tanaes/whopping_Voron_mods/Z_belt_cable_cover/README.md

# Z belt cover with cable routing

Made these to enable safe routing of cables up into the corner extrusions. 

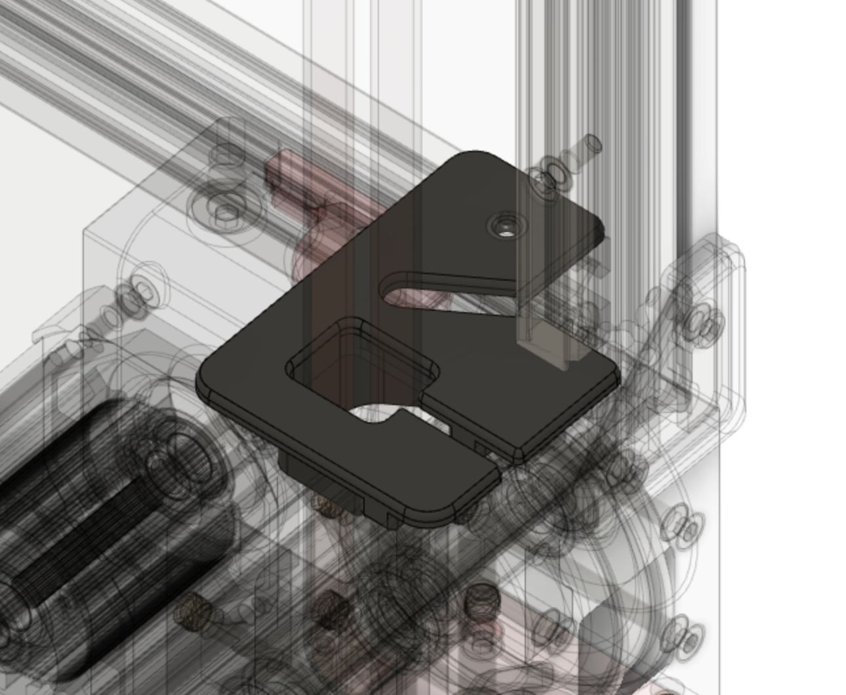
[picture p57: Z_belt_cable_cover/images/above.png]

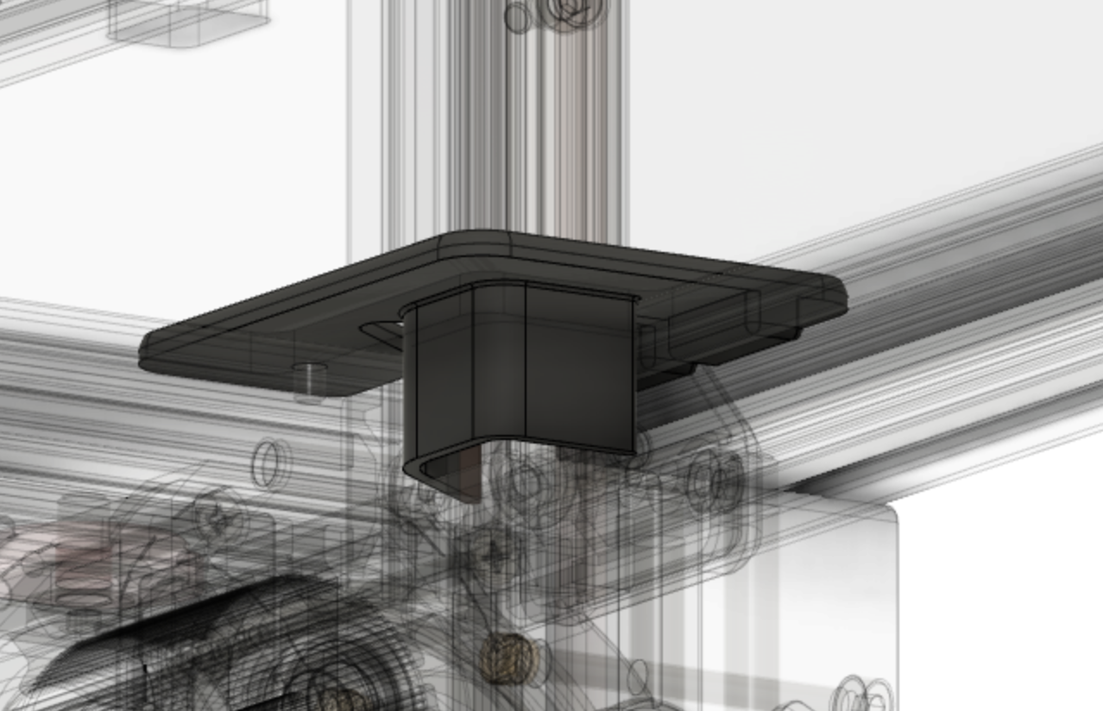
[picture p58: Z_belt_cable_cover/images/below.png]
