tanaes/whopping_Voron_mods/docs/frame_expansion/README.md

# Frame Thermal Compensation Documentation

This here's a compendium of my testing of alchemyEngine's awesome [frame expansion compensation](https://github.com/alchemyEngine/klipper/tree/work-frame-expansion-20210410) code for Klipper. 

## Installation overview and results

[How I got things up and running](./frame_thermal_compensation_howto.md) on my V2.4x350, plus test results.

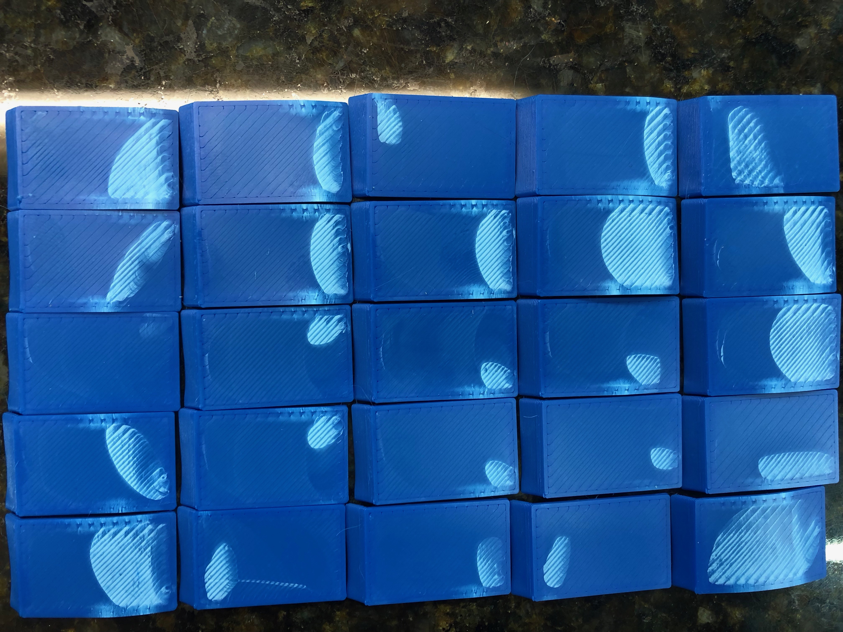
[picture p65: docs/frame_expansion/figures/test_print-si_comp-hot-bottom.jpeg]


## Data analysis

[Some R code I wrote](./gantry_factor_calc.html) to explore the results of my data

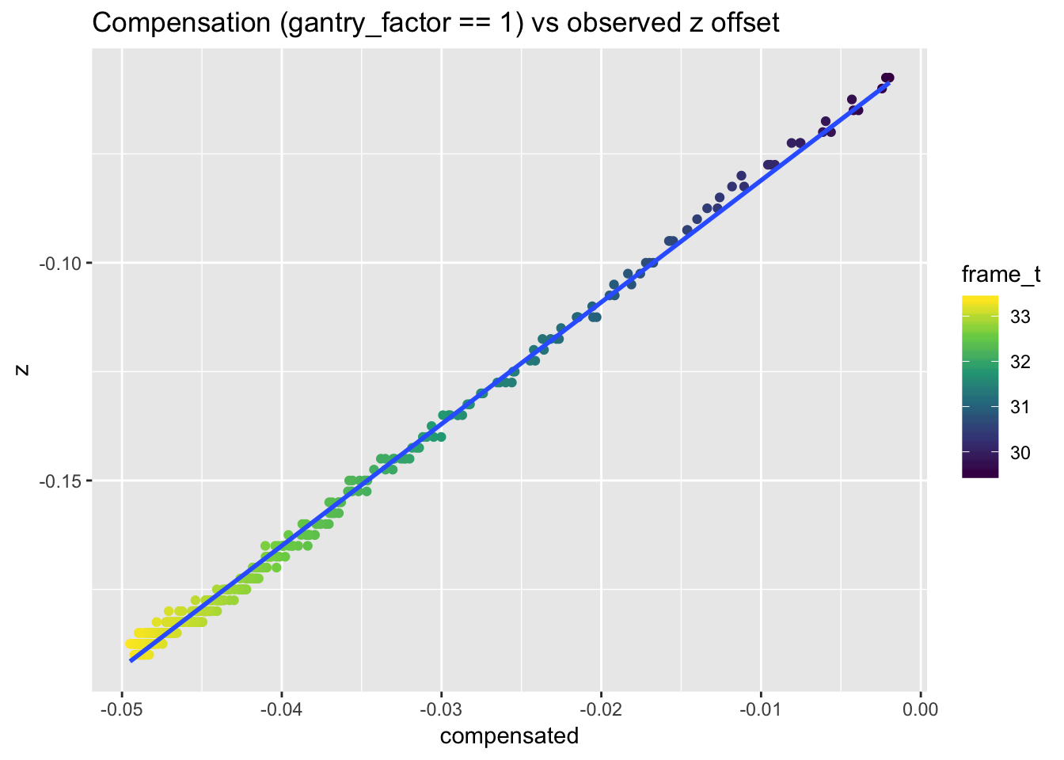
[picture p66: docs/frame_expansion/figures/gantry_factor.png]
