tanaes/whopping_Voron_mods/GE5C/mods/garyd9/README.md

Alternate version of WP's GE5C mod...

THIS MODIFICATION DOES NOT WORK WITH THE HALL EFFECT SENSOR.  

The objectives of this modification were to:

1. Allow the use of a M5x20 button head screw instead of the M5x25 socket head

2. To remove the need for more than 1 M5 shim per joint

3. Provide room for loosening and tightening the M3 screw in the "z belt clip lower" while everything is assembled. (This allows re-squaring the gantry while everything is assembled.)

Installation instructions are similar to WP's modification with the following changes:  The included "z belt clip lower" part should be used instead of the normal one.  Use a M5x20 button head (a socket head would also work) screw instead of the M5x25 SHCS, use a M3x12 socket or button head as the second screw for the "z belt clip lower", and only use a single 1mm M5 shim per corner.
