tanaes/whopping_Voron_mods/extrusion_backers/images/sim_450_3mm.png

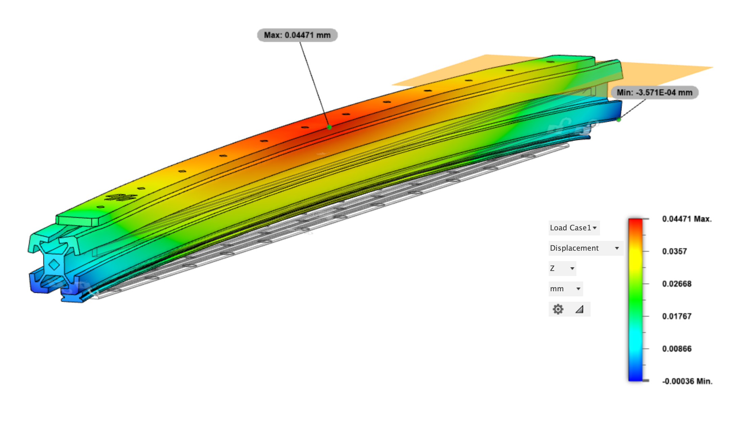
extrusion_backers/images/sim_450_3mm.png
