tanaes/whopping_Voron_mods/extrusion_backers/images/sim_450_mgn9.png

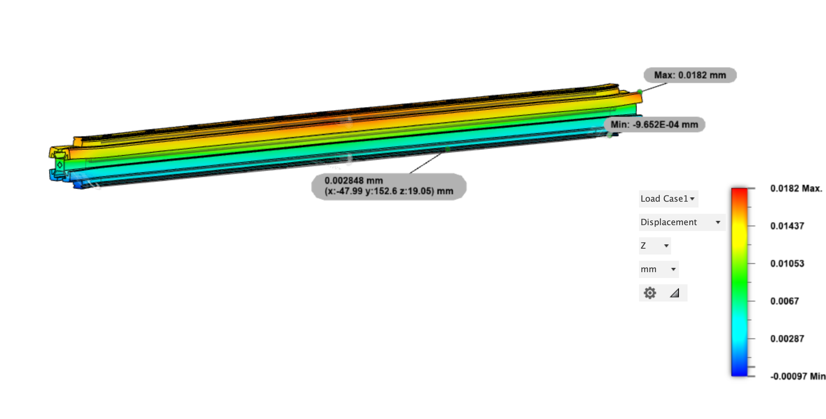
extrusion_backers/images/sim_450_mgn9.png
