tanaes/whopping_Voron_mods/extrusion_backers/images/sim_450_nobacker.png

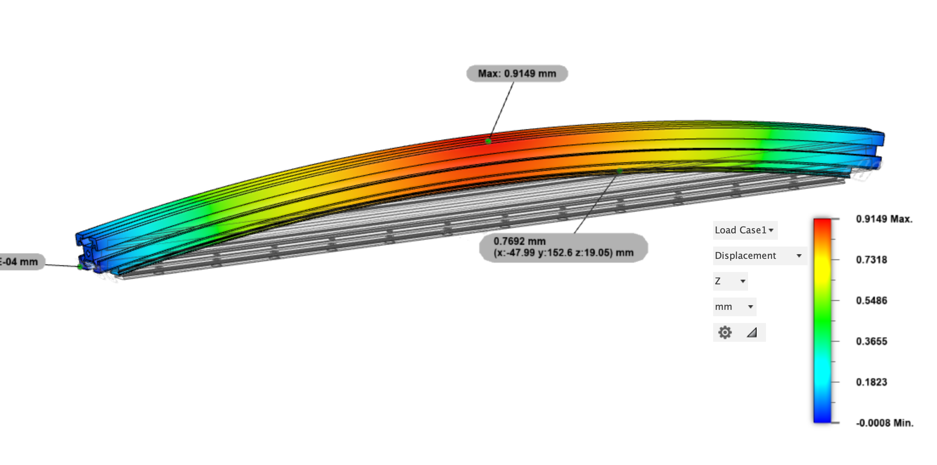
extrusion_backers/images/sim_450_nobacker.png
