tanaes/whopping_Voron_mods/GE5C/Images/hall_effect.png

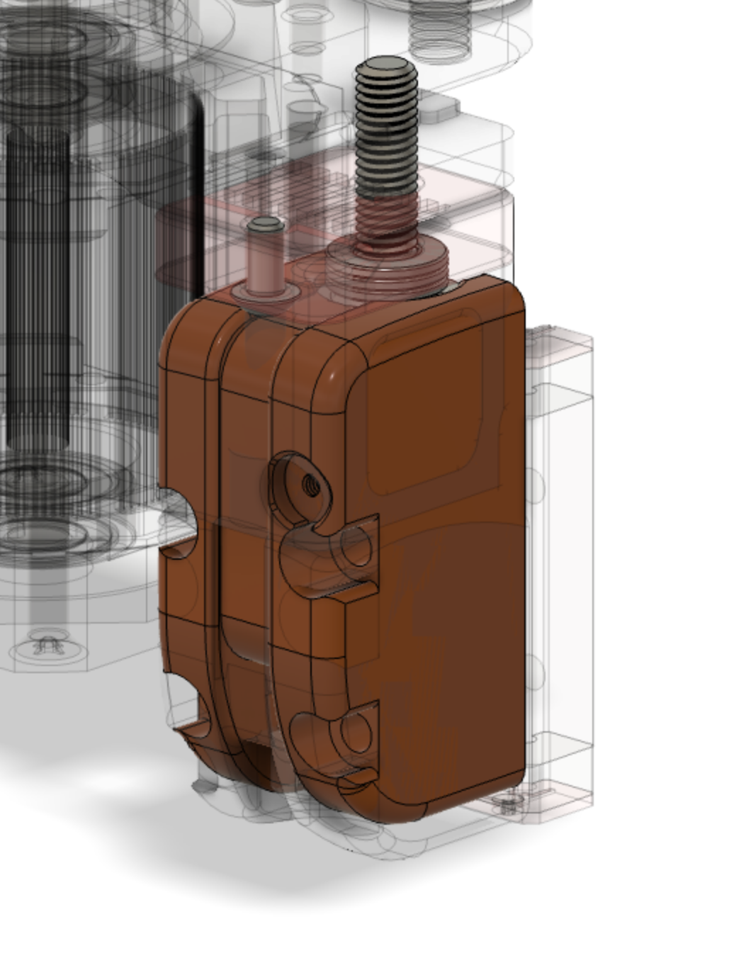
GE5C/Images/hall_effect.png
