tanaes/whopping_Voron_mods/GE5C/Images/screw_clearance.png

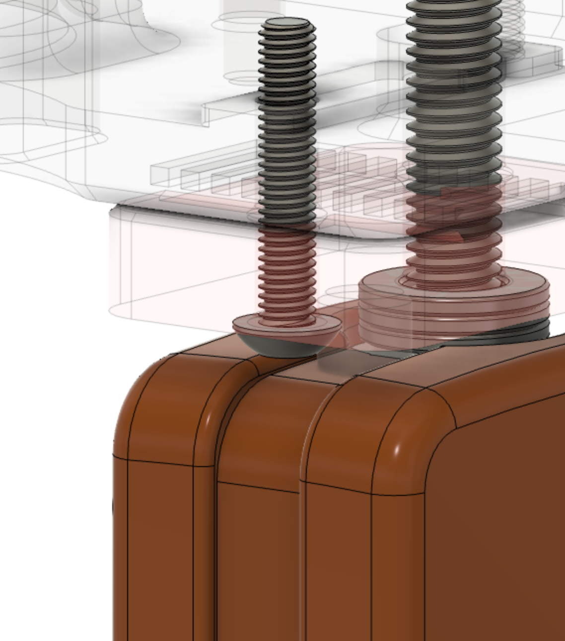
GE5C/Images/screw_clearance.png
