tanaes/whopping_Voron_mods/kinematesque_bed/images/detail.png

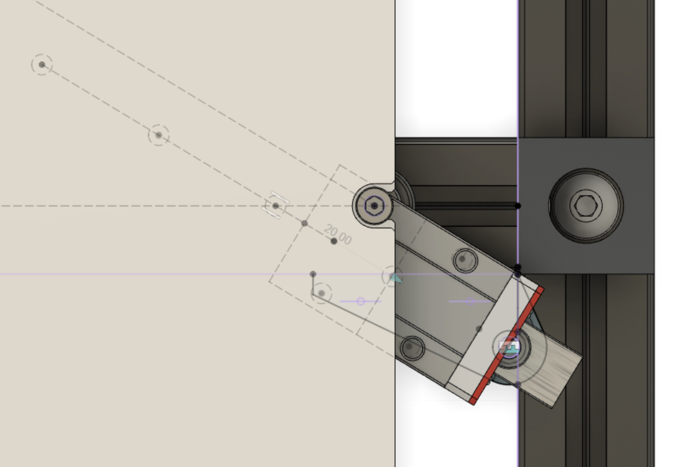
kinematesque_bed/images/detail.png
