tanaes/whopping_Voron_mods/kinematesque_bed/images/front.png

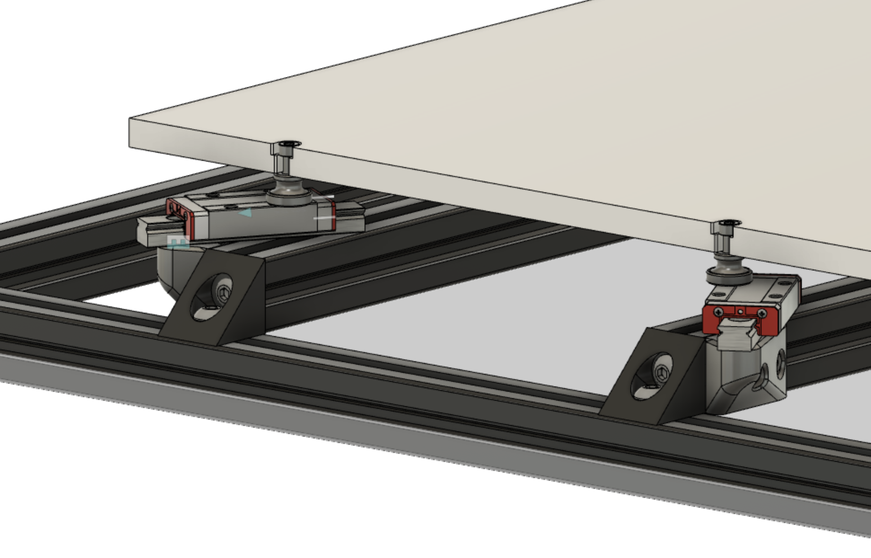
kinematesque_bed/images/front.png
