tanaes/whopping_Voron_mods/kinematesque_bed/images/overview.png

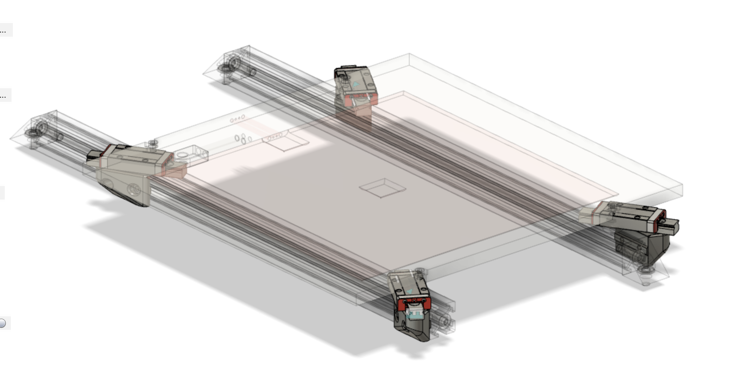
kinematesque_bed/images/overview.png
