tanaes/whopping_Voron_mods/kinematesque_bed/images/plan.png

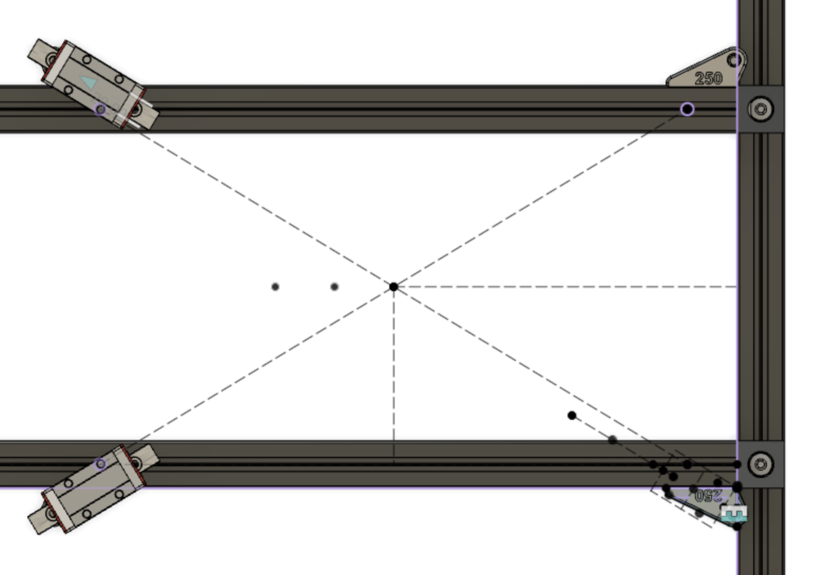
kinematesque_bed/images/plan.png
