tanaes/whopping_Voron_mods/kinematic_bed/Images/Screen Shot 2021-11-20 at 7.35.48 PM.png

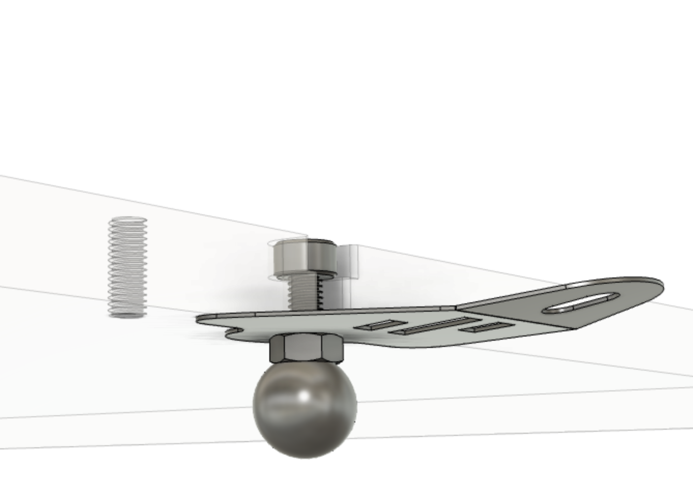
kinematic_bed/Images/Screen Shot 2021-11-20 at 7.35.48 PM.png
