tanaes/whopping_Voron_mods/kinematic_bed/Images/spring_bend.png

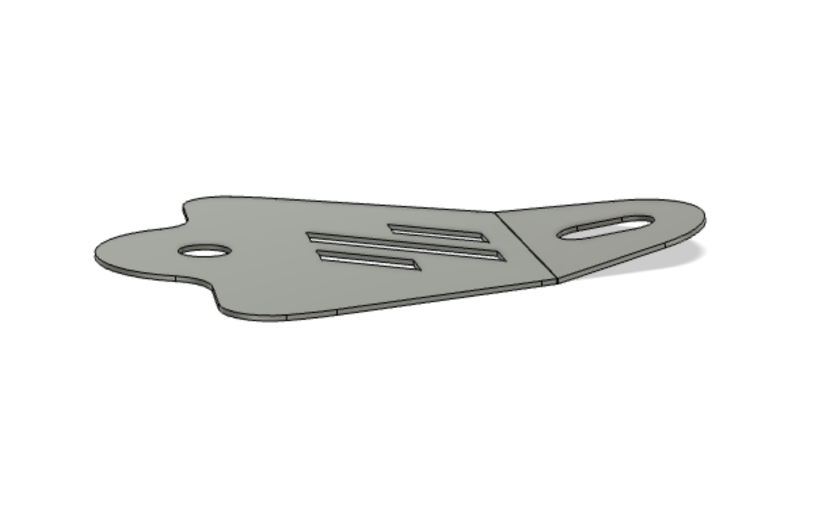
kinematic_bed/Images/spring_bend.png
