tanaes/whopping_Voron_mods/pcb_klicky/Images/bottom_comparison.png

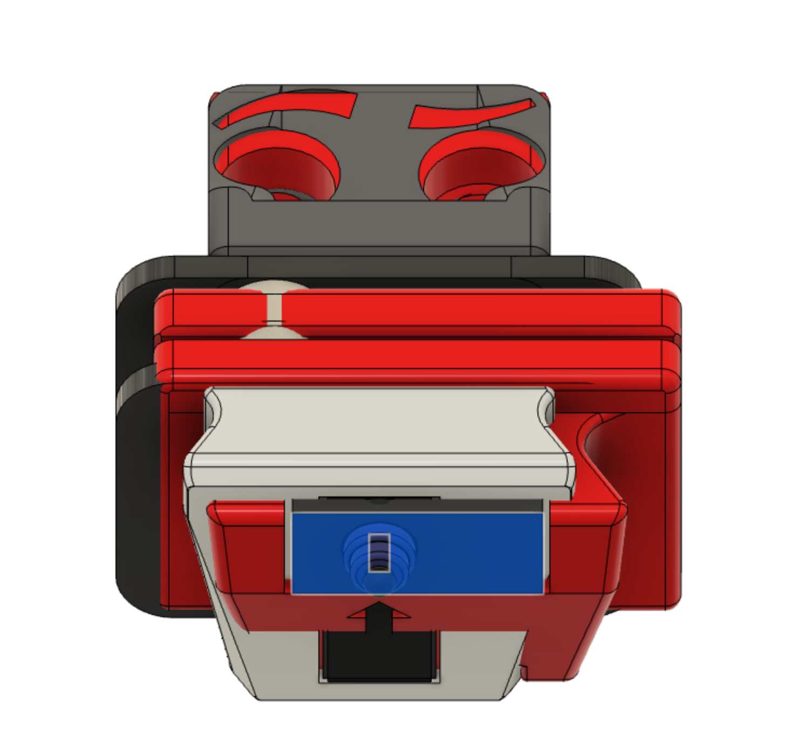
pcb_klicky/Images/bottom_comparison.png
