tanaes/whopping_Voron_mods/pcb_klicky/Images/bottom_elevation.png

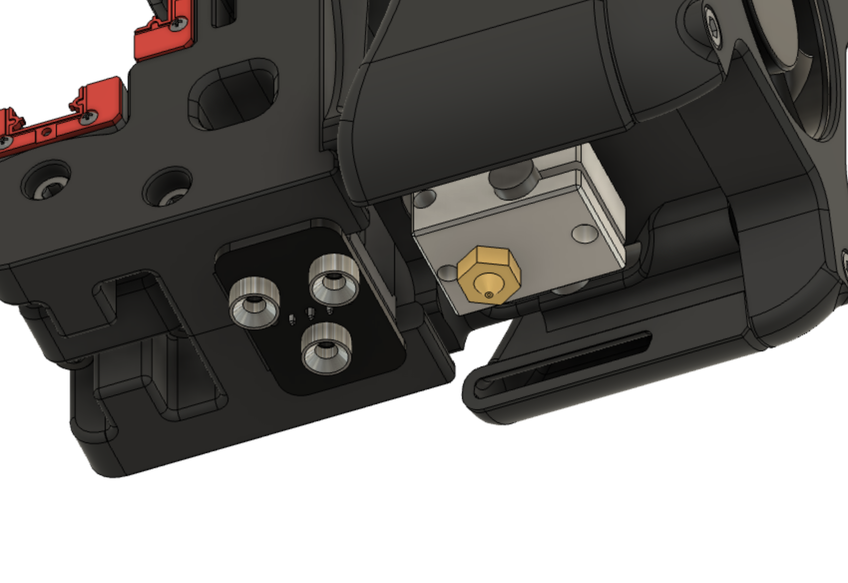
pcb_klicky/Images/bottom_elevation.png
