tanaes/whopping_Voron_mods/pcb_klicky/Images/bottom_view.png

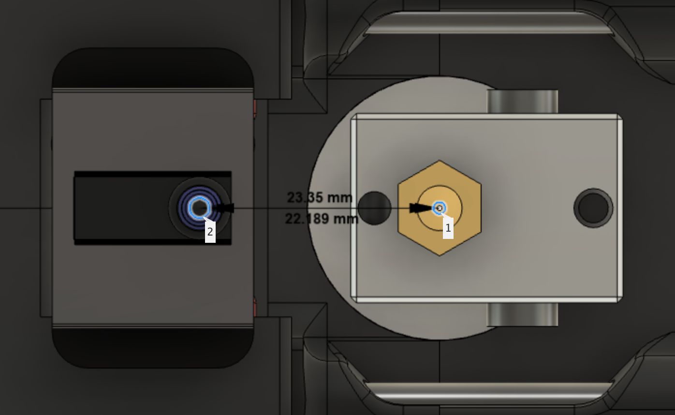
pcb_klicky/Images/bottom_view.png
