tanaes/whopping_Voron_mods/pcb_klicky/Images/front_view.png

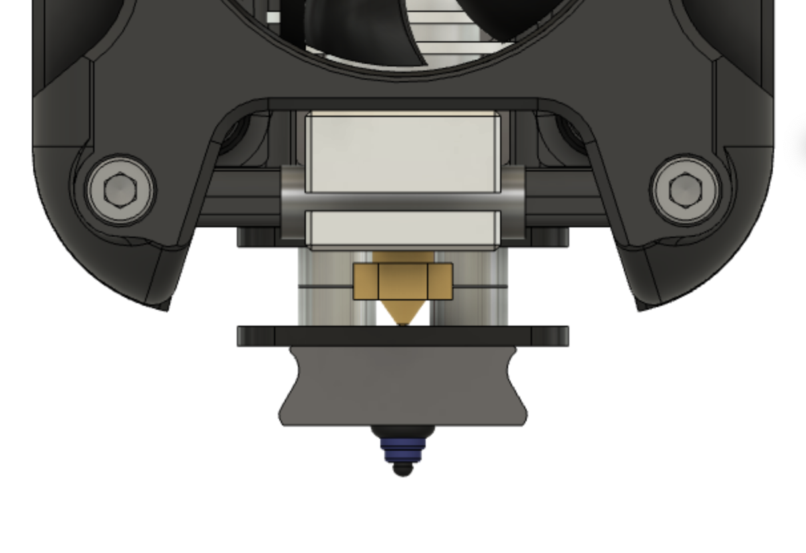
pcb_klicky/Images/front_view.png
