tanaes/whopping_Voron_mods/pcb_klicky/Images/perspective_snowy.png

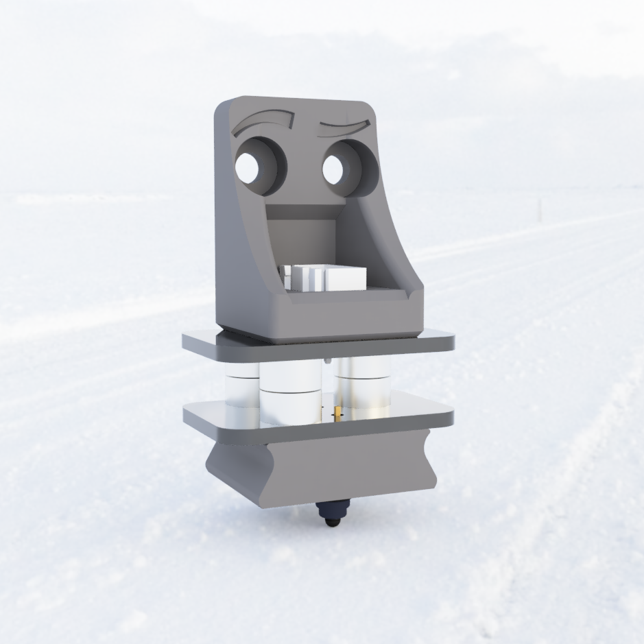
pcb_klicky/Images/perspective_snowy.png
