tanaes/whopping_Voron_mods/pcb_klicky/Images/side_view.png

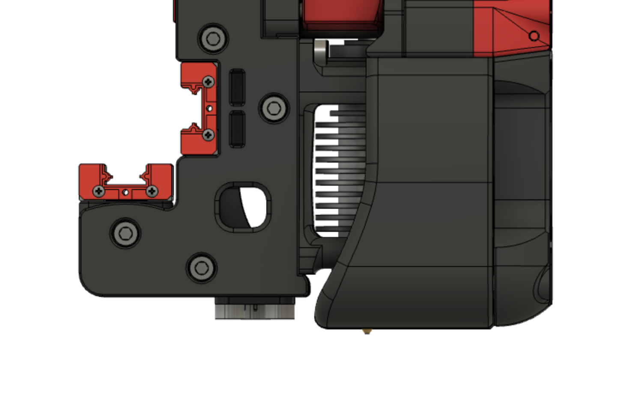
pcb_klicky/Images/side_view.png
