tanaes/whopping_Voron_mods/LEDs/Rainbow_Barf_Logo_LED/Production_Files/bom.csv

Comment | Designator | Footprint | LCSC Part Number
100nF | C1 | 0402 | C307331
470R | R1 | 0402 | C25117
WS2812B-2020 | D1 | 2.0x2.0mm | C965555
WS2812B-2020 | D2 | 2.0x2.0mm | C965555
WS2812B-2020 | D3 | 2.0x2.0mm | C965555
WS2812B-2020 | D4 | 2.0x2.0mm | C965555
WS2812B-2020 | D5 | 2.0x2.0mm | C965555
WS2812B-2020 | D6 | 2.0x2.0mm | C965555
WS2812B-2020 | D7 | 2.0x2.0mm | C965555
WS2812B-2020 | D8 | 2.0x2.0mm | C965555
