tanaes/whopping_Voron_mods/pcb_klicky/PCB_Klicky_rev3/PCB_Klicky_rev3/gerber/Klicky_PCB_-_SMD_BOM.csv

Comment | Designator | Footprint | LCSC Part Number
2.2K | R1 | 0603 | C4190
470R | R2 | 0603 | C23179
470R | R3 | 0603 | C23179
Red LED | D1 | LED_0603 | C2286
