tanaes/whopping_Voron_mods/pcb_klicky/PCB_Klicky_rev3/PCB_Klicky_rev3/jlcpcb/assembly/BOM-Untitled.csv

Comment | Designator | Footprint | LCSC
LTST-C191TBKT | D1 | D_0603_1608Metric | C2286
200 | R2 | R_0603_1608Metric | C22962
2K1 | R1 | R_0603_1608Metric | C4190
