tanaes/whopping_Voron_mods/badge/graphcis/badge_outline.dxf

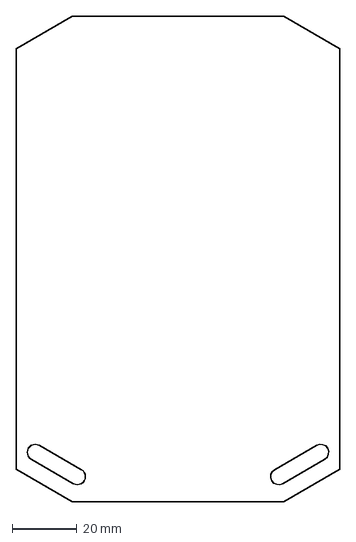
[picture p85: CAD file, 2023-05-02]
badge/graphcis/badge_outline.dxf
100.0 x 150.0 mm
