tanaes/whopping_Voron_mods/badge/voron_badge/voron_badge-back.3mf

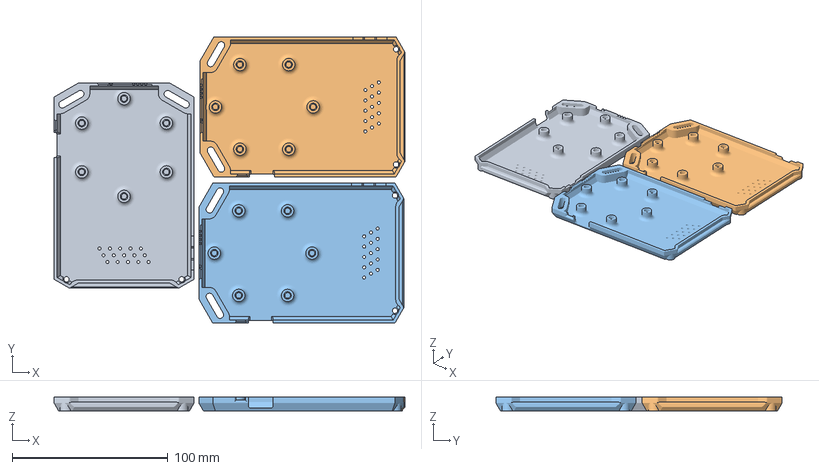
[picture p86: CAD file, 2023-05-02]
badge/voron_badge/voron_badge-back.3mf
225.5 x 183.9 x 9.00 mm
voron_badge-back.stl x 3
