tanaes/whopping_Voron_mods/clickyclacky_door/STLs/Latch.stl

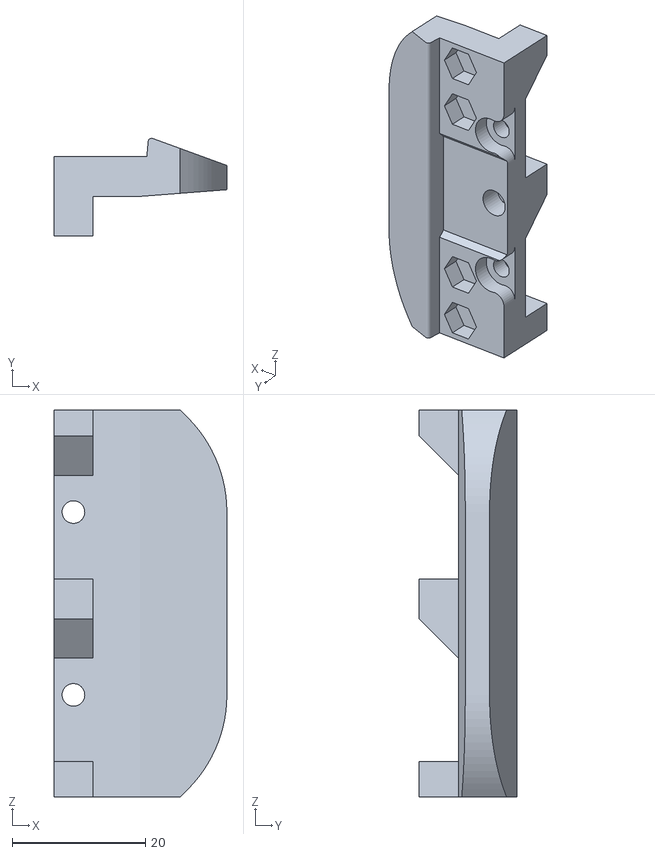
[picture p87: CAD file, 2023-10-13]
clickyclacky_door/STLs/Latch.stl
25.9 x 14.6 x 58.0
