tanaes/whopping_Voron_mods/docs/frame_expansion/gcode/expansion_test_print-Voron_ABS.3mf

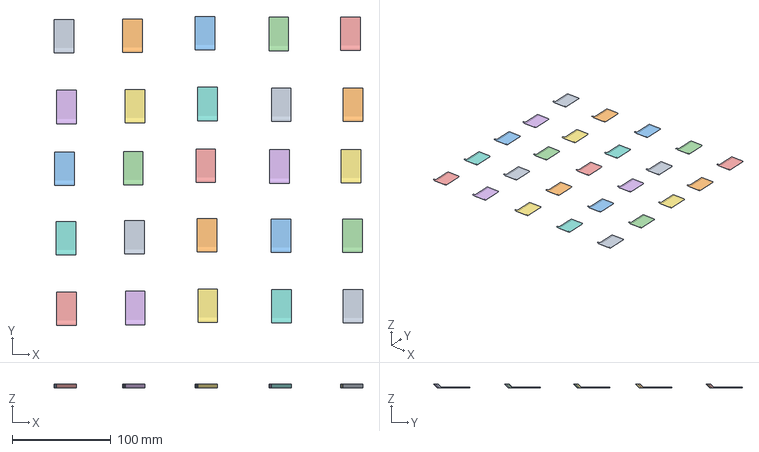
[picture p88: CAD file, 2021-06-14]
docs/frame_expansion/gcode/expansion_test_print-Voron_ABS.3mf
312.5 x 312.5 x 4.00 mm
test_sample v1.stl x 25
