tanaes/whopping_Voron_mods/docs/frame_expansion/stls/test_sample v1.stl

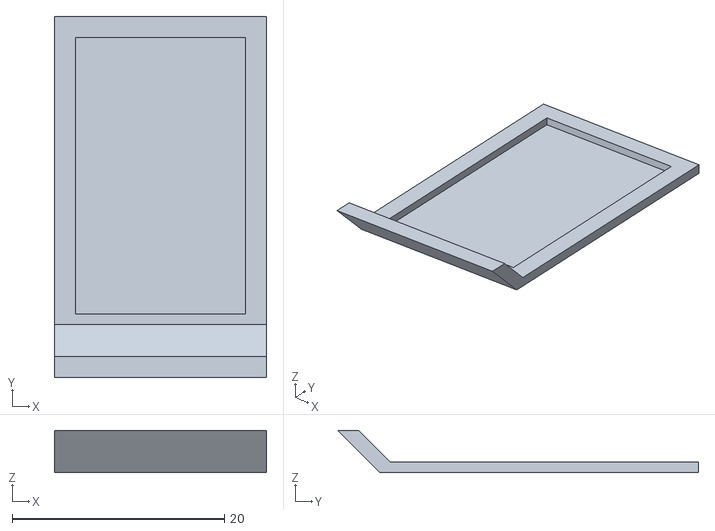
[picture p89: CAD file, 2021-06-14]
docs/frame_expansion/stls/test_sample v1.stl
20.0 x 34.0 x 4.00
