tanaes/whopping_Voron_mods/extrusion_backers/DXFs/Y_backer_chain-350.dxf

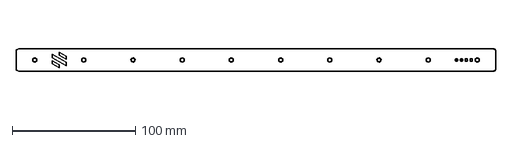
[picture p90: CAD file, 2023-05-09]
extrusion_backers/DXFs/Y_backer_chain-350.dxf
390.0 x 18.0 mm
