tanaes/whopping_Voron_mods/GE5C/mods/garyd9/GE5C_Z_carrier_x4.stl

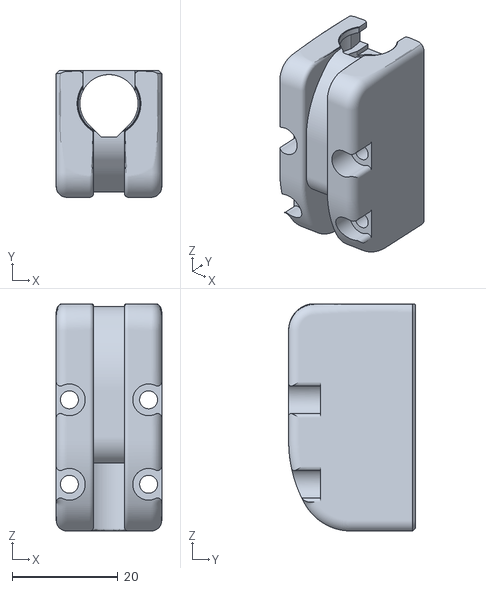
[picture p92: CAD file, 2022-04-04]
GE5C/mods/garyd9/GE5C_Z_carrier_x4.stl
20.0 x 24.0 x 43.0
