tanaes/whopping_Voron_mods/GE5C/STLs/GE5C_Z_carrier.stl

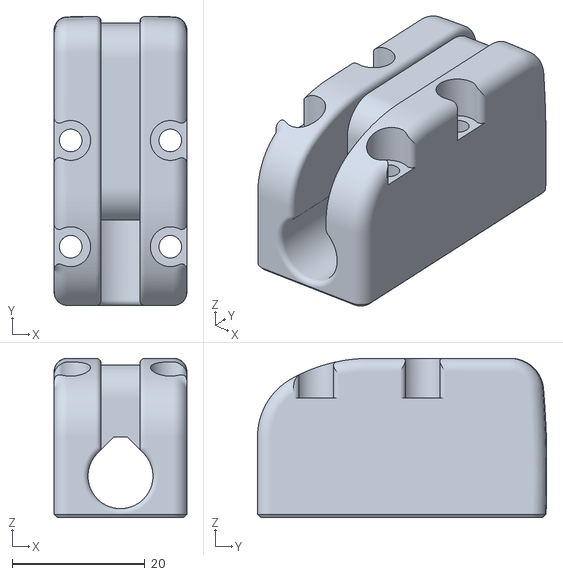
[picture p93: CAD file, 2022-03-22]
GE5C/STLs/GE5C_Z_carrier.stl
20.0 x 43.5 x 24.0
