tanaes/whopping_Voron_mods/kinematesque_bed/STLs/LFRB_mount-250.stl

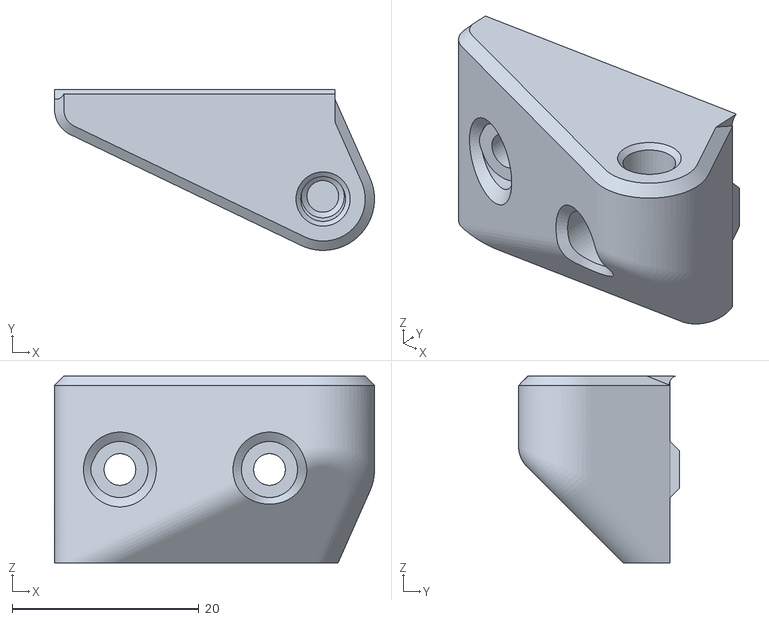
[picture p94: CAD file, 2022-01-17]
kinematesque_bed/STLs/LFRB_mount-250.stl
34.2 x 17.2 x 20.0
