tanaes/whopping_Voron_mods/kinematic_bed/DXFs/Trident/Trident_kinematic-left.step

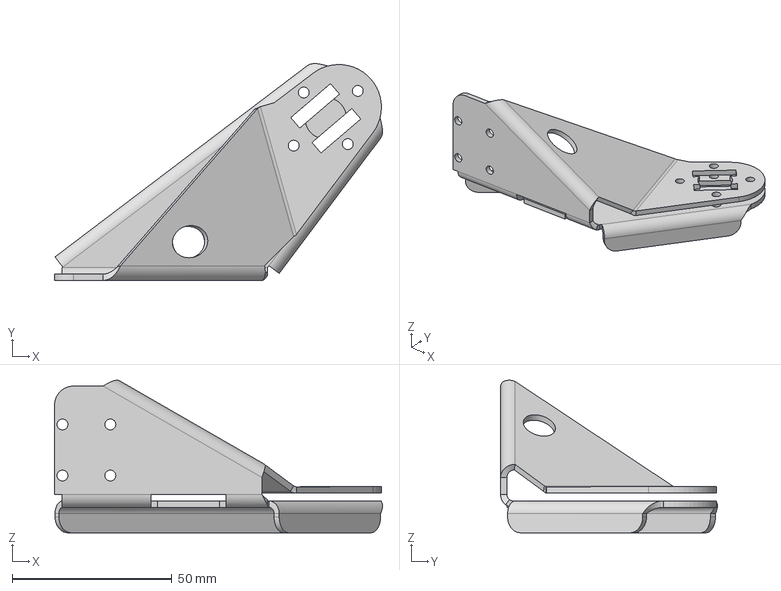
[picture p95: CAD file, 2022-04-28]
kinematic_bed/DXFs/Trident/Trident_kinematic-left.step
102.8 x 67.9 x 47.8 mm
