tanaes/whopping_Voron_mods/kinematic_bed/DXFs/v24/F-back_bottom.dxf

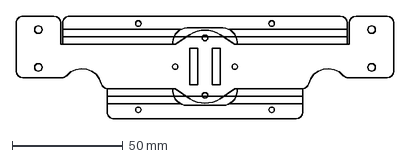
[picture p96: CAD file, 2022-04-04]
kinematic_bed/DXFs/v24/F-back_bottom.dxf
170.1 x 46.1 mm
