tanaes/whopping_Voron_mods/LEDs/Rainbow_Barf_Logo_LED/STLs/led_carrier_rev2.stl

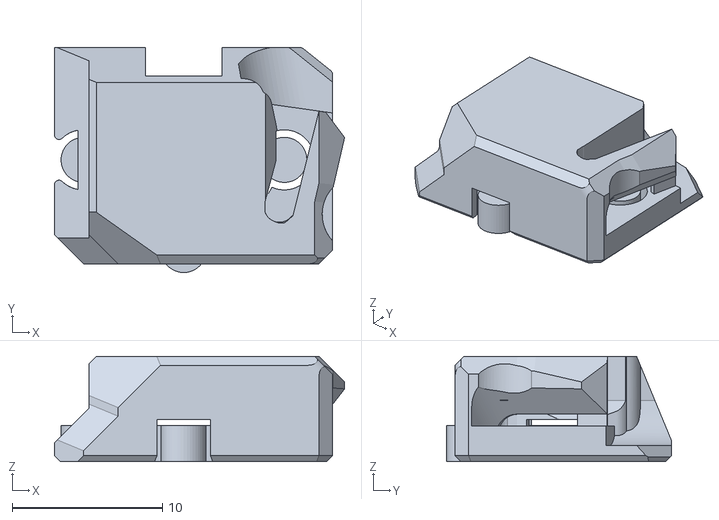
[picture p97: CAD file, 2022-10-07]
LEDs/Rainbow_Barf_Logo_LED/STLs/led_carrier_rev2.stl
19.3 x 15.0 x 7.01
