tanaes/whopping_Voron_mods/panel_clip_shims/STLs/corner_clip-5.5mm.stl

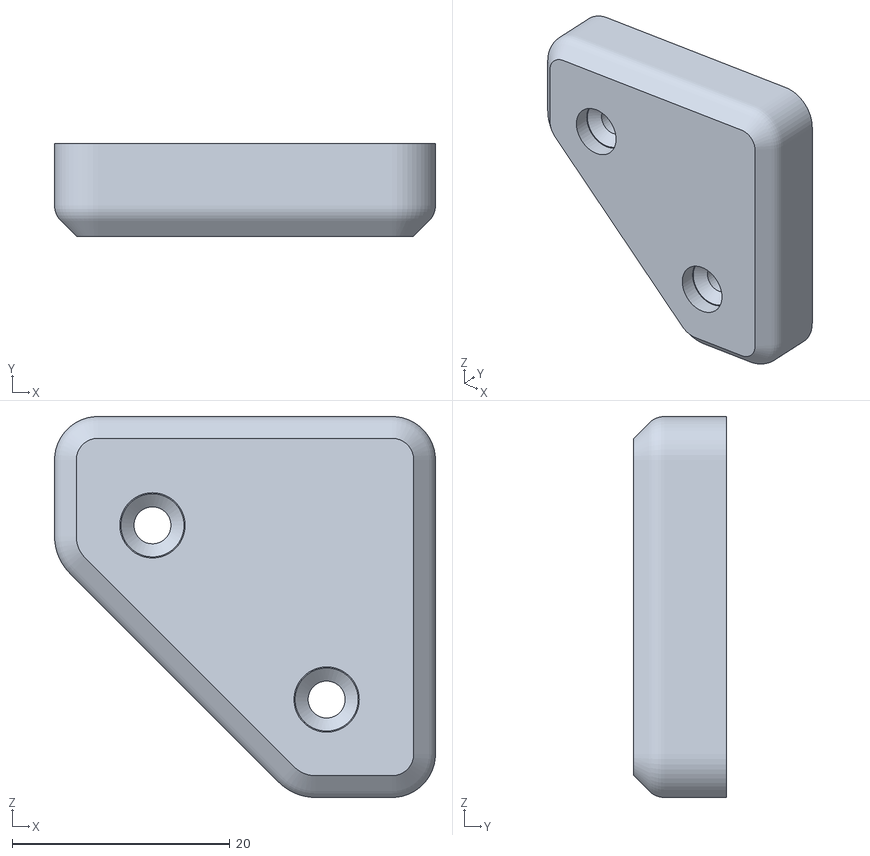
[picture p98: CAD file, 2021-09-21]
panel_clip_shims/STLs/corner_clip-5.5mm.stl
35.0 x 8.50 x 35.0
