tanaes/whopping_Voron_mods/pcb_klicky/STLs/probe-heatset-XL.stl

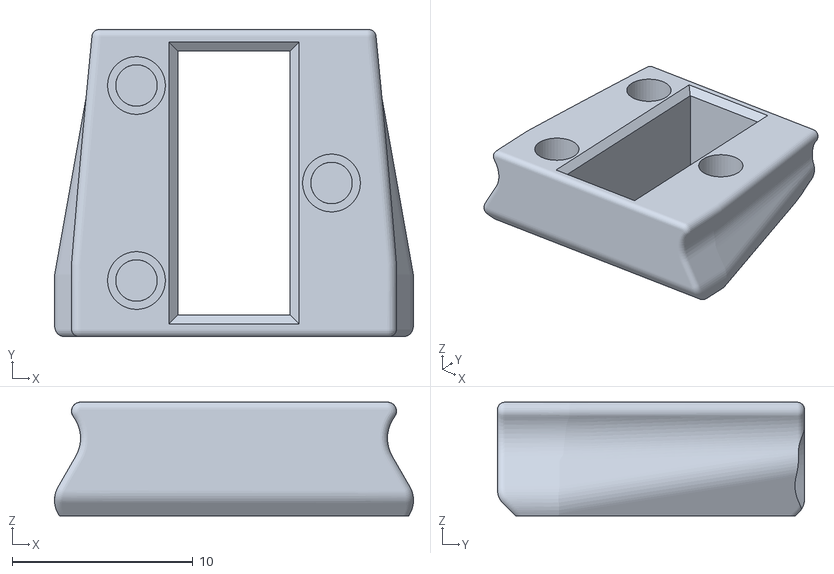
[picture p99: CAD file, 2022-11-02]
pcb_klicky/STLs/probe-heatset-XL.stl
19.9 x 17.0 x 6.30
