tanaes/whopping_Voron_mods/side_skirts/STLs/side_skirt-plug_panel-350.stl

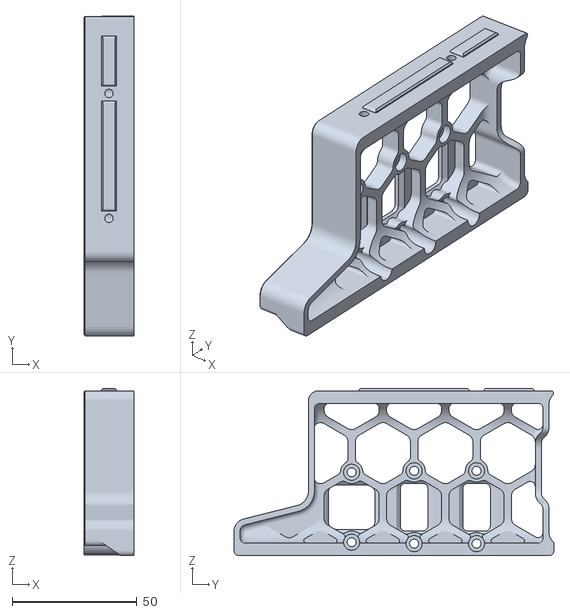
[picture p100: CAD file, 2021-06-11]
side_skirts/STLs/side_skirt-plug_panel-350.stl
20.0 x 128.1 x 67.0
