tanaes/whopping_Voron_mods/umbilical_passthrough/STLs/PG7_cable_gland_housing.stl

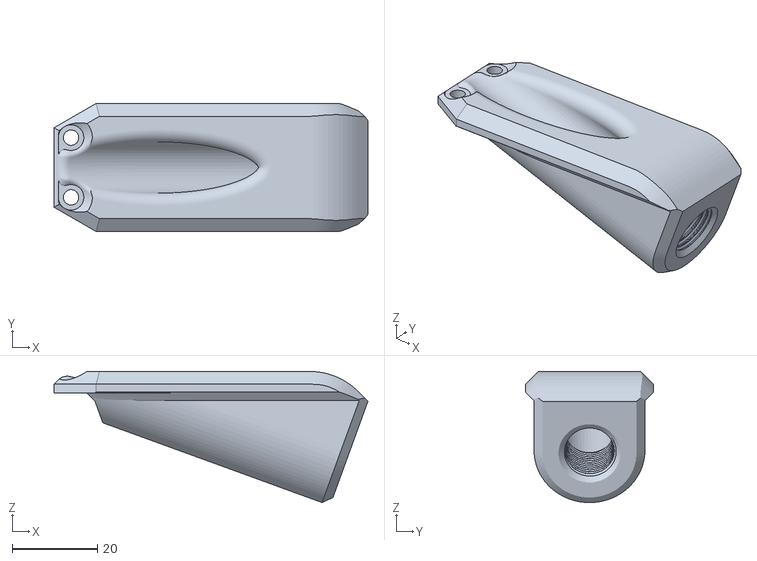
[picture p101: CAD file, 2023-10-20]
umbilical_passthrough/STLs/PG7_cable_gland_housing.stl
73.6 x 30.0 x 30.7
