tanaes/whopping_Voron_mods/universal_bed/Universal Build Plate 300.step

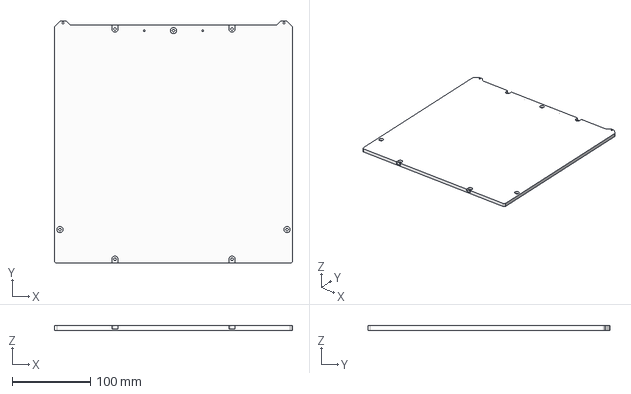
[picture p102: CAD file, 2022-05-19]
universal_bed/Universal Build Plate 300.step
305.0 x 310.5 x 6.00 mm
