tanaes/whopping_Voron_mods/z_ball_joints/STLs/lever.stl

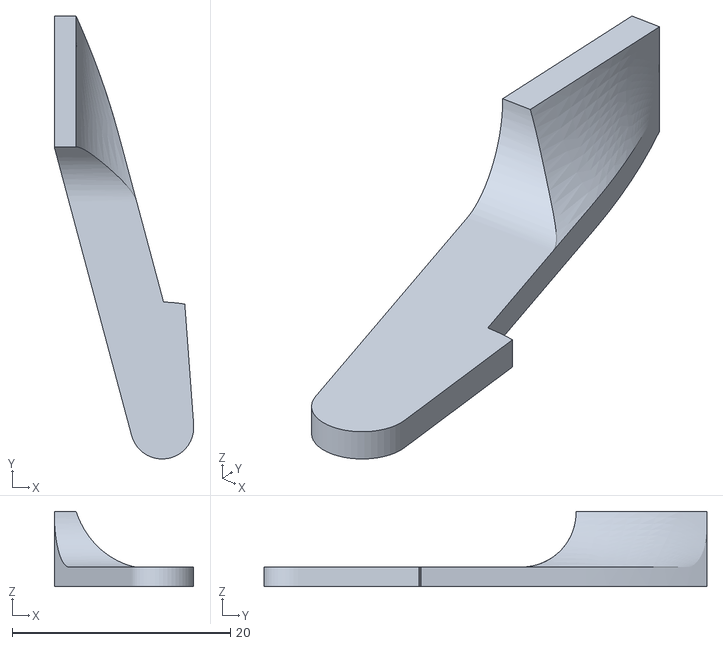
[picture p103: CAD file, 2023-08-17]
z_ball_joints/STLs/lever.stl
12.8 x 40.6 x 6.90
