tanaes/whopping_Voron_mods/Z_belt_cable_cover/STL/Z_belt_cover_cable-route_R.stl

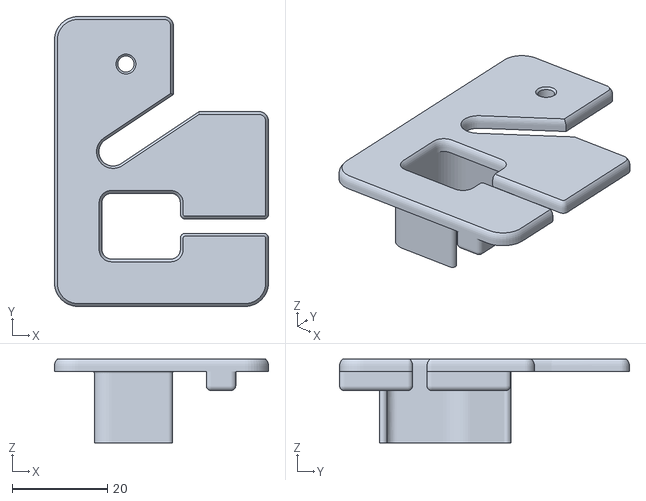
[picture p104: CAD file, 2021-06-06]
Z_belt_cable_cover/STL/Z_belt_cover_cable-route_R.stl
45.0 x 61.0 x 17.6
