tanaes/whopping_Voron_mods/badge/graphcis/smaller_badge_outline_gfx.dxf

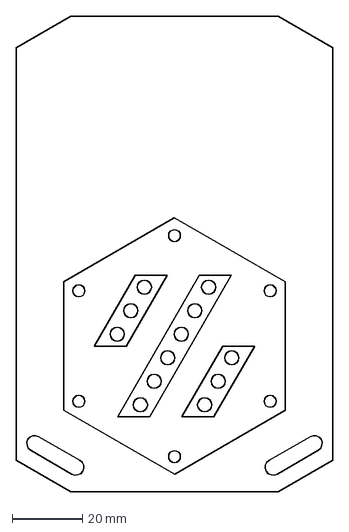
[picture p105: CAD file, 2023-05-02]
badge/graphcis/smaller_badge_outline_gfx.dxf
90.0 x 135.0 mm
