tanaes/whopping_Voron_mods/badge/voron_badge/pcb_stencil_holder.stl

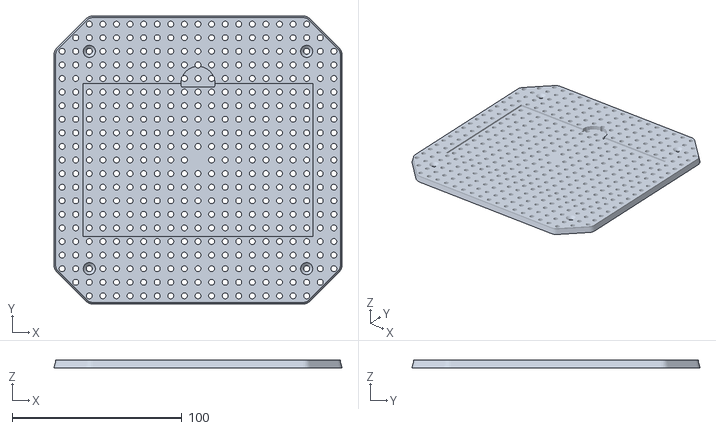
[picture p106: CAD file, 2023-05-02]
badge/voron_badge/pcb_stencil_holder.stl
169.6 x 169.6 x 5.00
