tanaes/whopping_Voron_mods/clickyclacky_door/STLs/Handle-Hinge_Top.stl

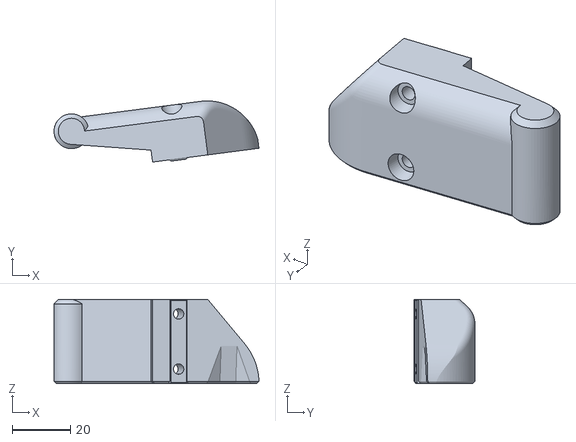
[picture p107: CAD file, 2023-08-04]
clickyclacky_door/STLs/Handle-Hinge_Top.stl
70.6 x 21.1 x 29.0
