tanaes/whopping_Voron_mods/extrusion_backers/DXFs/Y_backer-250.dxf

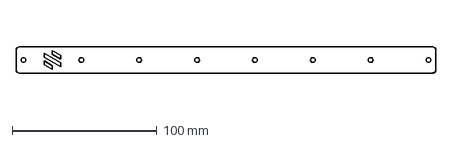
[picture p108: CAD file, 2023-05-09]
extrusion_backers/DXFs/Y_backer-250.dxf
290.0 x 18.0 mm
