tanaes/whopping_Voron_mods/extrusion_backers/STLs/XY_cable_chain_bridge-3hole-6.5mm_backer.stl

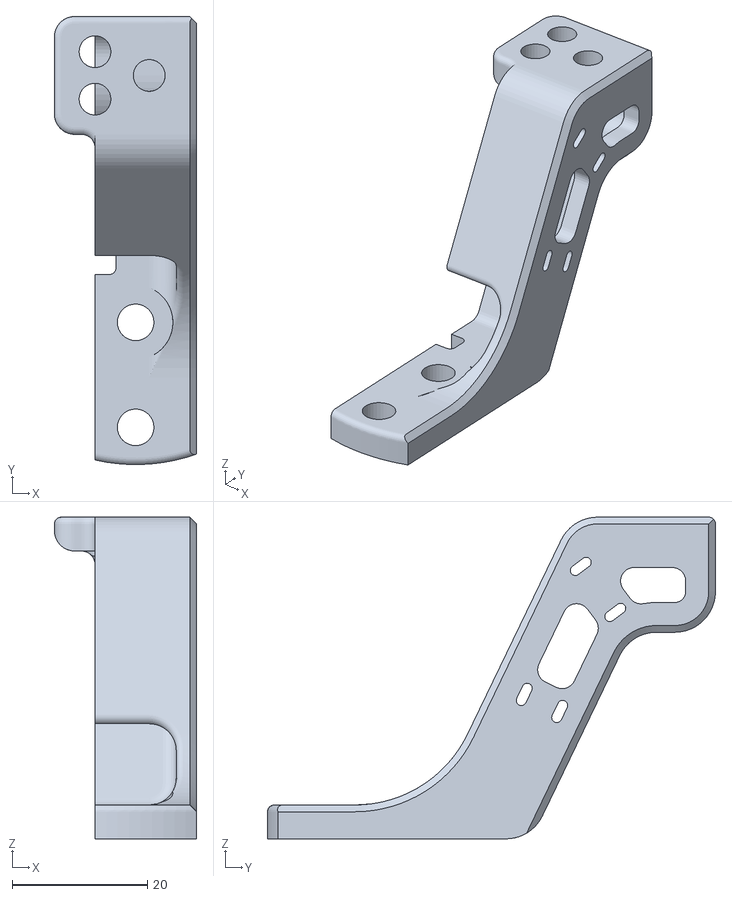
[picture p109: CAD file, 2021-08-05]
extrusion_backers/STLs/XY_cable_chain_bridge-3hole-6.5mm_backer.stl
21.0 x 66.1 x 47.5
