tanaes/whopping_Voron_mods/GE5C/mods/garyd9/[a]z_belt_clip_lower_x4.stl

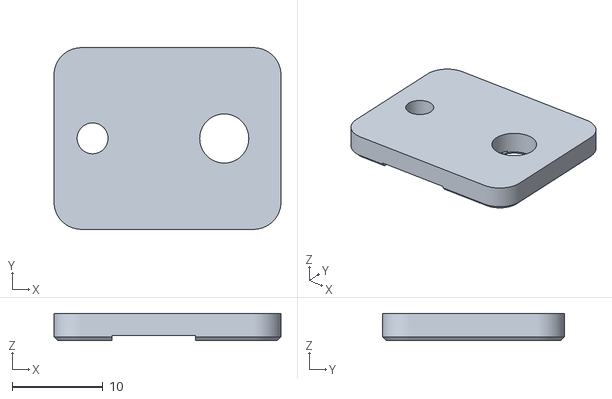
[picture p110: CAD file, 2022-04-04]
GE5C/mods/garyd9/[a]z_belt_clip_lower_x4.stl
25.0 x 20.0 x 3.00
