tanaes/whopping_Voron_mods/kinematic_bed/DXFs/Trident/trident_H-back_top.dxf

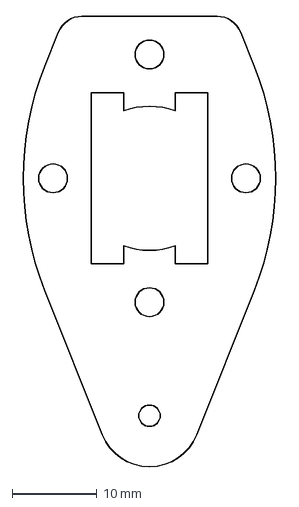
[picture p112: CAD file, 2022-04-28]
kinematic_bed/DXFs/Trident/trident_H-back_top.dxf
31.4 x 53.1 mm
