tanaes/whopping_Voron_mods/kinematic_bed/DXFs/v24/B-front_right_bottom.dxf

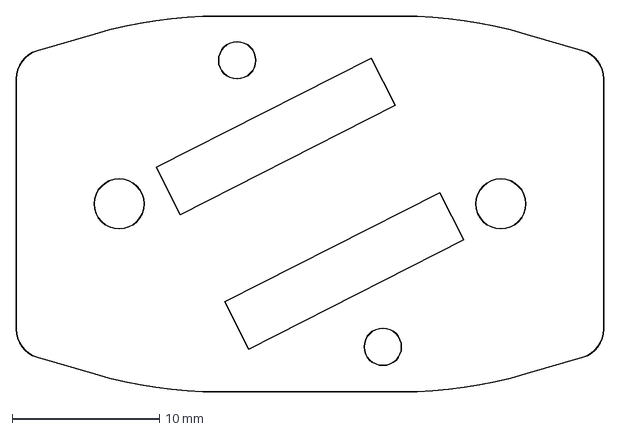
[picture p113: CAD file, 2022-02-04]
kinematic_bed/DXFs/v24/B-front_right_bottom.dxf
40.0 x 25.5 mm
