tanaes/whopping_Voron_mods/kinematic_bed/STLs/sandwich_spacers-back_center.stl

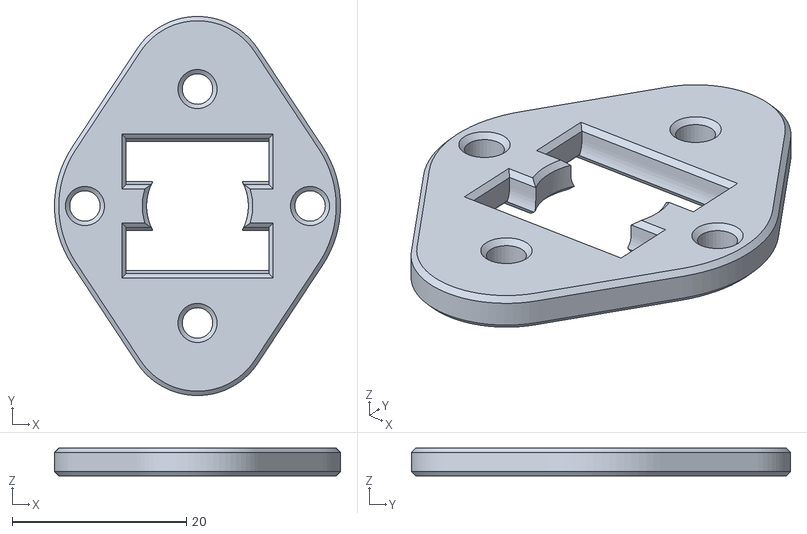
[picture p114: CAD file, 2022-02-28]
kinematic_bed/STLs/sandwich_spacers-back_center.stl
32.9 x 43.6 x 3.20
