tanaes/whopping_Voron_mods/LEDs/Rainbow_Barf_Logo_LED/STLs/[c]_stealthburner_LED_diffuser-beta3.stl

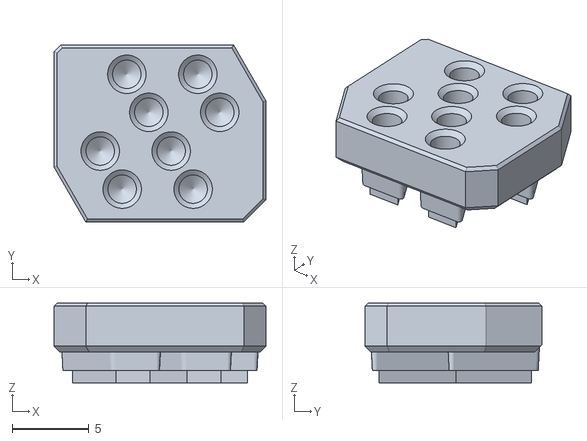
[picture p115: CAD file, 2022-08-04]
LEDs/Rainbow_Barf_Logo_LED/STLs/[c]_stealthburner_LED_diffuser-beta3.stl
13.8 x 11.5 x 5.20
