tanaes/whopping_Voron_mods/panel_clip_shims/STLs/corner_clip_shim-2mm.stl

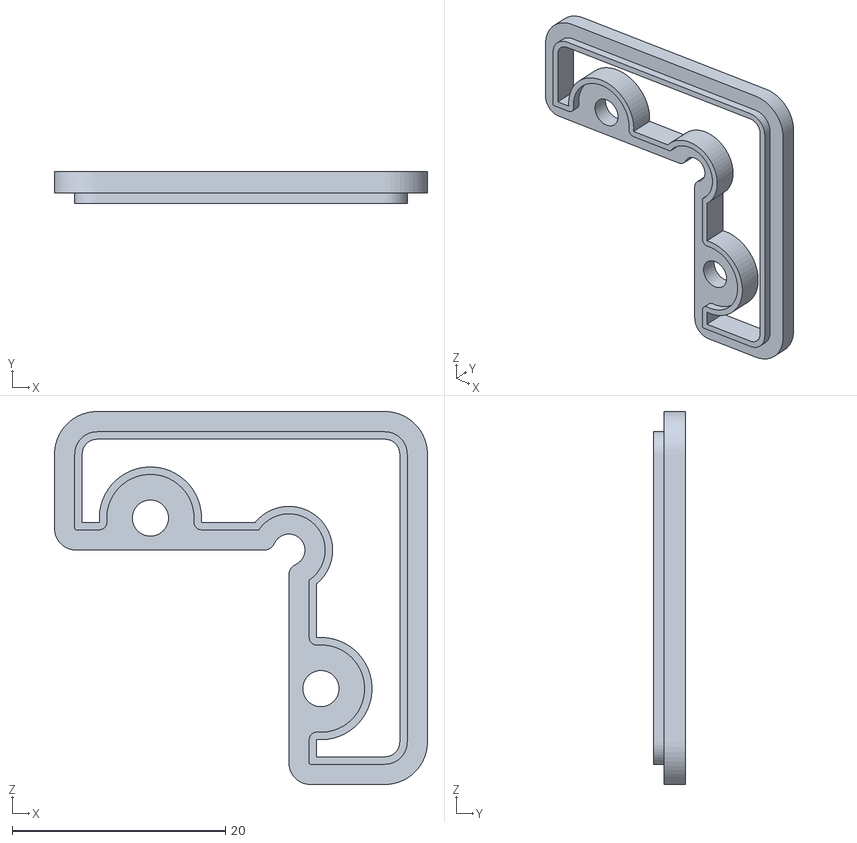
[picture p116: CAD file, 2021-09-21]
panel_clip_shims/STLs/corner_clip_shim-2mm.stl
35.0 x 3.00 x 35.0
