tanaes/whopping_Voron_mods/umbilical_passthrough/STLs/M12.5_cable_gland_housing.stl

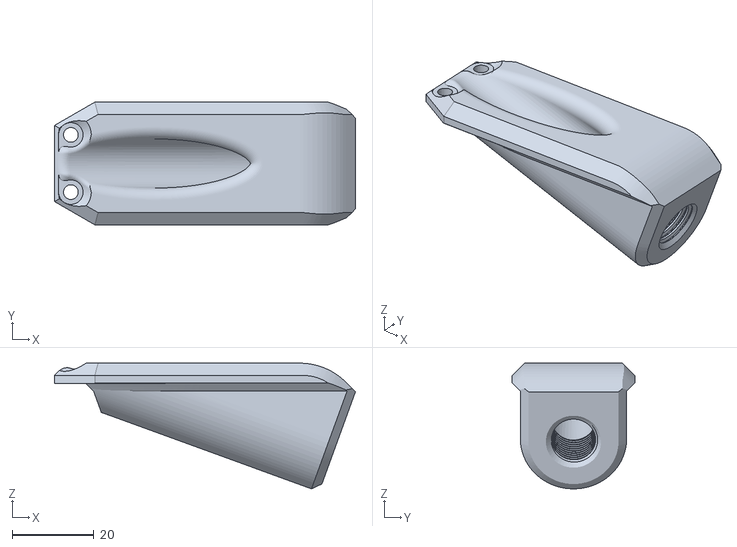
[picture p117: CAD file, 2023-10-16]
umbilical_passthrough/STLs/M12.5_cable_gland_housing.stl
73.6 x 30.0 x 30.7
