tanaes/whopping_Voron_mods/universal_bed/Universal Build Plate 250.step

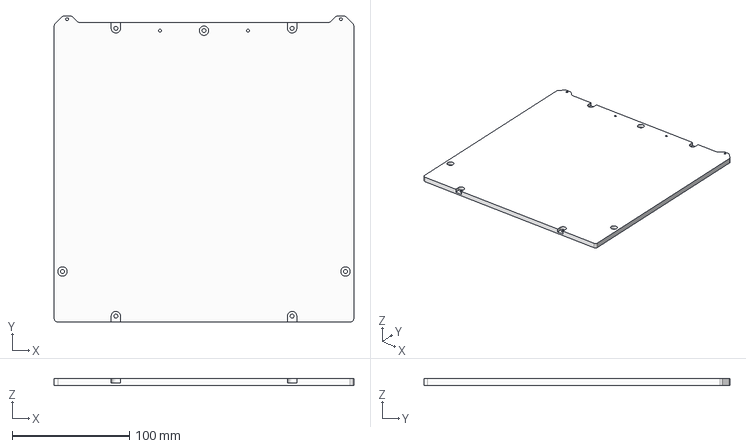
[picture p118: CAD file, 2022-05-19]
universal_bed/Universal Build Plate 250.step
255.0 x 260.5 x 6.00 mm
