tanaes/whopping_Voron_mods/z_ball_joints/STLs/compact_lower_mirrored.stl

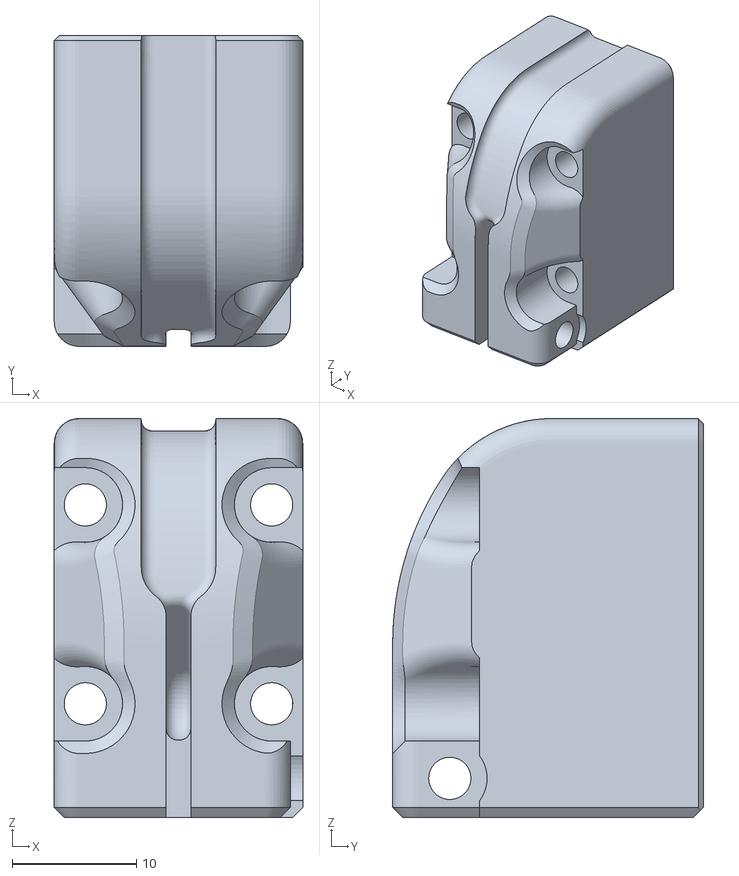
[picture p119: CAD file, 2023-08-17]
z_ball_joints/STLs/compact_lower_mirrored.stl
20.0 x 25.0 x 32.1
