tanaes/whopping_Voron_mods/badge/dfh_badge/diffuser.stl

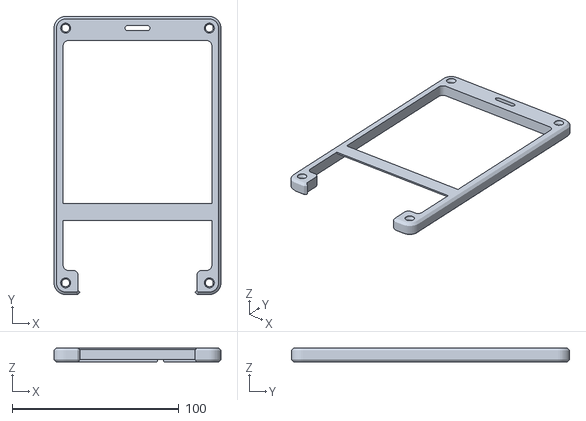
[picture p120: CAD file, 2023-05-02]
badge/dfh_badge/diffuser.stl
100.2 x 166.9 x 8.60
