tanaes/whopping_Voron_mods/badge/graphcis/smaller_badge_outline.dxf

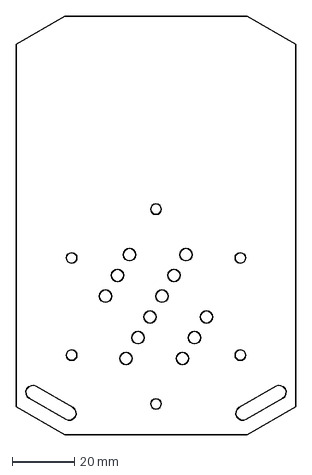
[picture p121: CAD file, 2023-05-02]
badge/graphcis/smaller_badge_outline.dxf
90.0 x 135.0 mm
