tanaes/whopping_Voron_mods/badge/voron_badge/badge_lasercut.dxf

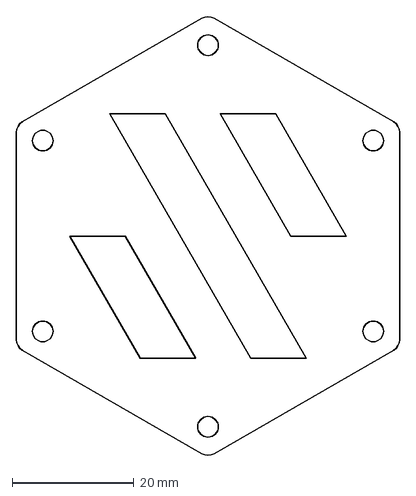
[picture p122: CAD file, 2023-05-02]
badge/voron_badge/badge_lasercut.dxf
63.0 x 72.3 mm
