tanaes/whopping_Voron_mods/extrusion_backers/DXFs/X_backer_chain-350.dxf

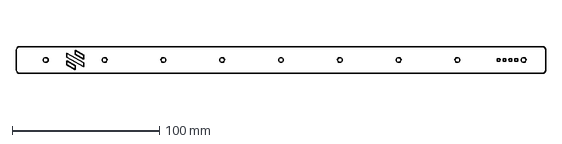
[picture p124: CAD file, 2023-05-09]
extrusion_backers/DXFs/X_backer_chain-350.dxf
360.0 x 18.0 mm
