tanaes/whopping_Voron_mods/GE5C/mods/garyd9/wp_GE5C - M5x20 mod v10.step

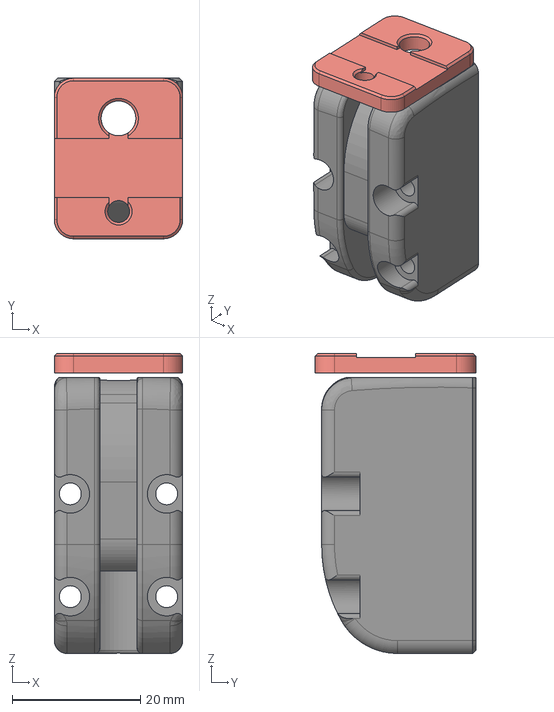
[picture p125: CAD file, 2022-04-04]
GE5C/mods/garyd9/wp_GE5C - M5x20 mod v10.step
20.0 x 25.0 x 46.7 mm
GE5C Z carrier
Z Belt Clamp Lower (2)
