tanaes/whopping_Voron_mods/kinematesque_bed/STLs/LFRB_mount-300.stl

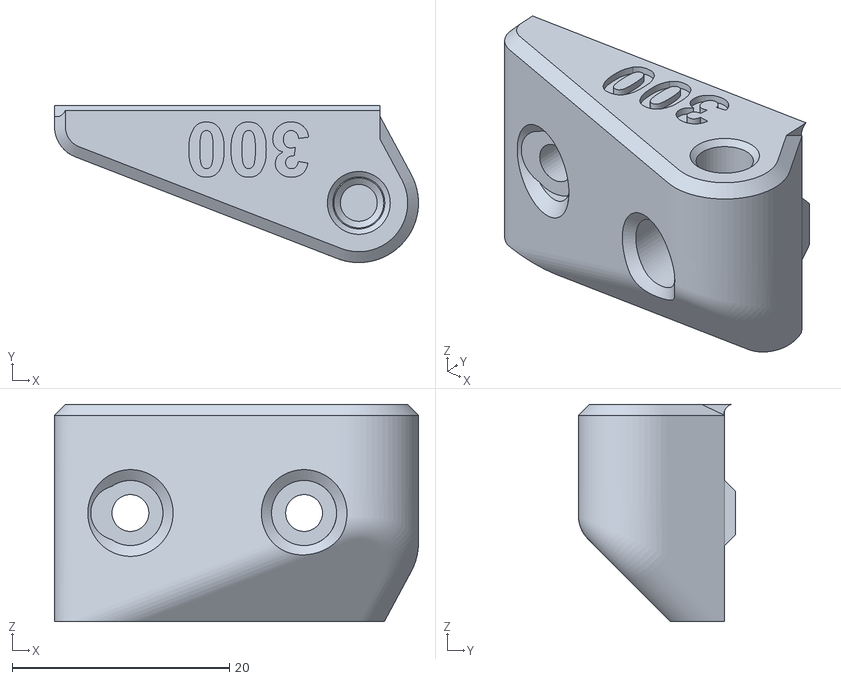
[picture p126: CAD file, 2022-01-17]
kinematesque_bed/STLs/LFRB_mount-300.stl
33.5 x 14.5 x 20.0
