tanaes/whopping_Voron_mods/kinematic_bed/DXFs/Trident/trident_F-right_bottom.dxf

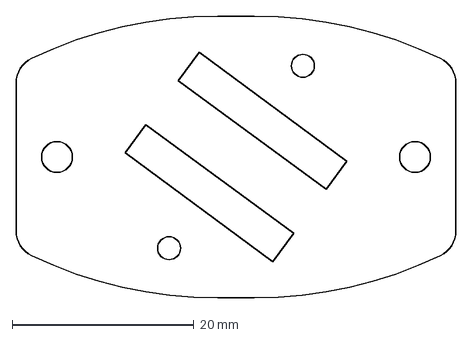
[picture p127: CAD file, 2022-04-28]
kinematic_bed/DXFs/Trident/trident_F-right_bottom.dxf
48.4 x 31.0 mm
