tanaes/whopping_Voron_mods/panel_clip_shims/STLs/midspan_clip-5.5mm.stl

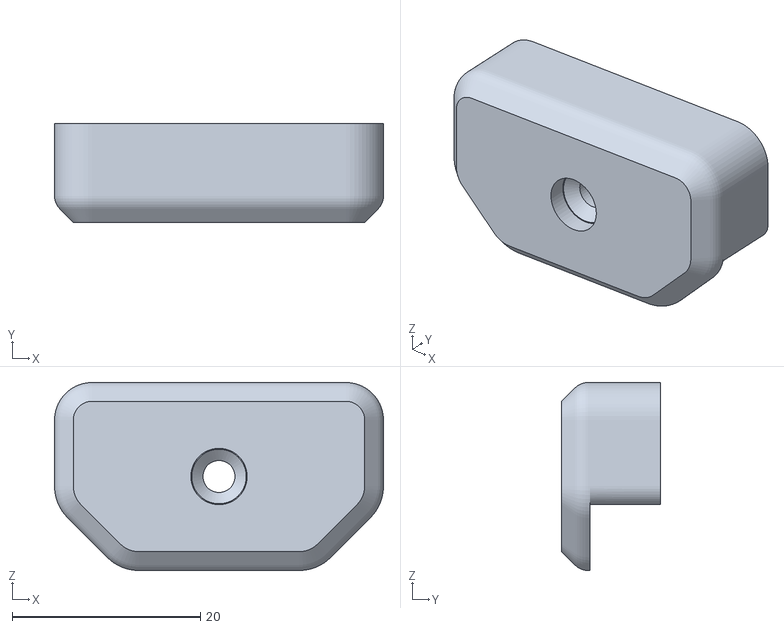
[picture p129: CAD file, 2021-09-21]
panel_clip_shims/STLs/midspan_clip-5.5mm.stl
35.0 x 10.5 x 20.0
