tanaes/whopping_Voron_mods/pcb_klicky/STLs/AB_mount-heatset.stl

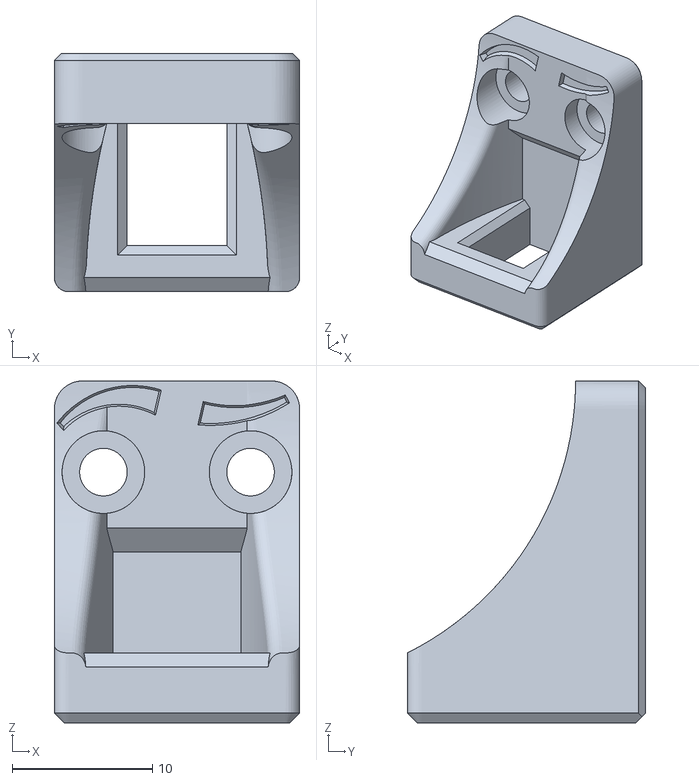
[picture p130: CAD file, 2022-11-02]
pcb_klicky/STLs/AB_mount-heatset.stl
17.5 x 17.0 x 24.4
