tanaes/whopping_Voron_mods/umbilical_passthrough/STLs/UmbilicalBlankingBackPlate-L-3mm.stl

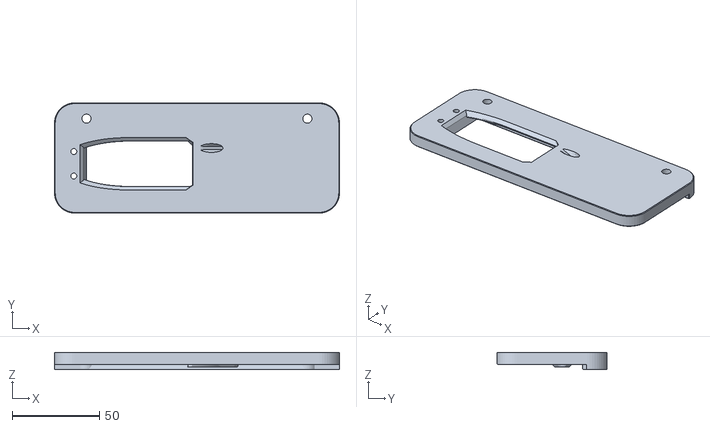
[picture p131: CAD file, 2023-10-16]
umbilical_passthrough/STLs/UmbilicalBlankingBackPlate-L-3mm.stl
163.0 x 63.0 x 10.0
