tanaes/whopping_Voron_mods/universal_bed/Universal Build Plate 350.step

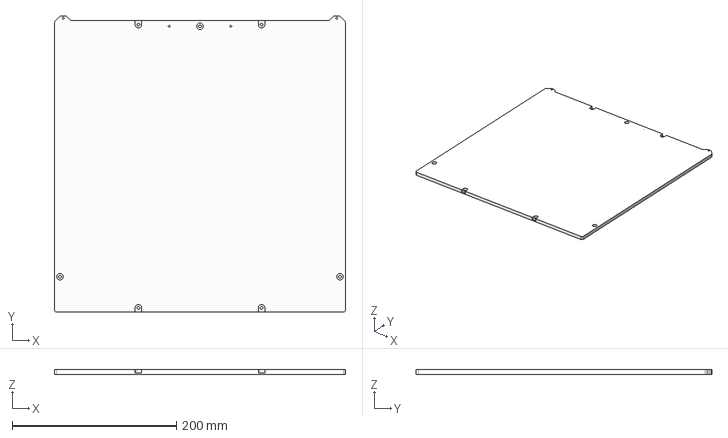
[picture p132: CAD file, 2022-05-19]
universal_bed/Universal Build Plate 350.step
355.0 x 360.5 x 6.00 mm
