tanaes/whopping_Voron_mods/z_ball_joints/STLs/compact_upper.stl

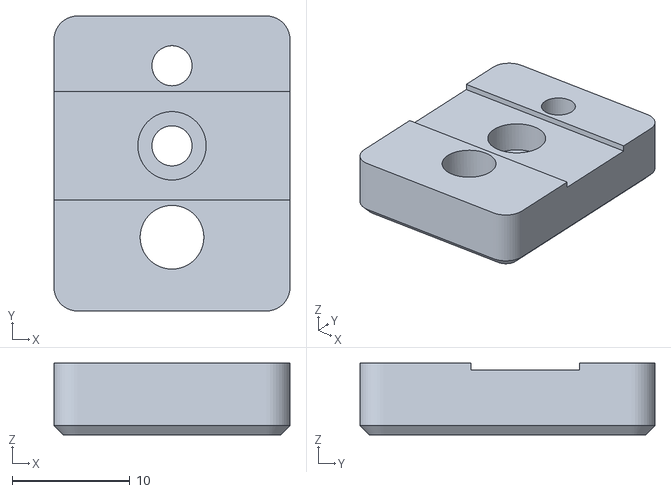
[picture p133: CAD file, 2023-08-17]
z_ball_joints/STLs/compact_upper.stl
20.0 x 25.0 x 6.10
