tanaes/whopping_Voron_mods/badge/dfh_badge/soldermask-fixed.dxf

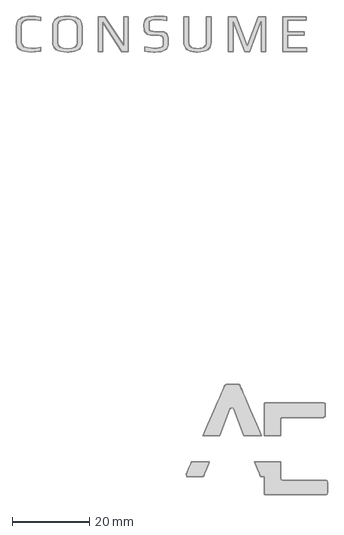
[picture p134: CAD file, 2023-05-02]
badge/dfh_badge/soldermask-fixed.dxf
80.7 x 124.2 mm
