tanaes/whopping_Voron_mods/clickyclacky_door/STLs/Panel_Clip.stl

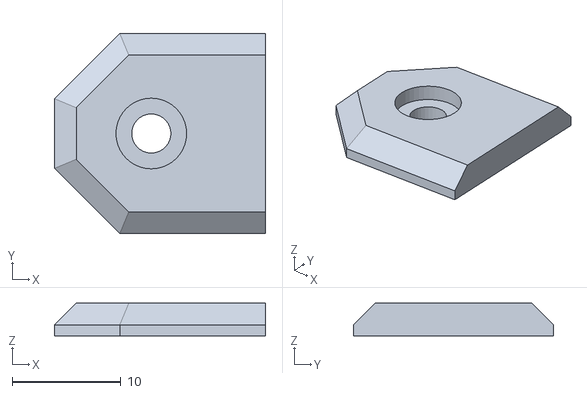
[picture p135: CAD file, 2023-08-04]
clickyclacky_door/STLs/Panel_Clip.stl
19.4 x 18.4 x 3.00
