tanaes/whopping_Voron_mods/kinematesque_bed/STLs/LFRB_mount-350.stl

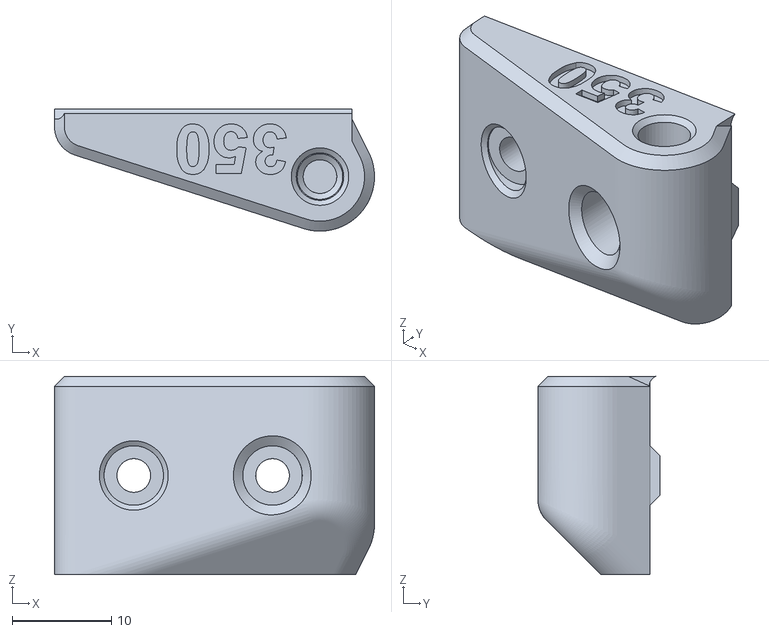
[picture p138: CAD file, 2022-01-17]
kinematesque_bed/STLs/LFRB_mount-350.stl
32.3 x 12.3 x 20.0
