tanaes/whopping_Voron_mods/kinematic_bed/DXFs/v24/A-front_right_top.dxf

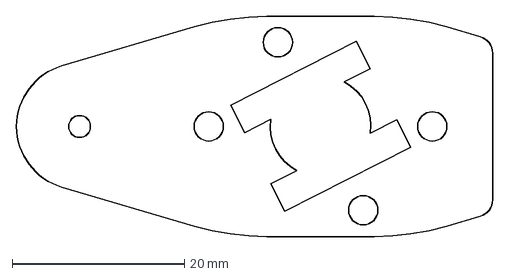
[picture p140: CAD file, 2022-02-04]
kinematic_bed/DXFs/v24/A-front_right_top.dxf
55.3 x 25.5 mm
