tanaes/whopping_Voron_mods/kinematic_bed/STLs/sandwich_spacers-front_right.stl

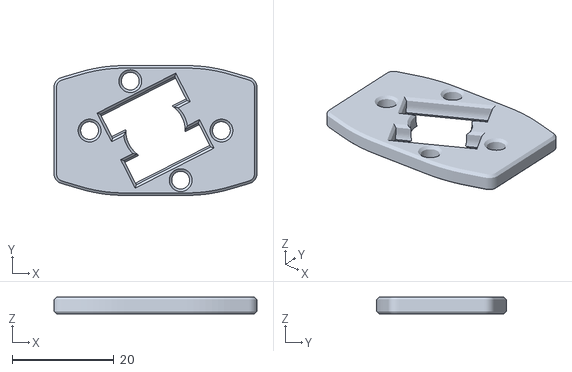
[picture p141: CAD file, 2022-02-28]
kinematic_bed/STLs/sandwich_spacers-front_right.stl
40.0 x 25.5 x 3.30
