tanaes/whopping_Voron_mods/panel_clip_shims/STLs/midspan_clip_shim-2mm.stl

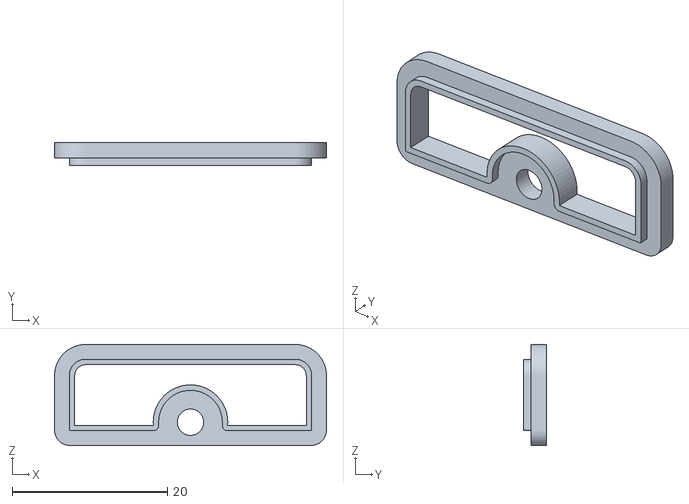
[picture p142: CAD file, 2021-09-21]
panel_clip_shims/STLs/midspan_clip_shim-2mm.stl
35.0 x 3.00 x 13.0
