tanaes/whopping_Voron_mods/pcb_klicky/STLs/dock-front_insert.stl

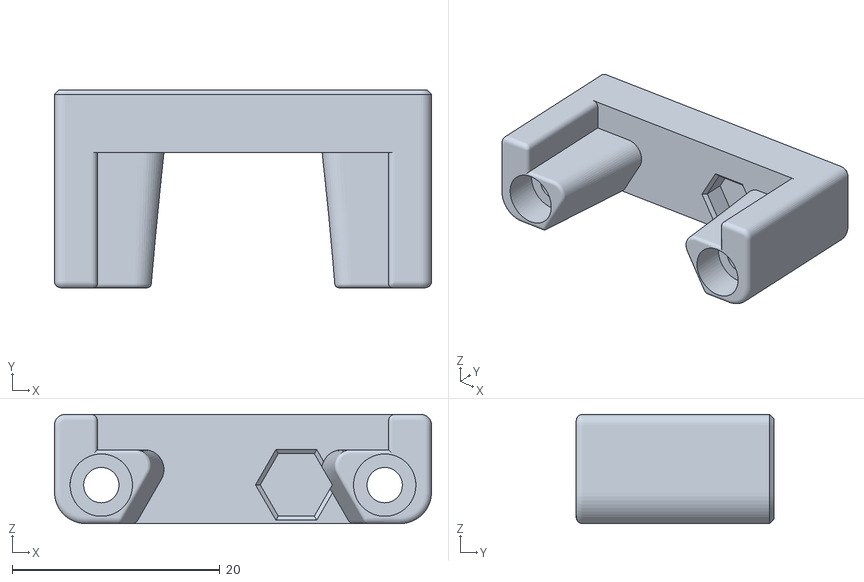
[picture p143: CAD file, 2022-07-12]
pcb_klicky/STLs/dock-front_insert.stl
36.3 x 19.0 x 10.5
