tanaes/whopping_Voron_mods/umbilical_passthrough/STLs/Hex Accent.stl

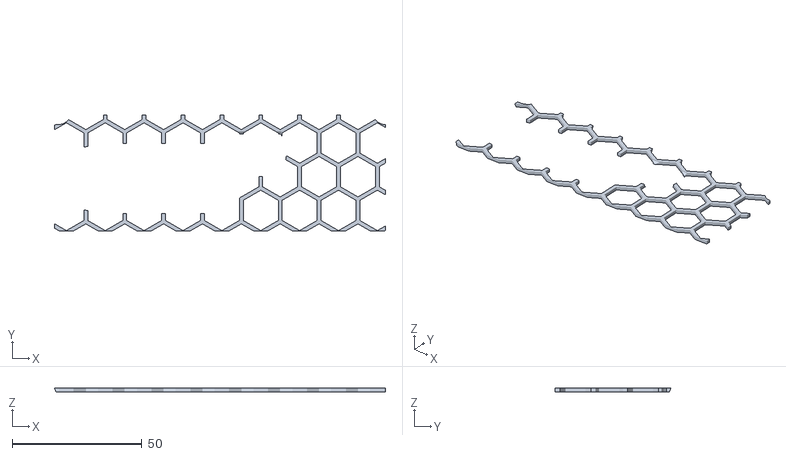
[picture p144: CAD file, 2023-10-16]
umbilical_passthrough/STLs/Hex Accent.stl
127.7 x 44.6 x 1.40
