tanaes/whopping_Voron_mods/badge/dfh_badge/halftone.dxf

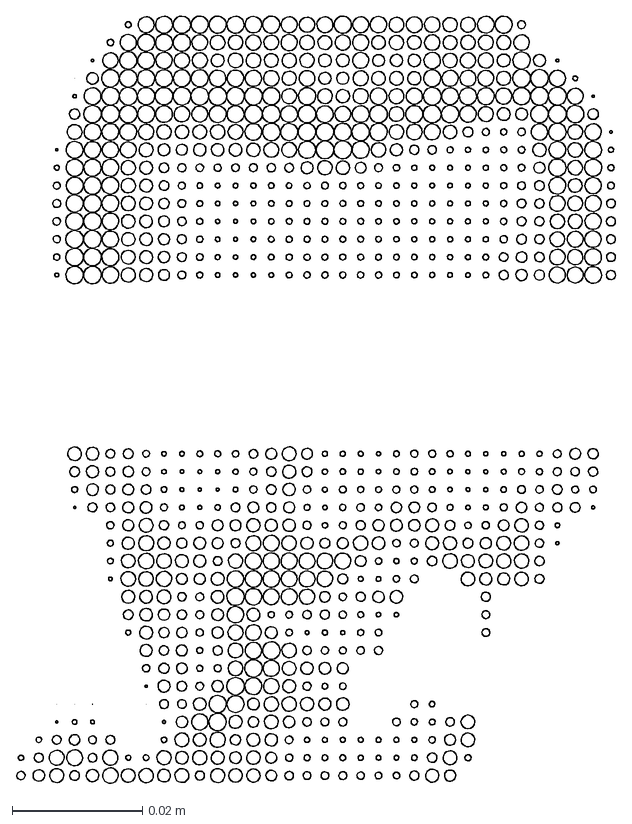
[picture p145: CAD file, 2023-05-02]
badge/dfh_badge/halftone.dxf
0.092 x 0.118 m
