tanaes/whopping_Voron_mods/clickyclacky_door/STLs/Handle.stl

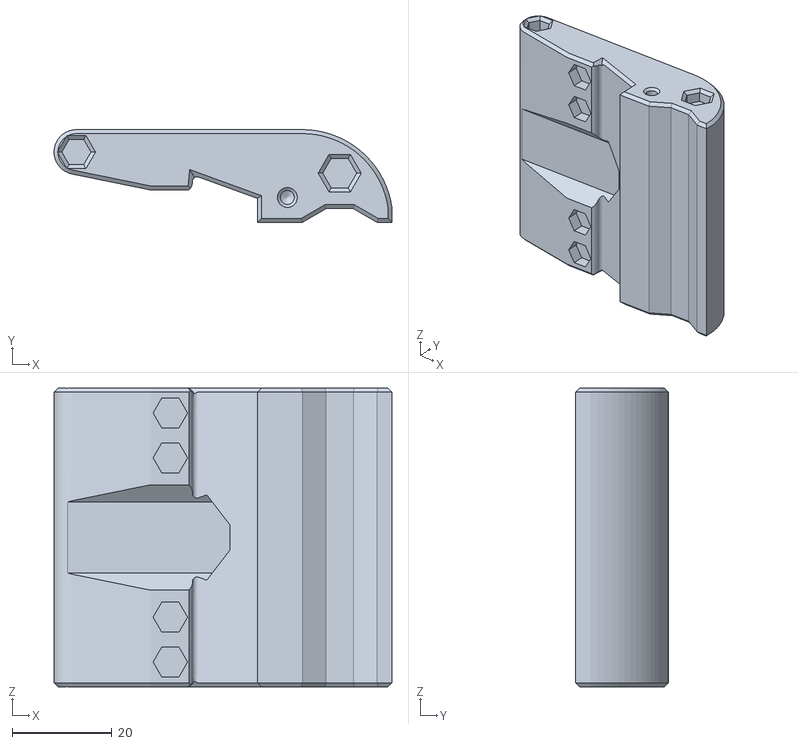
[picture p146: CAD file, 2023-08-04]
clickyclacky_door/STLs/Handle.stl
67.9 x 18.6 x 60.0
