tanaes/whopping_Voron_mods/extrusion_backers/DXFs/Y_backer_chain-300.dxf

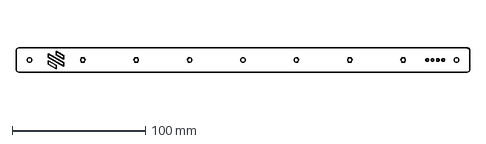
[picture p147: CAD file, 2023-05-09]
extrusion_backers/DXFs/Y_backer_chain-300.dxf
340.0 x 18.0 mm
