tanaes/whopping_Voron_mods/kinematic_bed/DXFs/Trident/trident_B-right_bearing_plate.dxf

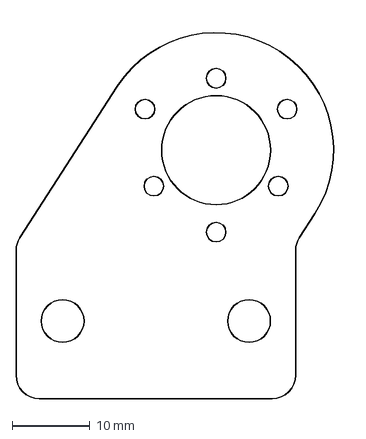
[picture p148: CAD file, 2022-04-28]
kinematic_bed/DXFs/Trident/trident_B-right_bearing_plate.dxf
43.0 x 49.2 mm
