tanaes/whopping_Voron_mods/kinematic_bed/DXFs/v24/E-back_top.dxf

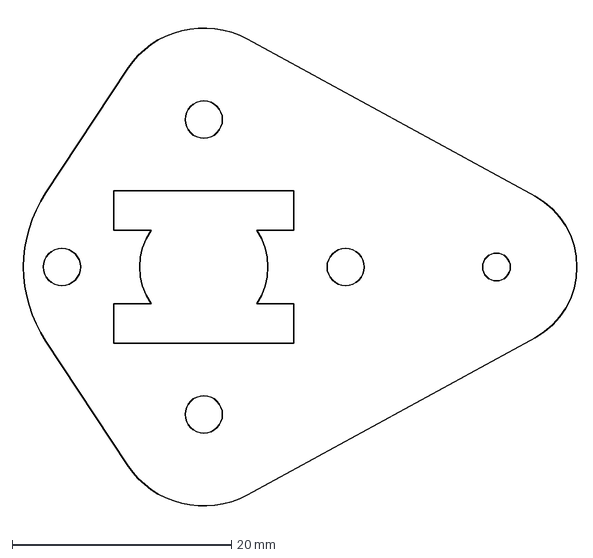
[picture p149: CAD file, 2022-02-04]
kinematic_bed/DXFs/v24/E-back_top.dxf
51.1 x 45.7 mm
