tanaes/whopping_Voron_mods/umbilical_passthrough/STLs/UmbilicalBlankingBackPlate-L-4mm.stl

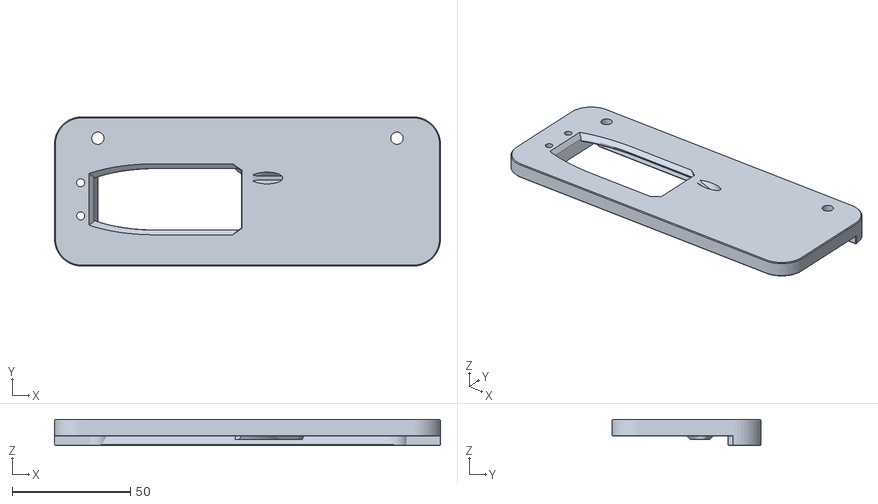
[picture p150: CAD file, 2023-10-16]
umbilical_passthrough/STLs/UmbilicalBlankingBackPlate-L-4mm.stl
163.0 x 63.0 x 11.0
