tanaes/whopping_Voron_mods/badge/dfh_badge/soldermask.dxf

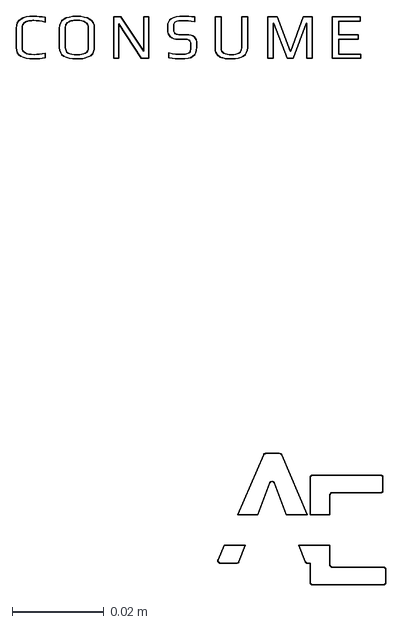
[picture p151: CAD file, 2023-05-02]
badge/dfh_badge/soldermask.dxf
0.0807 x 0.124 m
