tanaes/whopping_Voron_mods/clickyclacky_door/STLs/Hinge-L-solid-2X.stl

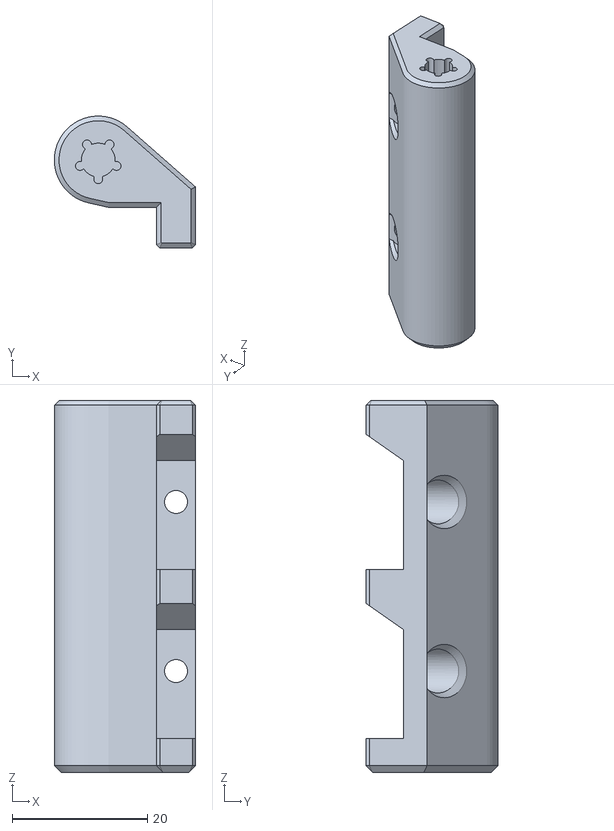
[picture p152: CAD file, 2023-08-04]
clickyclacky_door/STLs/Hinge-L-solid-2X.stl
20.9 x 19.5 x 55.0
