tanaes/whopping_Voron_mods/kinematic_bed/DXFs/Trident/Trident_kinematic_left-top.dxf

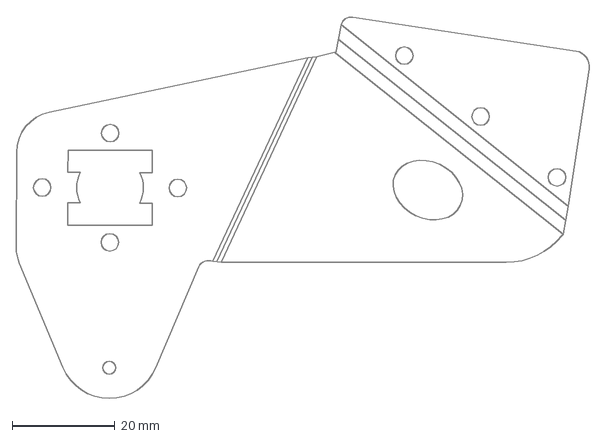
[picture p154: CAD file, 2022-04-28]
kinematic_bed/DXFs/Trident/Trident_kinematic_left-top.dxf
111.6 x 74.3 mm
