tanaes/whopping_Voron_mods/kinematic_bed/STLs/drill_guide_standard.stl

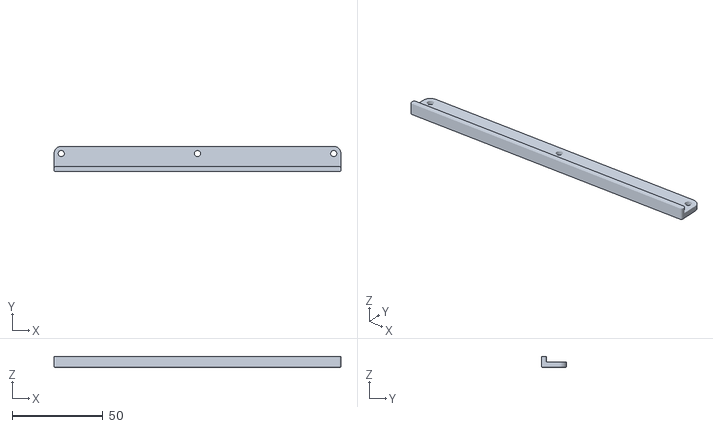
[picture p156: CAD file, 2022-02-15]
kinematic_bed/STLs/drill_guide_standard.stl
158.0 x 14.0 x 6.00
