tanaes/whopping_Voron_mods/umbilical_passthrough/STLs/M16_cable_gland_housing.stl

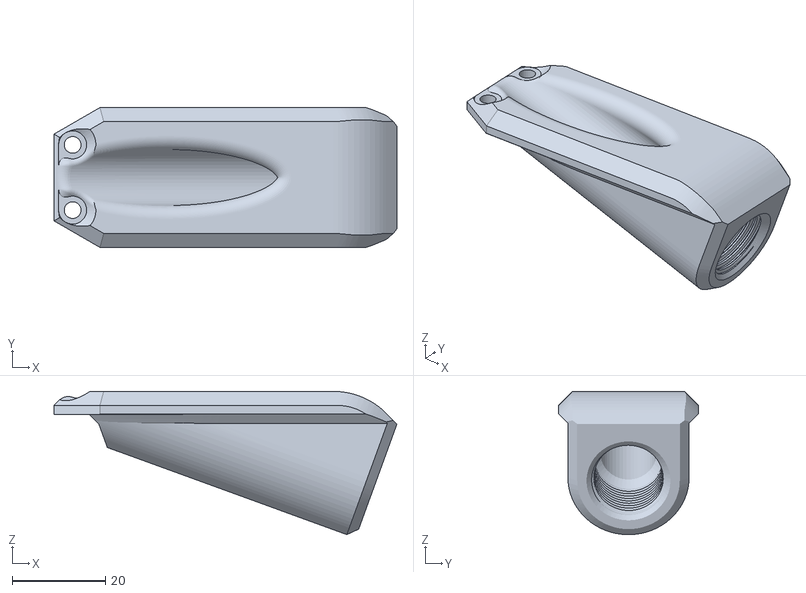
[picture p157: CAD file, 2023-10-16]
umbilical_passthrough/STLs/M16_cable_gland_housing.stl
73.6 x 30.0 x 30.7
