tanaes/whopping_Voron_mods/badge/dfh_badge/outline.dxf

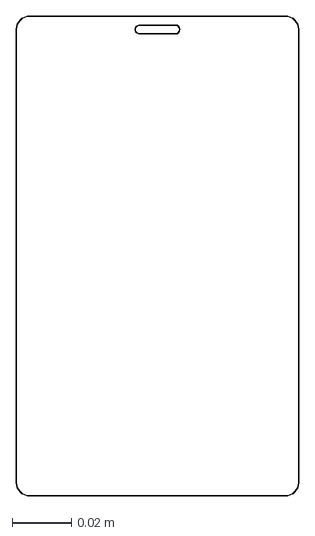
[picture p158: CAD file, 2023-05-02]
badge/dfh_badge/outline.dxf
0.0953 x 0.162 m
