tanaes/whopping_Voron_mods/clickyclacky_door/STLs/Handle-Hinge_Bottom.stl

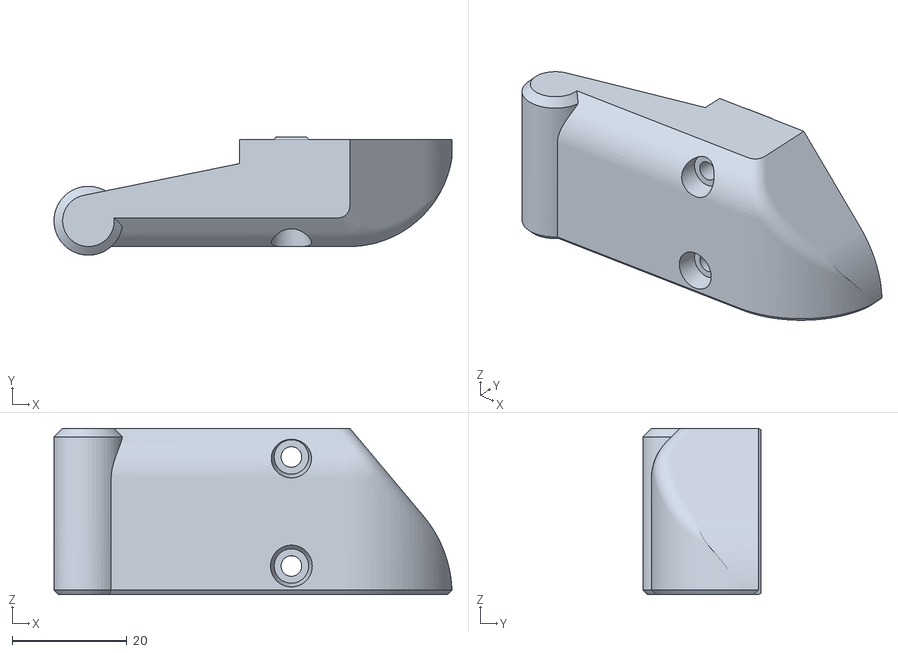
[picture p159: CAD file, 2023-08-04]
clickyclacky_door/STLs/Handle-Hinge_Bottom.stl
69.3 x 20.6 x 29.0
