tanaes/whopping_Voron_mods/extrusion_backers/DXFs/X_backer_chain-300.dxf

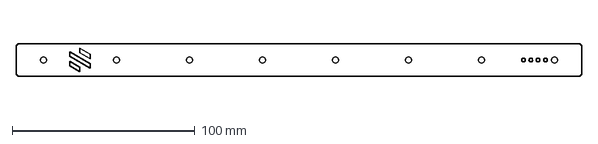
[picture p160: CAD file, 2023-05-09]
extrusion_backers/DXFs/X_backer_chain-300.dxf
310.0 x 18.0 mm
