tanaes/whopping_Voron_mods/kinematic_bed/DXFs/Trident/Trident_kinematic_left-base.dxf

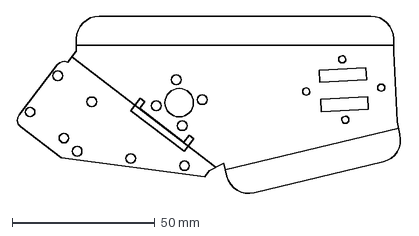
[picture p161: CAD file, 2022-04-28]
kinematic_bed/DXFs/Trident/Trident_kinematic_left-base.dxf
135.6 x 63.0 mm
