tanaes/whopping_Voron_mods/kinematic_bed/STLs/drill_guide_slots.stl

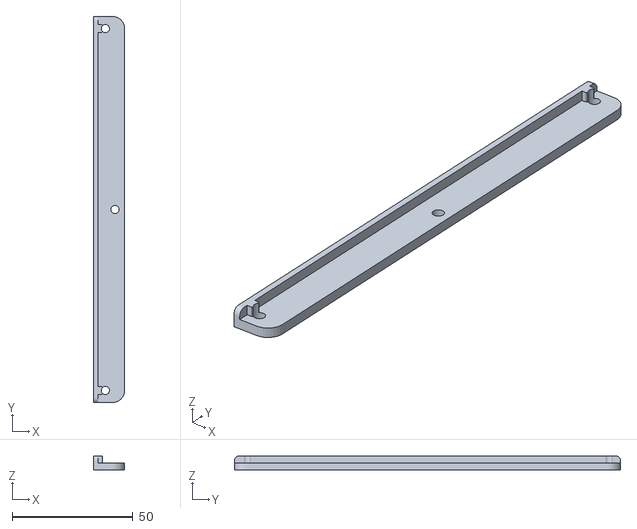
[picture p162: CAD file, 2022-01-22]
kinematic_bed/STLs/drill_guide_slots.stl
13.0 x 160.0 x 6.00
