tanaes/whopping_Voron_mods/umbilical_passthrough/STLs/Front_Plate.stl

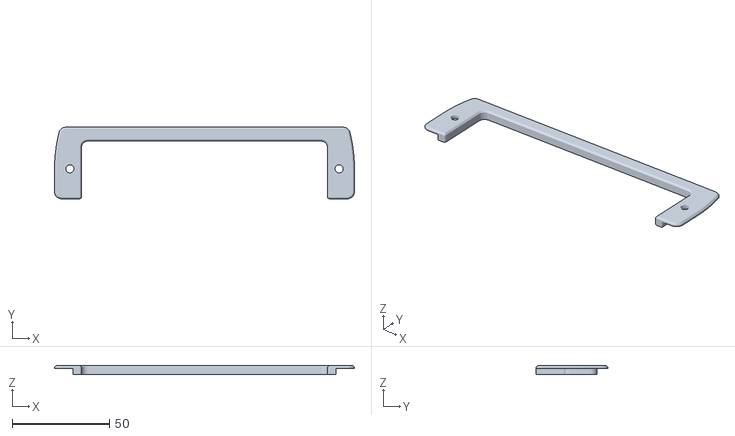
[picture p163: CAD file, 2023-10-16]
umbilical_passthrough/STLs/Front_Plate.stl
154.0 x 36.8 x 4.60
