tanaes/whopping_Voron_mods/kinematic_bed/STLs/install_helper.stl

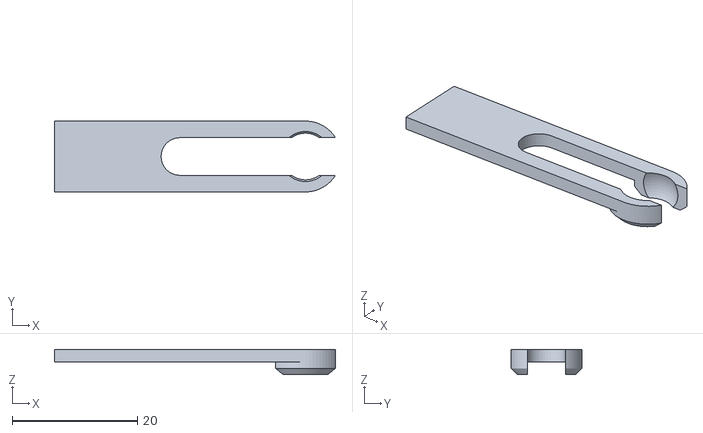
[picture p166: CAD file, 2022-01-21]
kinematic_bed/STLs/install_helper.stl
44.8 x 11.3 x 4.00
