tanaes/whopping_Voron_mods/umbilical_passthrough/STLs/UmbilicalBlankingBackPlate-L-6mm.stl

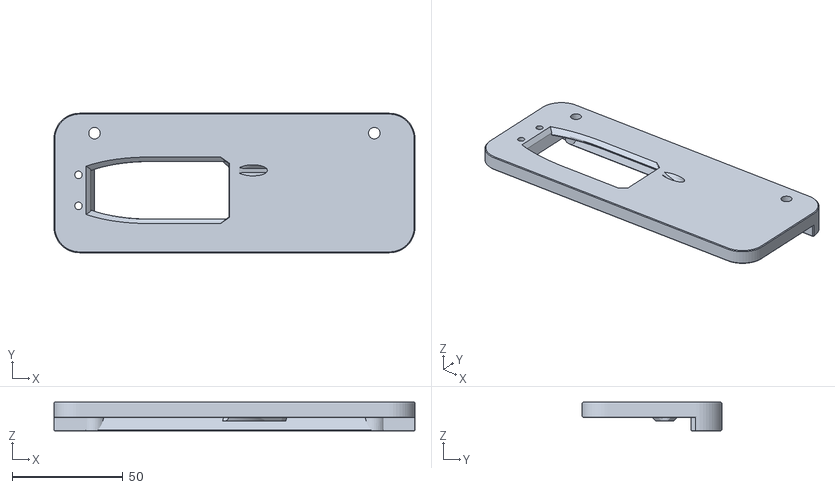
[picture p167: CAD file, 2023-10-16]
umbilical_passthrough/STLs/UmbilicalBlankingBackPlate-L-6mm.stl
163.0 x 63.0 x 13.0
