tanaes/whopping_Voron_mods/extrusion_backers/DXFs/X_backer_chain-250.dxf

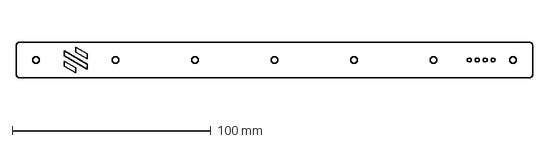
[picture p168: CAD file, 2023-05-09]
extrusion_backers/DXFs/X_backer_chain-250.dxf
260.0 x 18.0 mm
