tanaes/whopping_Voron_mods/kinematic_bed/STLs/6xWAGO.stl

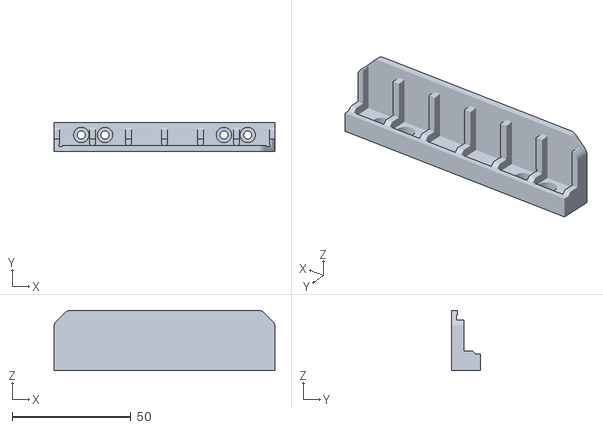
[picture p170: CAD file, 2022-01-21]
kinematic_bed/STLs/6xWAGO.stl
92.9 x 12.2 x 25.3
