tanaes/whopping_Voron_mods/umbilical_passthrough/STLs/PTFE_fit_test.stl

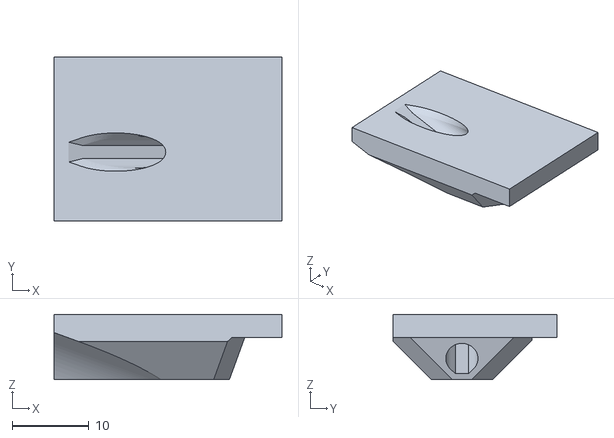
[picture p171: CAD file, 2023-10-16]
umbilical_passthrough/STLs/PTFE_fit_test.stl
29.8 x 21.4 x 8.55
