tanaes/whopping_Voron_mods/kinematic_bed/DXFs/Trident/trident_I-bearing_retain.dxf

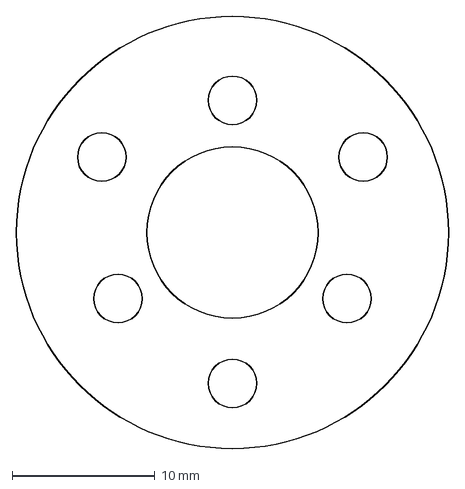
[picture p172: CAD file, 2022-04-28]
kinematic_bed/DXFs/Trident/trident_I-bearing_retain.dxf
30.2 x 30.2 mm
