tanaes/whopping_Voron_mods/kinematic_bed/DXFs/Trident/trident_G-back_bottom.dxf

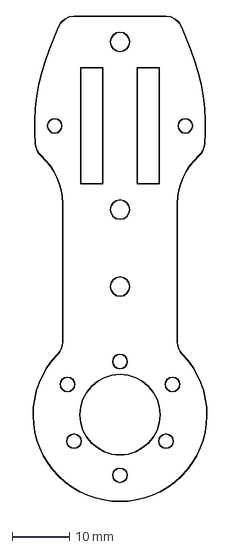
[picture p173: CAD file, 2022-04-28]
kinematic_bed/DXFs/Trident/trident_G-back_bottom.dxf
33.3 x 86.0 mm
