tanaes/whopping_Voron_mods/kinematic_bed/DXFs/Trident/trident_D-right_top.dxf

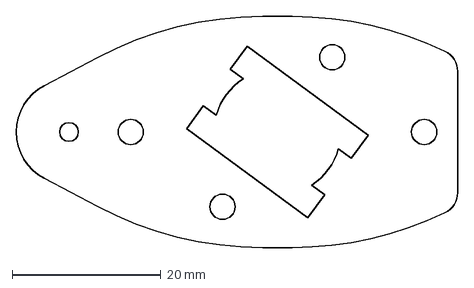
[picture p174: CAD file, 2022-04-28]
kinematic_bed/DXFs/Trident/trident_D-right_top.dxf
59.3 x 31.0 mm
