tanaes/whopping_Voron_mods/kinematic_bed/DXFs/Trident/J-spring.dxf

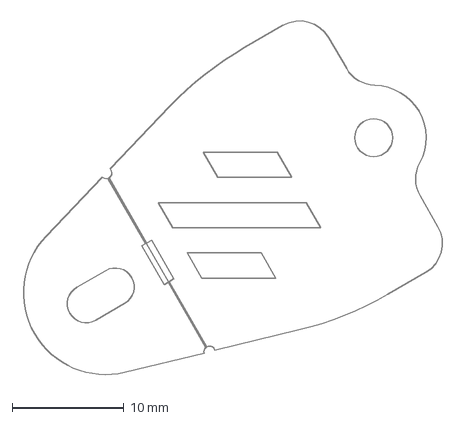
[picture p175: CAD file, 2022-02-04]
kinematic_bed/DXFs/Trident/J-spring.dxf
38.2 x 32.6 mm
