tanaes/whopping_Voron_mods/(list of files, cad)

Other CAD files:
kinematesque_bed/STLs/RFLB_mount-250.stl
pcb_klicky/STLs/probe-heatset.stl
Z_belt_cable_cover/STL/Z_belt_cover_cable-route_L.stl
extrusion_backers/STLs/XY_cable_chain_bridge-Igus-6.5mm_backer.stl
z_ball_joints/STLs/compact_lower.stl
kinematesque_bed/STLs/RFLB_mount-300.stl
kinematic_bed/STLs/sandwich_spacers-front_left.stl
kinematesque_bed/STLs/RFLB_mount-350.stl
Z_belt_cable_cover/CAD/Z_belt_cable_route.f3d
badge/dfh_badge/screwholes.dxf
badge/voron_badge/voron_badge-back.stl
extrusion_backers/CAD/backer_sim.f3z
kinematic_bed/STLs/Micron/shortie_sexbolt_body.stl
kinematic_bed/STLs/centering_washer.stl
kinematic_bed/STLs/sexybolt_owo.stl
pcb_klicky/STLs/AB_mount-screw.stl
pcb_klicky/STLs/probe-screw.stl
side_skirts/CAD/Side Skirt A - plug panel 350.f3z
umbilical_passthrough/CAD/umbilical_passthrough_backing_plate.f3d
