tanaes/whopping_Voron_mods/extrusion_backers/images/results/v2.4_tilt.png

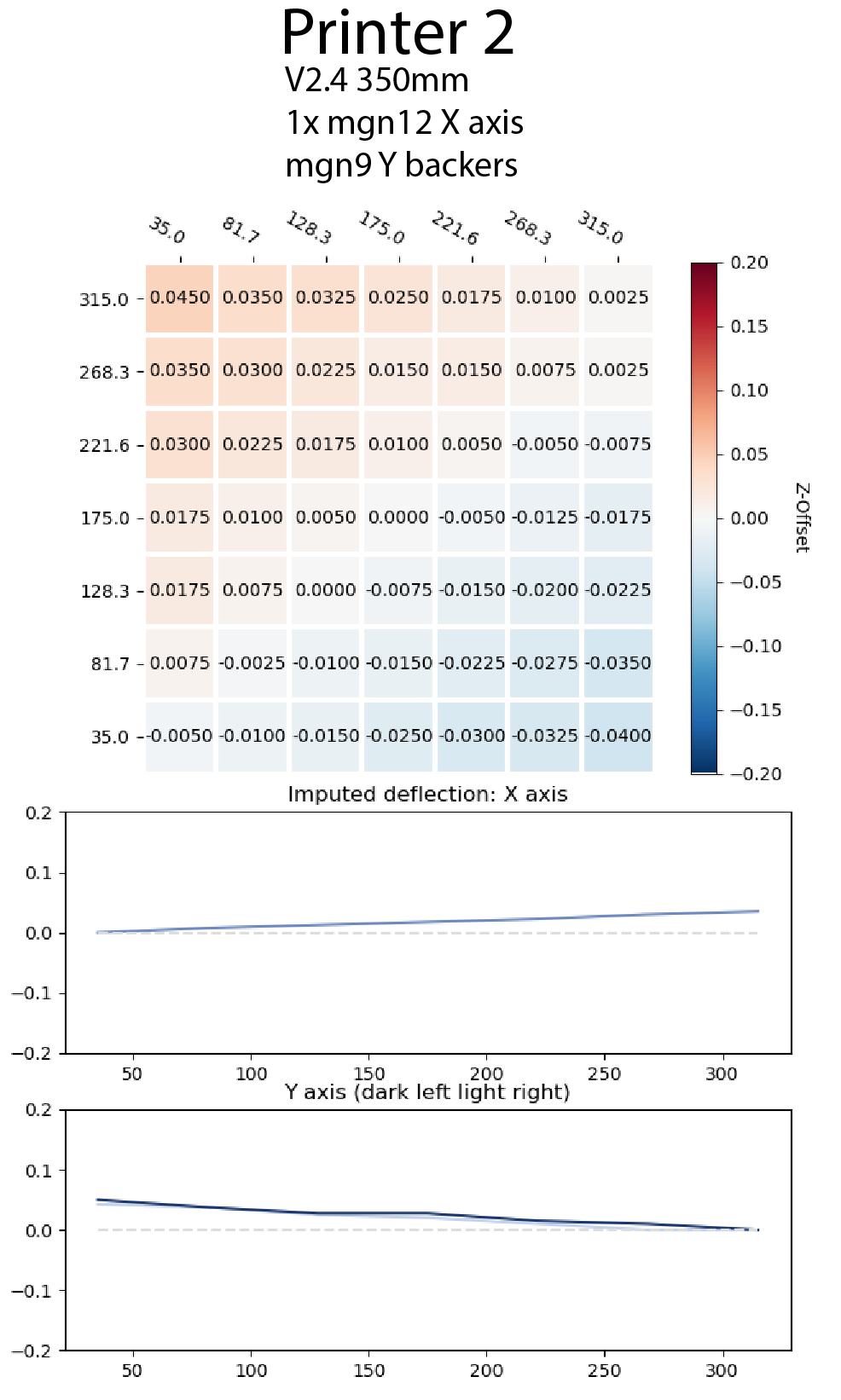
extrusion_backers/images/results/v2.4_tilt.png
