tanaes/whopping_Voron_mods/(threads)

Thread 2 (2022-02-05):

Material specifications needed

madhunm, 2022-02-05:
Hello,

I would like to make a set of these kinematic bed mounts by myself.

Can you please list the material specifications and the thickness of all the parts?

Thanks!

barecool, 2022-04-05:
[See v24_kinematic_BOM.md](https://github.com/tanaes/whopping_Voron_mods/blob/main/kinematic_bed/v24_kinematic_BOM.md)

MoellerLab, 2022-04-06:
thanks @barecool !

tanaes, 2022-04-06:
thanks @barecool !

Closed 2022-04-06.

Thread 7 (2022-03-15):

Wago Mounts

Bwachtel, 2022-03-15:
There is an included 6 Wago mount, is it possible to get a 7 or 8 mount? I have 2 power leads, 4 temp probe leads, and 1 ground lead. but im sure others (who dont have 2 bed probes) would get benefit out of it by having a quick disconnect for their nevermores?

I was also confused why the recommendation was to have the wagos mounted on the interior side? It made sense to me to have it on the exterior side for easy access to connect and disconnect the bed for removal.

tanaes, 2022-04-06:
I won't have time to do this for a bit (and sorry for noticing this so late), but if you ended up doing it feel free to submit a pull request and i"ll include it!

Thread 12 (2022-04-21):

Top or side mount?

rlaferla, 2022-04-21:
I am wondering if it is better to mount the backers on the side of the extrusions rather than the top?  Any empirical evidence as to why one way would be better than the other?  Is the expansion happening in one direction?  From the thermal images, it looked like it was bending vertically so wouldn't side mounting resist this more??

Thread 14 (2022-05-21):

Link to drill guide in Voron 2 manual is broken

Flapstaart, 2022-05-21:
The link in the Voron 2 guide to the drill guide STL is broken: https://github.com/tanaes/whopping_Voron_mods/blob/main/kinematic_bed/README_v2_assembly.md linking to https://github.com/tanaes/whopping_Voron_mods/blob/main/kinematic_bed/STLs/drill_guide.stl

What would be the correct guide?

Thread 22 (2023-02-15):

tightening the linear rails at working temperature

dderg, 2023-02-15:
what if you assemble the printer at 40 degrees? then it will flex when cooling down, but when heat soaked it should stay straight, can you please make a simulation on that? :)

Thread 24 (2023-03-20):

PCP Klicky

av8er, 2023-03-20:
With switch button closest to the nozzle you are unable to probe the body with Auto-Z as the button will hit the heatbed.
I think that dissimilar polarities on the side with two magnets will work better in docking

sf-pfm265, 2023-04-10:
I've encountered the same issue on my Trident. My first thought was that I could push my z endstop father way from the print bed to make some free space for the switch plunger -- but there's just not enough room.  I'm now thinking of engaging the z-endstop with the plastic part that surrounds the switch rather than the switch body itself. There's enough plastic surface to the side of the switch to engage. But it would mean that the probe point would not be inline with the plunger nor the nozzle.  I would also need to adjust the switch offset in autoz through trial and error until its correct, because the surface 0f the plastic is not perfectly co-planer with the switch body (in my case ~0.2mm different).  I'm not sure if this approach would create any downstream issues,  I'd be interesting in thoughts on this.

Thread 25 (2023-03-22):

Reverse switch position on PCB Klicky for auto z calibration

sim4dim, 2023-03-22:
It would make more sense to reverse position on PCB Klicky switch in order to be able to hit Z end-stop with the body of the switch.
The way it is   configured now, klicky hits the bed before it engages the end-stop switch.

sim4dim, 2023-03-24:
Tested with reverse mounted switch -
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
Works as intended for auto Z calibration

Closed 2023-03-24.

Thread 30 (2023-08-15):

Lightweight Labware V2  kinematic mounts interfere with Nevermore V6

JAMMnGA, 2023-08-15:
I have recently built a V2.4 R2 using these kinematic bed mounts and have since attempted to install a Nevermore V6 filtration unit. However, the front mounts hang over the extrusions enough to prevent the Nevermore unit from sliding in between the parallel extrusions.  Has anyone else had this issue? A simple fix appears to use small (2mm or so) shims between the extrusions and the kinematic mounts.

Thread 31 (2023-08-27):

Please add step file for pcb klicky

chgi, 2023-08-27:
Hello, can you please add a step file for the klicky pcb and the mounting parts?
I (and probably many others) can not use Fusion 360, because I don't have Windows.

arielja87, 2023-10-20:
+1 on this here issue

drumstick77, 2024-02-07:
hiya, if you can please share the step files for 360 that'd be much appreciated, ta

rnbarrett, 2024-03-02:
If it helps, Fusion 360 also runs on Macs, and there is a free license.  You can load up Fusion 360 with the free license, open the F3D file, then export as STEP and use the tool of your choice.

Thread 33 (2023-10-20):

LED Always ON

hreality, 2023-10-20:
Verified my logic and the probe is functioning... Voron 2.4 r1 Octopus 1.1 never needed a diode and ran klicky standard without issue.  Thing is, the LED is always on dims briefly while probing..

[probe]
##  Inductive Probe - DIAG7 Replaced with Klicky PCB
##  This probe is not used for Z height, only Quad Gantry Leveling
pin: ~PB7
x_offset: 0
y_offset: 19.75
z_offset: 6.42
speed: 4
samples: 3
samples_result: median
sample_retract_dist: 3.0
samples_tolerance: 0.3
samples_tolerance_retries: 4

karlfife, 2023-12-23:
Same issue.  LED is on even when probe is NOT attached.
Not sure how the circuit is built, but tried configuring signal to pull up, and pull down.  Same result

tanaes, 2023-12-23:
I recently got a batch of PCBs from JLCPCB in which half the boards were assembled with the wrong LED part number, causing the same behavior. I wouldn't be surprised if other vendors received boards with the same problem.

karlfife, 2023-12-23:
I must misunderstand something about the theory of operation of the PCB Klicky.  Since the magnetic probe itself has both NO and NC contacts, I assumed the only electrical path to illuminate the status LED was via Normally Closed contact on the probe.   i.e. No probe, no path to ground for the LED. When the probe is attached, current flows via the NC terminal through the diagnostic LED to ground, causing the LED to illuminate.
When the attached probe is triggered, the NC circuit opens, interrupting connection to the LED, instead pulling down 'signal' to ground.
I must have this wrong, otherwise, even the wrong type of LED could not stay lit.  What is the design if not as above?   Maybe the circuit is totally different, with an LED zener diode with the wrong breakdown voltage, and that's what causing it to remain lit?  Care to shed light?

tanaes, 2023-12-23:
Ahh sorry i thought you were talking about OptoTap! Please ignore my
comment then. 😅

On December 23, 2023, Github Notifications ***@***.***>
wrote:
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

—
Reply to this email directly, view it on GitHub
<https://github.com/tanaes/whopping_Voron_mods/issues/33#issuecomment-
1868362939>, or unsubscribe
<https://github.com/notifications/unsubscribe-
auth/AB7ISAGC4XDGY6TMUP3FU4TYK43KBAVCNFSM6AAAAAA6IARXWWVHI2DSMVQWIX3LMV43OSLTON2WKQ3PNVWWK3TUHMYTQNRYGM3DEOJTHE>.
You are receiving this because you commented.Message ID:
***@***.***>

Rudis1261, 2025-04-07:
I also had this issue, I double checked my board (Octopus) pinout and I had the Signal and GND pins flipped. After flipping them works beautiful 👌

Thread 35 (2023-12-04):

add step files of the Gantry Backing Plates (extrusion_backers)

toscdesign, 2023-12-04:
Can you please add the step files corresponding to the dxf files?
There are people (including me) who use other CAD programs than Fusion360.

With these step files it would also be possible to produce the parts on a friend's CNC milling machine.

Thread 37 (2023-12-13):

Issues attaching and docking PCB klicky

dragoonmc, 2023-12-13:
on my SW with the servo to locate the probe I was having issues getting it aligned just perfectly so that the magnets would slide.
Wondering if you had considered making a filler piece to go between the magnets on the probe to help with this?

Thread 38 (2024-01-02):

Clickyclaacky Door links outdated

cin3m, 2024-01-02:
Hello @tanaes,

I'm currently planning to build the alternative door of yours. Sadly the affiliate link from AliExpress of the split bushings isn't available anymore. Can you provide another one?

Kind Regards.

Fragmon, 2024-02-09:
up

TheFuzzyGiggler, 2024-02-23:
They're 5mmx7mmx8mm split bushings.

Here's an Amazon link for 10 of them.
[](
https://www.amazon.com/Bettomshin-Oilless-Bearing-Bushings-Printing/dp/B08YNPYZCT)

Thread 39 (2024-01-14):

Voron V0.1/2

hEVIq, 2024-01-14:
Hey!
Is there any option  (design/STL) here to mount Klicky PCB on Voron V0.1?

mayder, 2024-06-20:
I need it too

Closed 2024-01-20.

Thread 40 (2024-03-01):

Clicky Clacky Latch pivots within the extrusion as your tighten it down

rnbarrett, 2024-03-01:
This pivoting pulls the leading edge of the latch away from the frame, causing it to interfere with proper handle movement.

Could you consider adding a "spacer" to fill the gap between the roll-in nut and the bottom of the latch?  I think it will stop the pivoting without having to do something like make the latch project deeper (or wider) into the extrusion, which would likely mean you'd need different latches for dealing with the known variances between manufacturers.

Something like this (from the A/B drive mounts on a Voron 2.4R2) is what I'm talking about.
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

Or are we really supposed to be using hammerheads?  :)

rnbarrett, 2024-03-01:
Perhaps something like this (the red areas) - leaving the M3 holes of course.
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

rnbarrett, 2024-03-01:
Video that I think shows what I'm talking about with the pivot
https://github.com/tanaes/whopping_Voron_mods/assets/31315019/c1fa6dd1-d0e1-4a6b-93b4-990f4beb145e

tanaes, 2024-03-04:
This is a real challenge for me. I actually had a projection very much like that in initial testing. The problem I encountered was that it limited the force with which the hinges could clamp onto the extrusion -- with hammerhead nuts that had a larger projection there, you could tighten it right down and the hinges would slowly slide under the door weight over time.

All of this boils down to needing to accommodate panels that extend to the very edge of the extrusion slot, so there's no room for balanced engagement across both sides of the extrusion.

I'm open to ideas!

Thread 42 (2024-04-22):

Hinges

Macmagoo, 2024-04-22:
I have a LDO Trident 300 cubed. I bought the extrusions for the Clicky Clack door mod but when I attach the door to the hinges it is half an inch or so away from the frame at the latch side. Any advice appreciated. Thank you.

miklas206, 2024-07-25:
I have the same i dont know if its just how it is or if its a problem plzz let us know :)

southproduct, 2025-06-14:
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

Hi, I'm not the developer, but I will try to help.

Make sure the hinge system is as depicted. If so, the gap should be minimal (1-4 mm or 0.0393701" - 0.15748") Jesus Christ! I can't stand imperial measurements.

1/2 an inch anywhere sounds unrealistic. Try to attack pictures of the issue (with the door attached / un-attached) make sure to take pictures of all the parts as well. It's also helpful to have a ruler or a cutting mat with a printed ruler on the background for reference. That way anyone can see if the printed parts are way off measurement.

Hope this helps.

DocFoFo, 2025-06-15:
I'm with SouthProduct on this one. Sounds like you have the hinges mixed up. Everything worked out well for me. There is supposed to be a gap, but it's for the seal. The frame should not be up against the printer. There is foam that goes between the door printer.

Thread 43 (2024-05-10):

[clicky clack door] add slop to where the pins go

Nathan22211, 2024-05-10:
I've been printing my parts in PETG rather than ABS like I've done most of my external parts but I've noticed that the holes for the pins on the handle are rather tight, I have to hammer them in. They also like to go in at an angle which often results in me splitting the part. adding a slop cutout to the parts would help alleviate this

Thread 44 (2024-06-04):

ClickyClacky doesn't fit when I put on my side panel

laserbeak, 2024-06-04:
I installed the ClickyClacky door mod today and it works, until I put on the side panel, then the acrylic keeps the latch from engaging, as it's flush with it. Has anyone ever had this problem? Piece popped out trying to put it in also...
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

laserbeak, 2024-06-04:
Dremeled the middle tooth off and replaced it with a T-Nut + M3x12 and I'm back in business.

Closed 2024-06-04.

Thread 45 (2024-06-28):

CAD doesnt work if foam_gap changes

melsawy93, 2024-06-28:
Hi, wondering if this is a quick fix. I noticed the cad is parameterized but when I try to accomodate a bigger gam between the door and extrusiosn (foam_gap), 2 operations fail. Anyone able to fix this?

Thread 46 (2024-08-01):

Clicky Clacky There is a narrow gap when the door is closed.

skyaee, 2024-08-01:
Hello. No matter how I install and adjust it, the door cannot be completely sealed when closed. There is still a narrow gap. This troubles me. Is there any solution?

martinewald, 2024-12-30:
Stupid question, did you add the foam tape on the inside of the door?

southproduct, 2025-06-14:
I'm not the designer. I couldn't import the .f3d source files, but I managed to import the provided .STL files and added it to my custom Voron.

In the real world, after applying the foam tape inside, I can see there's a ~1mm gap near the corner and a ~4mm gap near the latching system.

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

In my CAD app, I can see that if I place the door frame parallel to the frame of the printer there would be a 3mm gap.

---

I've requested the developer to include .STEP files, hopefully it includes the entire frame (+foam tape) that way we can see how the design is intended to work.

Regardless, if they don't... you can always add thicker and thicker tape until it works.

For example, in my case I had the wrong printer settings and the holes for the hinge system were wrong... I didn't reprint. I Macgyver'ed a solution with playdough and the latch works perfectly fine.

Hope this helps.

Cheers!

Thread 47 (2024-08-27):

Don't use a hammer on the sleeves

BlackNet, 2024-08-27:
Instead of a hammer, use a soldering iron and the M5 heat set tip!!! It works great and won't crack the housing!

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
tanaes, 2024-08-27:
Great idea!

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
morlan, 2025-01-23:
Perfect! Thank you!

Closed 2024-08-27.

Thread 48 (2024-10-22):

pcb_klicky/README.md links out of order

KittenRaee, 2024-10-22:
https://github.com/tanaes/whopping_Voron_mods/blob/62268ed817878e54d6a1186882060aa8368d4f0f/pcb_klicky/README.md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

Link for magnet app for android is, unfortunately, throwing out 404 error.

Thread 49 (2025-01-07):

clicky clack rubber affiliate aliexpress link doesn't work

Oasis1981, 2025-01-07:
HI

seems impossible to open that link.
it's always unavailable.
could you insert the name here?

thanks
regards

Paintrain-Ger, 2025-04-04:
Hi,

same issue here. Struggling to find a suitable sealing, since i'm only in need of this sealing.

Any Chance someone could help by some data sheet or link?

Thanks!

Thread 51 (2025-06-07):

Kinematic Mounts: bed movement during Tap probing

brownem, 2025-06-07:
I have a LDO rev D Voron 2.4 350 that has had your kinematic mod installed, with Tap probing, since day 1. Until now, I have had great first layer performance in the center of the bed, less-so at the edges. I finally realized that this was because I never adjusted my QGL and bed mesh bounding points to take up the full area of the bed (just the standard LDO configuration). But when I expand out my QGL and bed mesh to a square with corners at 10,10 and 340,340, I run into issues with being able to get QGL to run at all while hot (strangely, both QGL and bed mesh are fine while cold). I eventually noticed that the back corners of the bed are shifting ever so slightly during QGL, which explains all the strange and inconsistent failures I was getting: sometimes `!! Probe samples exceed samples_tolerance`, and sometimes I run out of re-tries for QGL.

I have a few hypothesis as to what is going on:

1. This kinematic mount simply cannot support Tap points so close to the edge of the bed, and I need to live with them pulled in closer to the center (35,35; 315,315 seems to work, but isn't much of an improvement over where the points originally were)
2. Something is wrong with my leaf springs. I bought the titanium version from KB-3D, as I didn't want to deal with the oxidation/oiling of spring steel. That said, it seems like it is easier to get these titanium springs to enter their plastic deformation zones than it would be with an equivalent version of spring steel.
3. The mounts still aren't in quite the correct positions; getting them lined up was a bit of a challenge, particularly in the back. But they do now sit on the dowel as best as I can tell with an inspection mirror. A little close to inner edges of the dowels when cold (but not touching anything other than the dowels), but that should be fine as they now have plenty of room to slide outwards during expansion.

So I guess my question is this: to test whether my kinematic bed is behaving as expected, what Tap points would you consider to be normal for a 350mm bed?

If I am already close to the maximum you'd expect, then I will probably try to play with getting a couple of pieces 150mm 2020 t-slot and mounting my bed using its Trident mounting holes and semi-following your trident mounting guide instead. That should give the bed a wider stance in the front help to stabilize it in the back corners, at the cost of some stability in the front (but not enough to matter, I think).

But if I should be able to probe closer to the edges of the bed (particularly in the back corners), where would you recommend I look for the issue?

Thread 52 (2025-06-14):

.STEP files please

southproduct, 2025-06-14:
Hi,

Sorry to bother, but if possible can you include .STEP files? .F3D files are proprietary, meanwhile .STEP files are more widely adopted. The provided .STL files are unmodified and the people from Plasticity 3D say that when I import that it's kinda like a 3D .JPG. It's "3D", but I can't modify it. Meanwhile, if you include .STEP files I'll be able to adjust accordingly without issues.

Thanks for taking it into consideration.
