tanaes/whopping_Voron_mods/universal_bed/Universal_build_plate Drawing v2.pdf

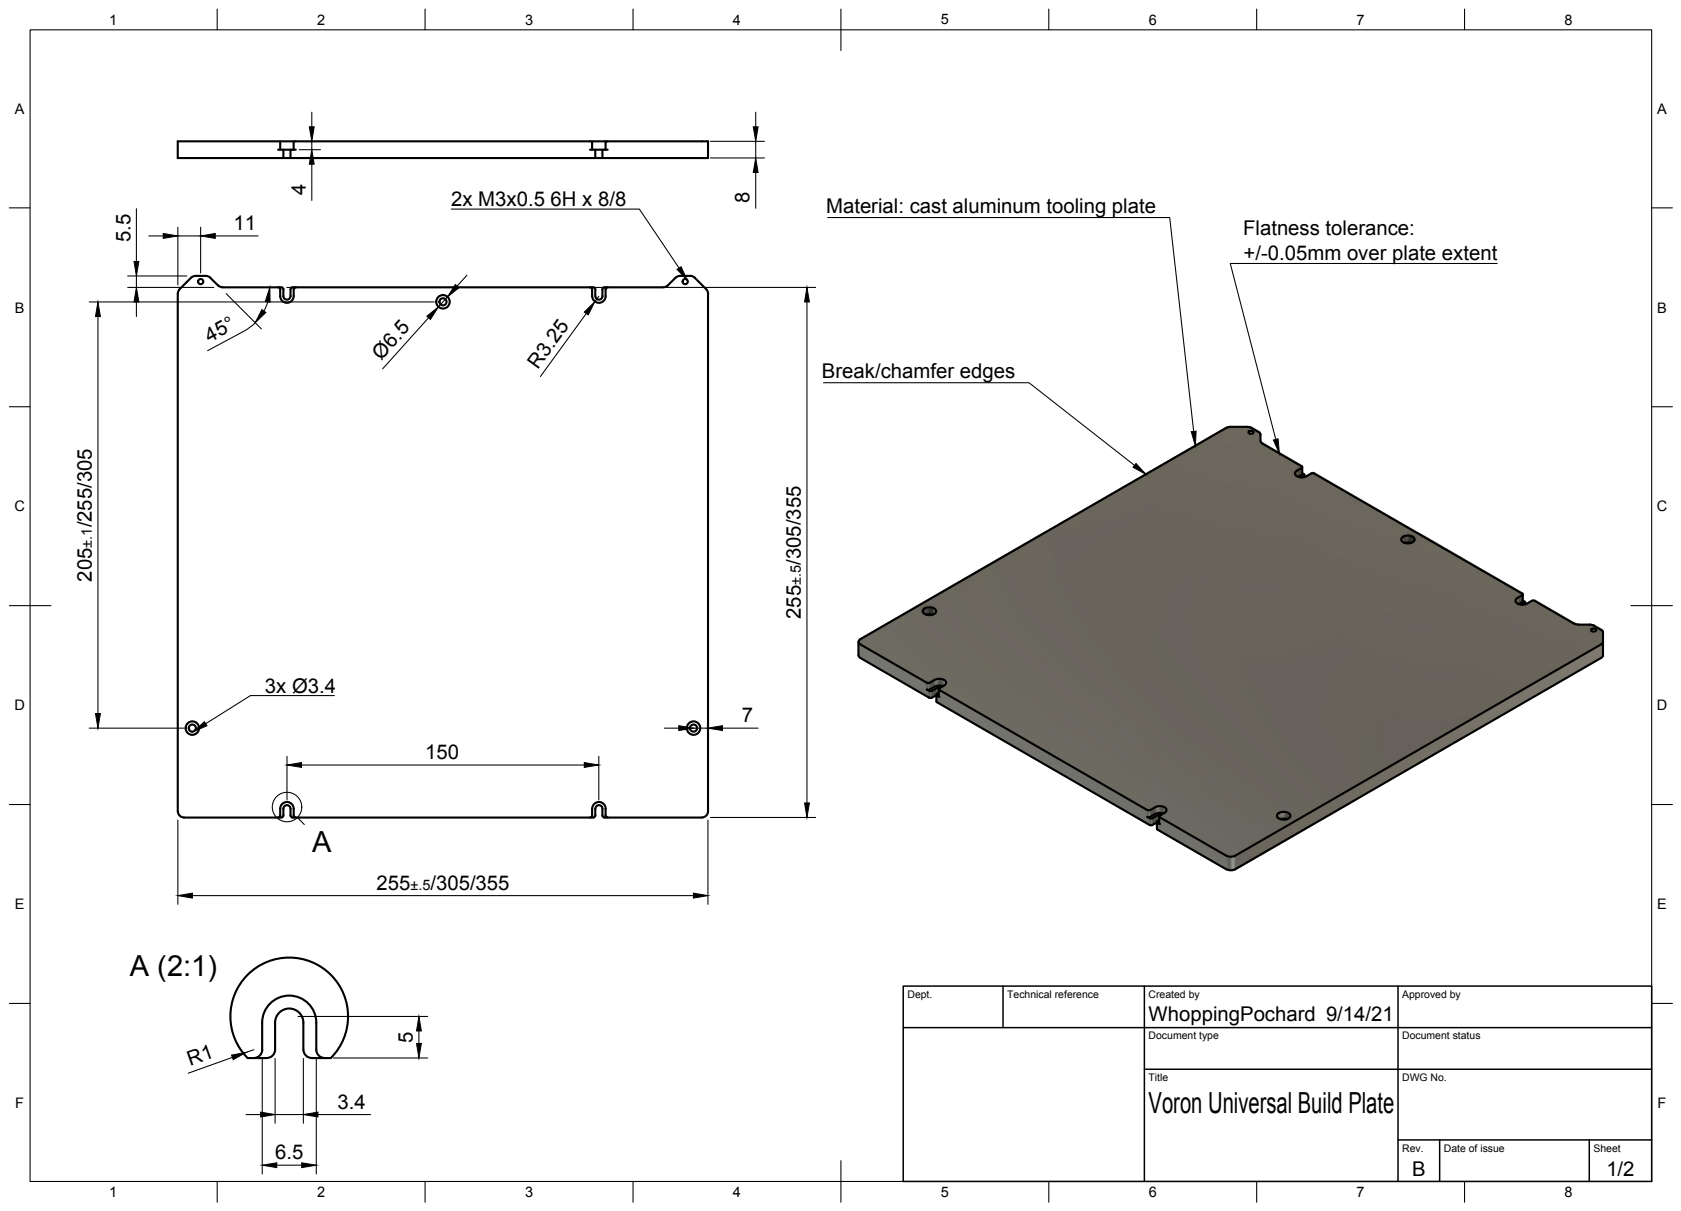
[picture p213: page 1]
Title; DWG No.; Rev.; Date of issue; Sheet; Material: cast aluminum tooling plate 5.5

Flatness tolerance:
+/-0.05mm over plate extent

Break/chamfer edges

Dept. | Technical reference | Created by WhoppingPochard 9/14/21 | Approved by

Document type | Document status

Voron Universal Build Plate

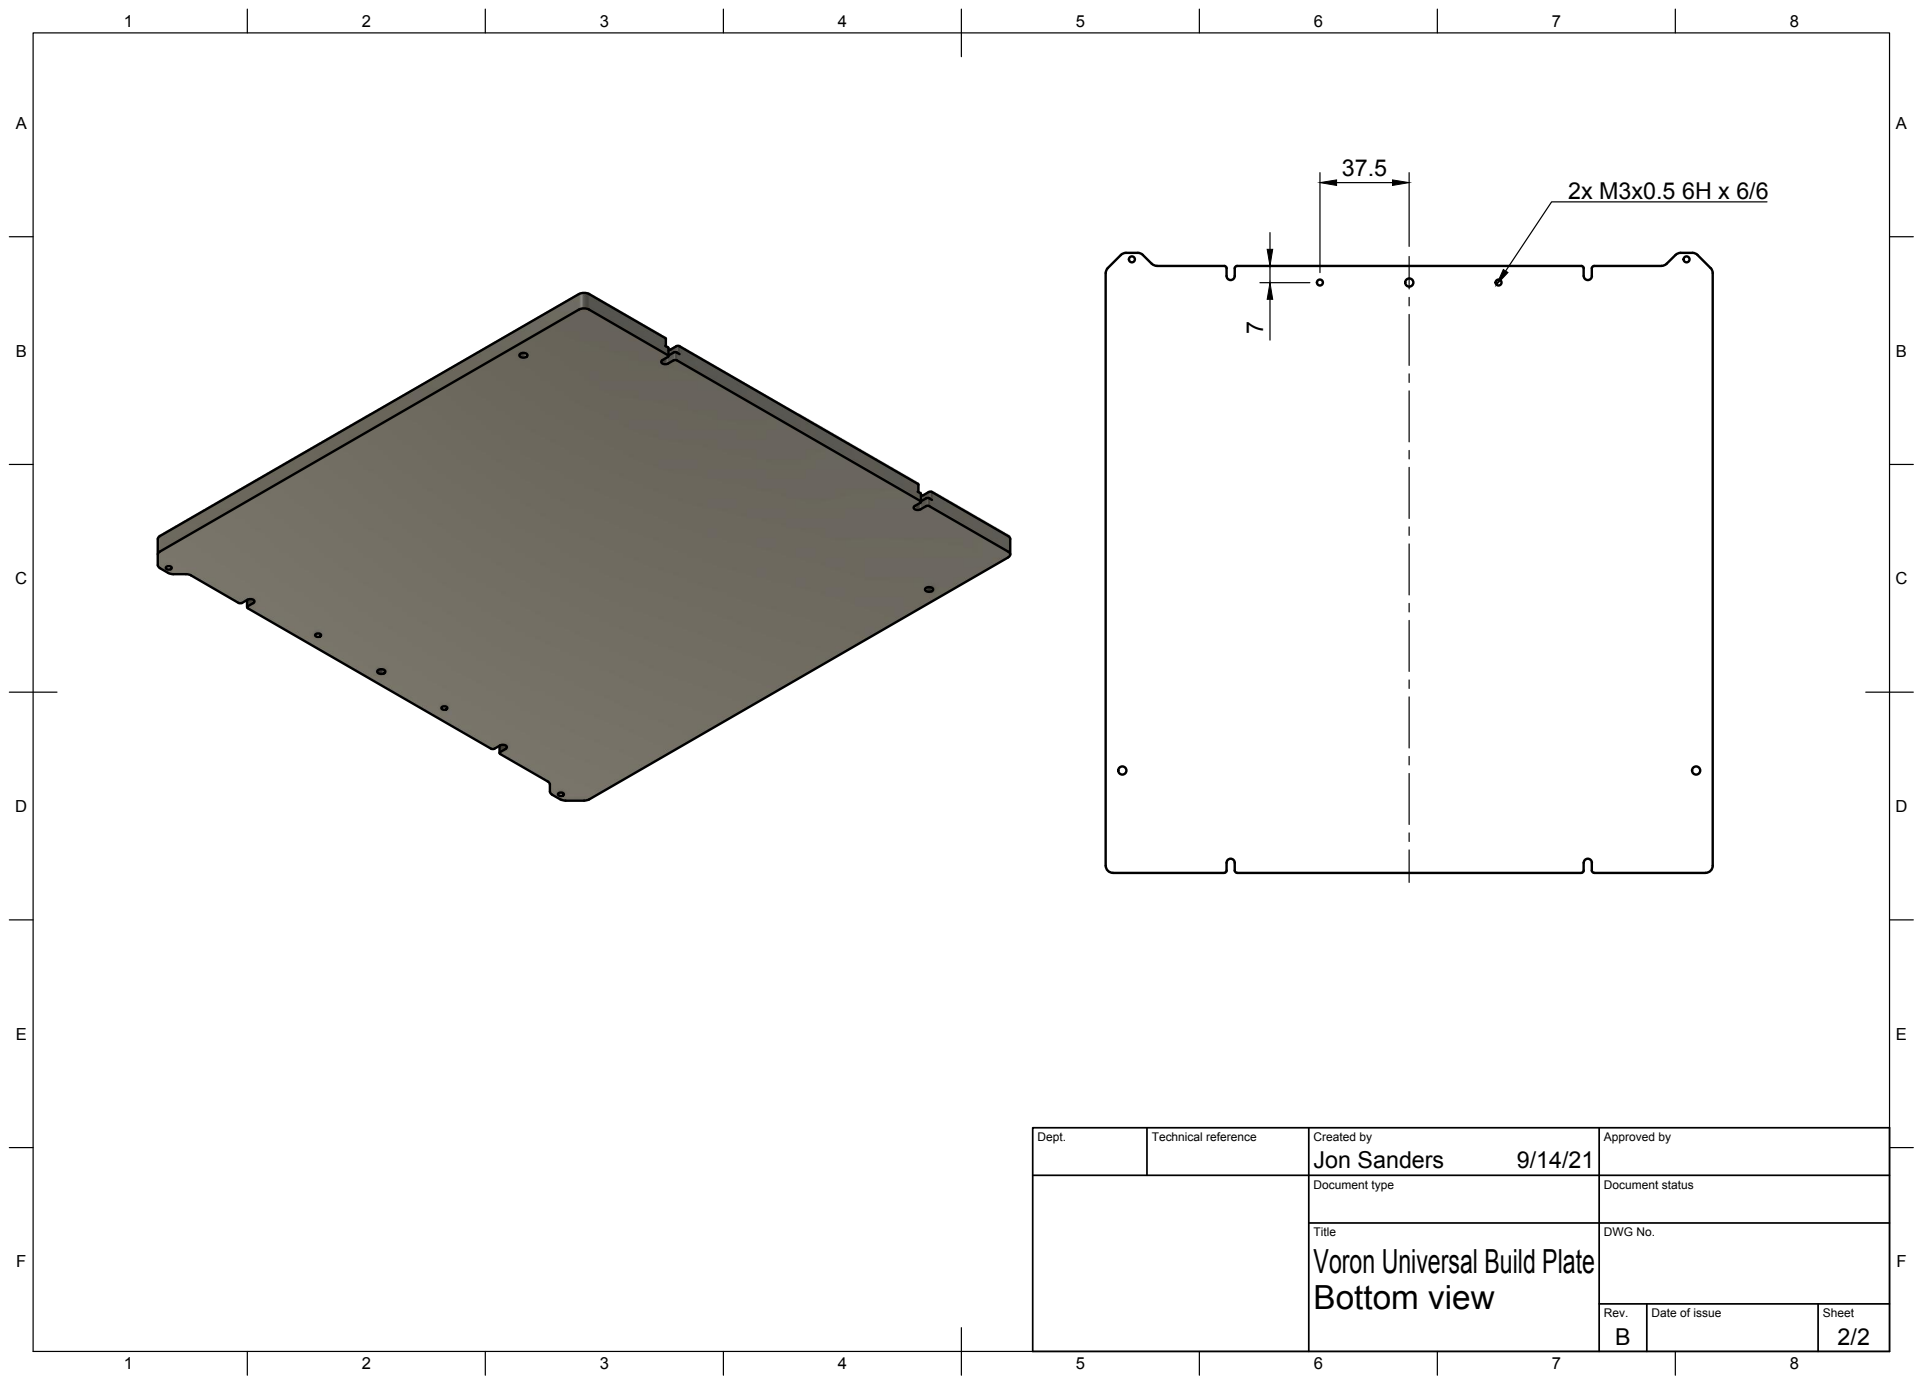
[picture p214: page 2]
Title; DWG No.; Rev.; Date of issue; Sheet

Dept. | Technical reference | Created by Jon Sanders 9/14/21 | Approved by

Document type | Document status

Voron Universal Build Plate
Bottom view
