tanaes/whopping_Voron_mods/kinematic_bed/DXFs/Trident/Trident_Assembly_Z Assembly-Kinematic Drawing v4.pdf

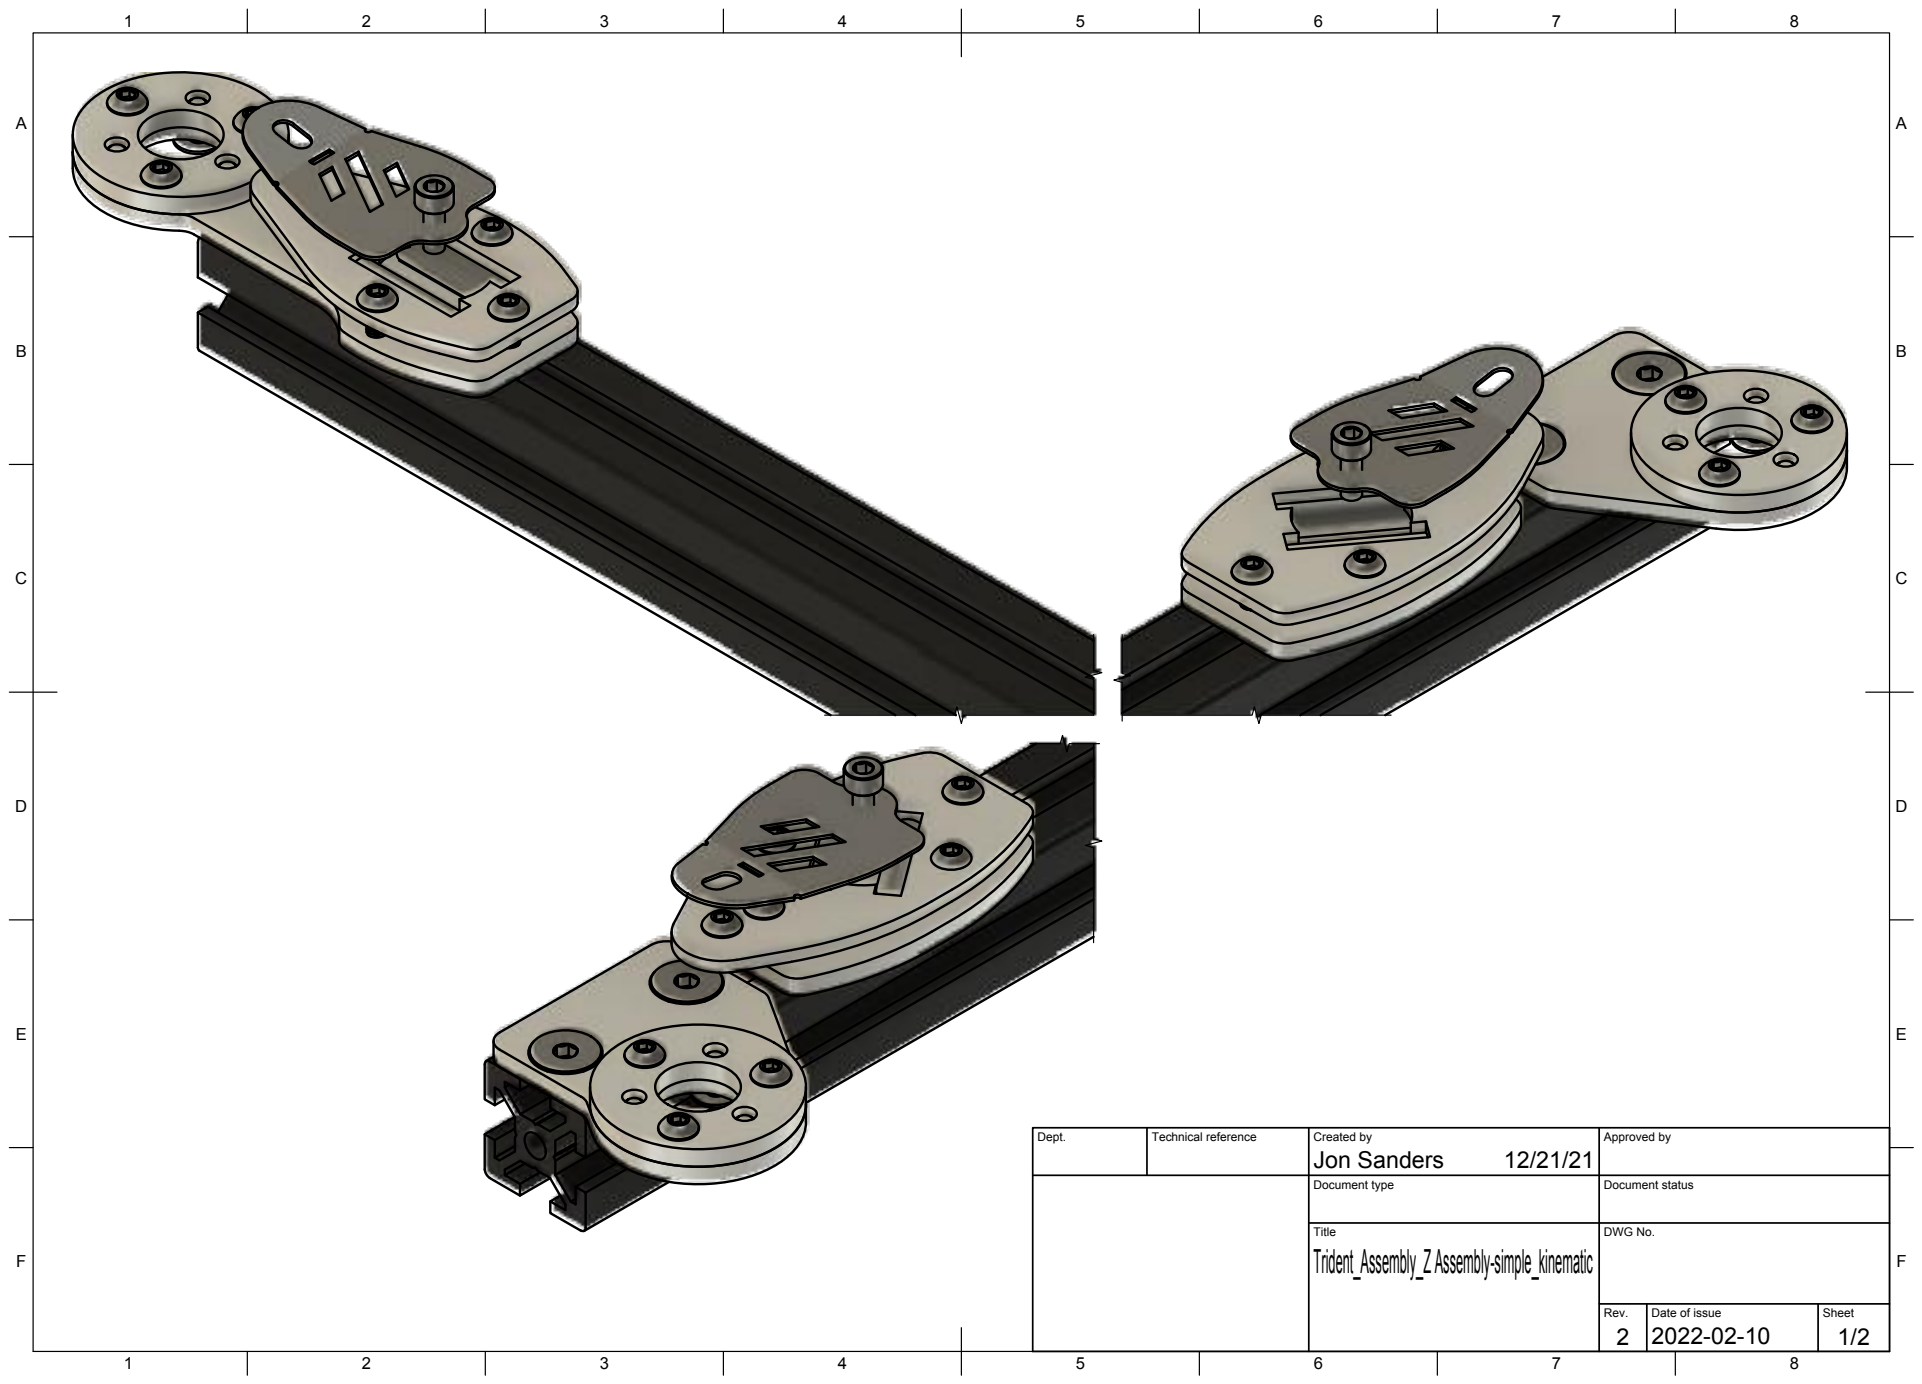
[picture p215: page 1]
Title; DWG No.; Rev.; Date of issue; Sheet; Trident_Assembly_Z Assembly-simple_kinematic

Dept. | Technical reference | Created by Jon Sanders 12/21/21 | Approved by

Document type | Document status

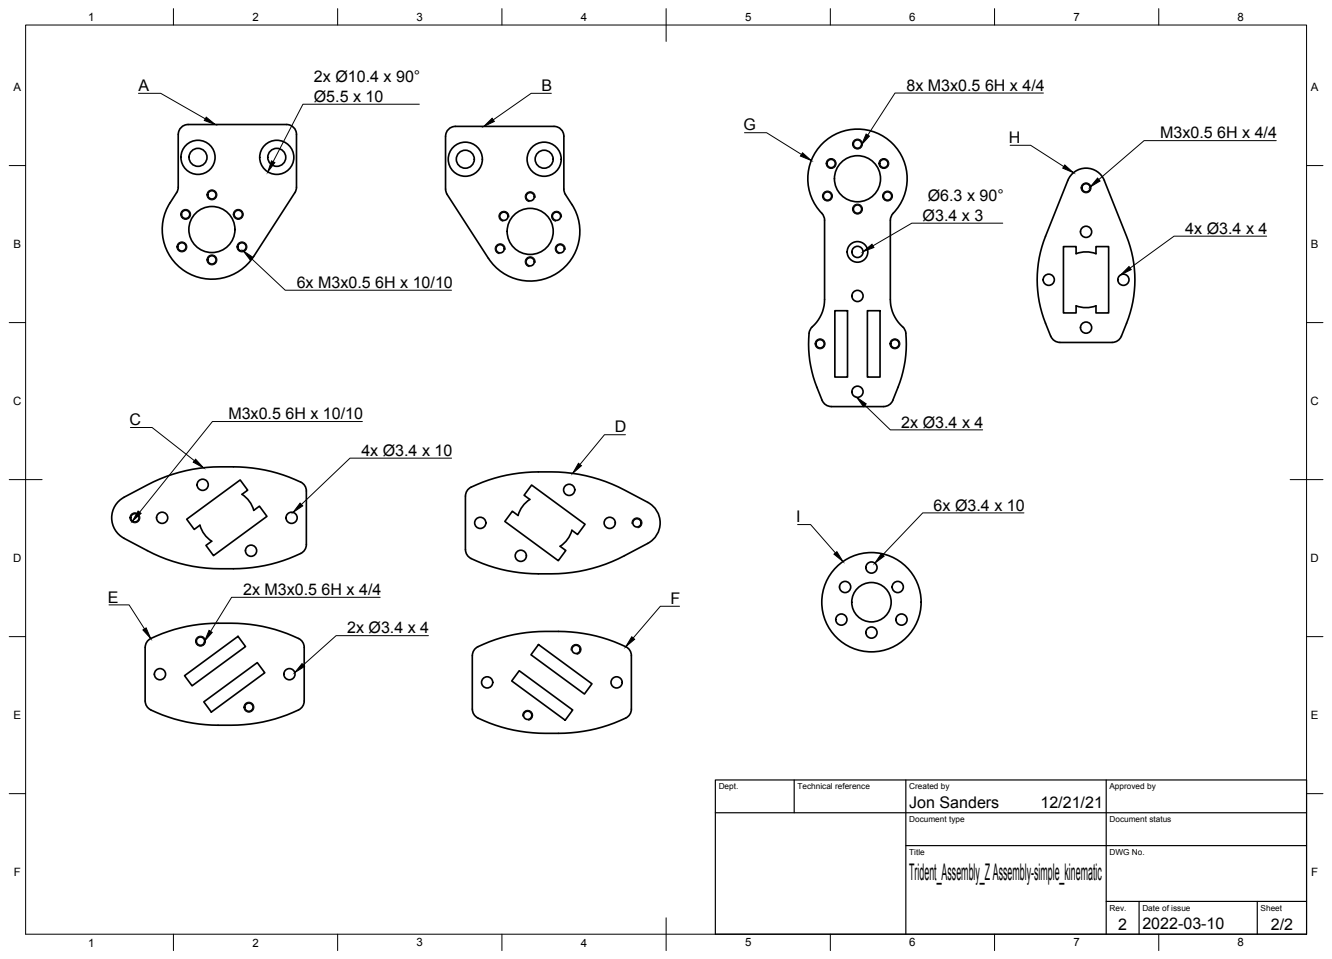
[picture p216: page 2]
Title; DWG No.; Rev.; Date of issue; Sheet; Trident_Assembly_Z Assembly-simple_kinematic

Dept. | Technical reference | Created by Jon Sanders 12/21/21 | Approved by

Document type | Document status
