tanaes/whopping_Voron_mods/kinematic_bed/DXFs/v24/F-back_bottom-drawing-rev2.pdf

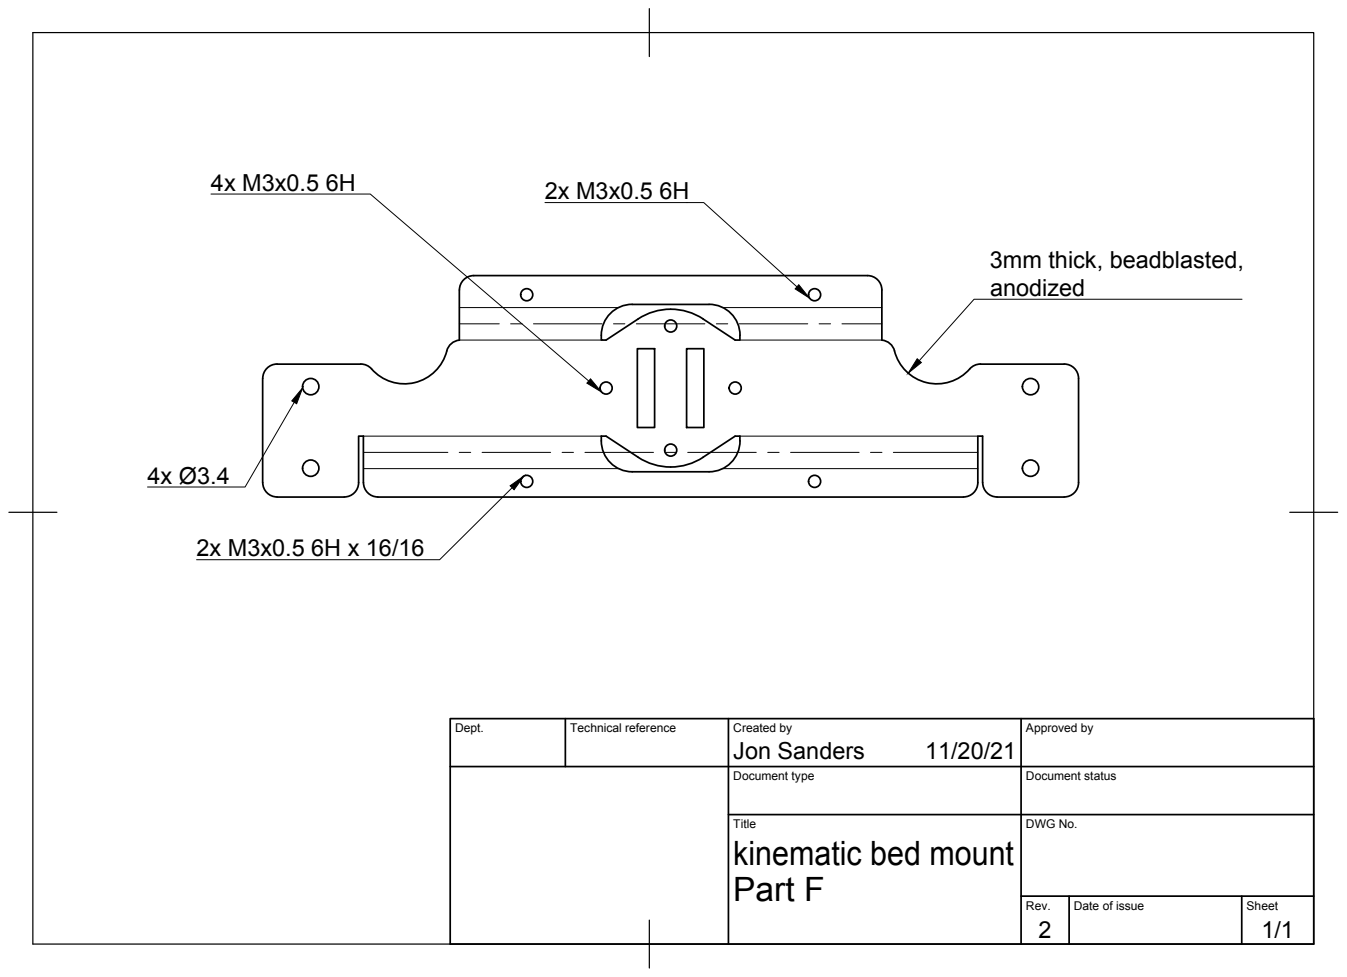
[picture p220: page 1]
3mm thick, beadblasted,

Dept. | Technical reference | Created by Jon Sanders 11/20/21 | Approved by

Document type | Document status

Title kinematic bed mount Part F | DWG No.

Rev. 2 | Date of issue | Sheet 1/1
