tanaes/whopping_Voron_mods/kinematic_bed/DXFs/v24/kinematic_drawings-partsA-EG.pdf

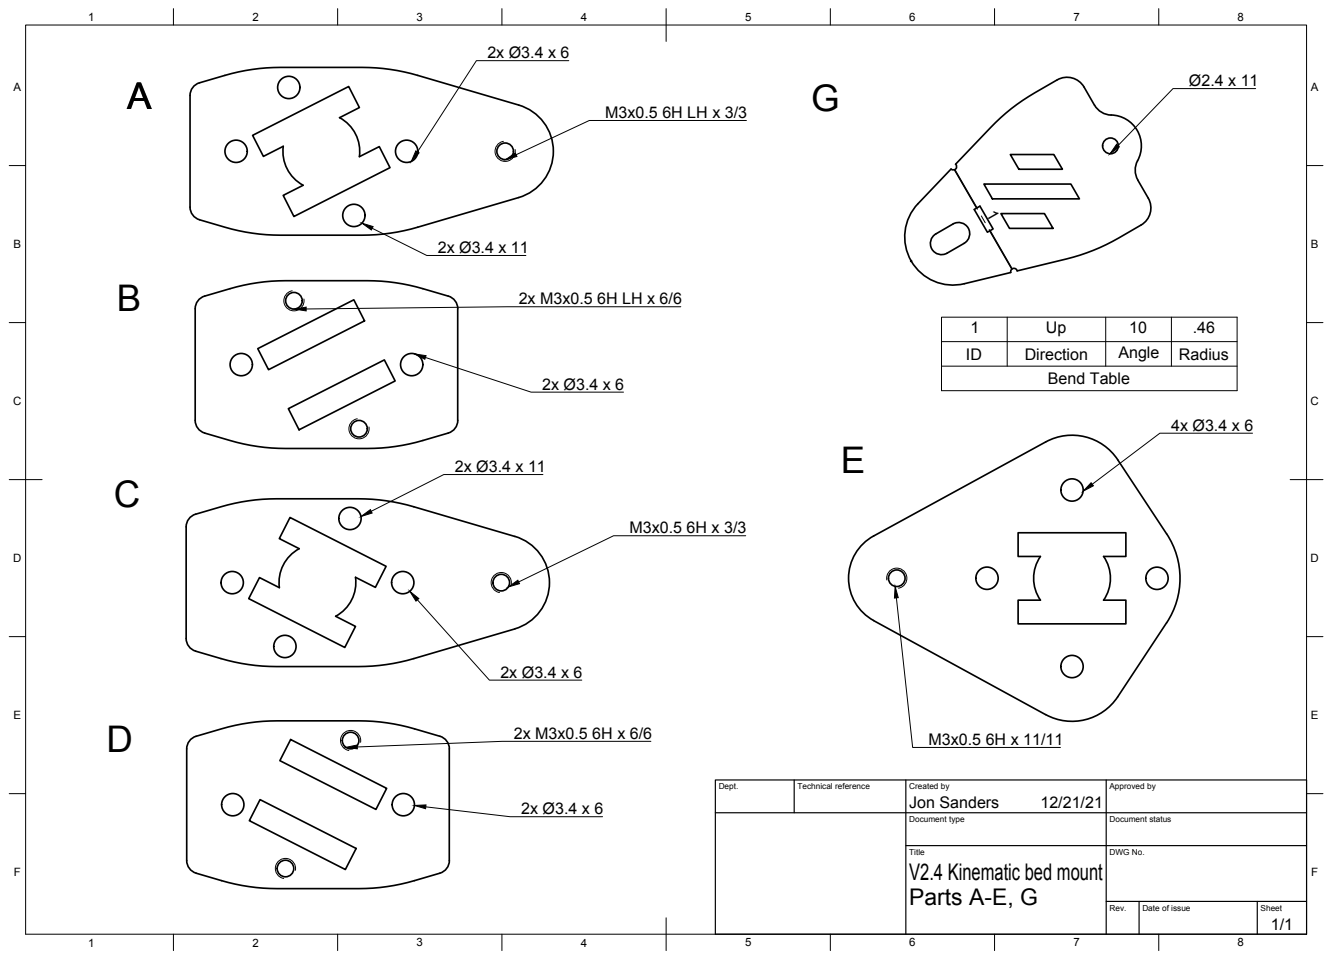
[picture p221: page 1]
Title; DWG No.; Rev.; Date of issue; Sheet; Bend Table

1 | Up | 10 | .46
ID | Direction | Angle | Radius

Dept. | Technical reference | Created by Jon Sanders 12/21/21 | Approved by

Document type | Document status

V2.4 Kinematic bed mount
Parts A-E, G
