tanaes/whopping_Voron_mods/badge/dfh_badge/soldermask copy.pdf

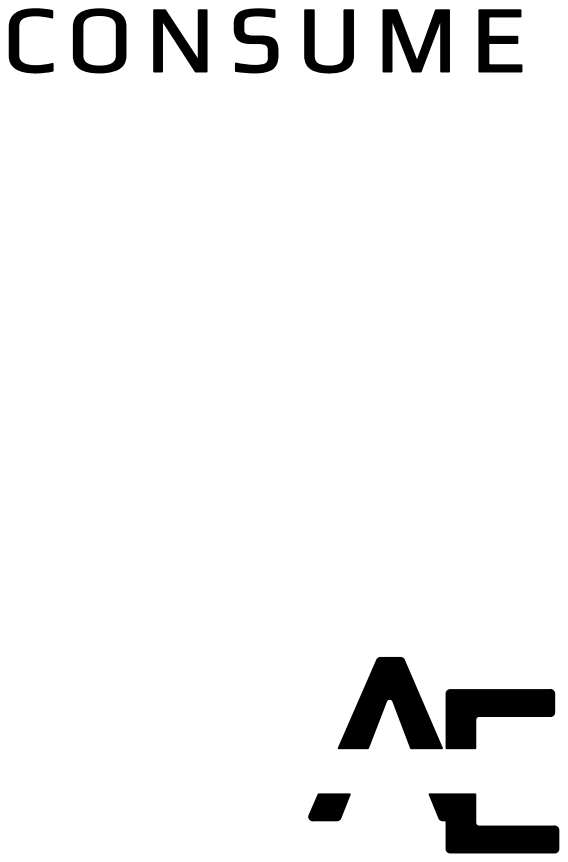
[picture p222: page 1]
