tanaes/whopping_Voron_mods/kinematic_bed/DXFs/v24/F-back_bottom.pdf

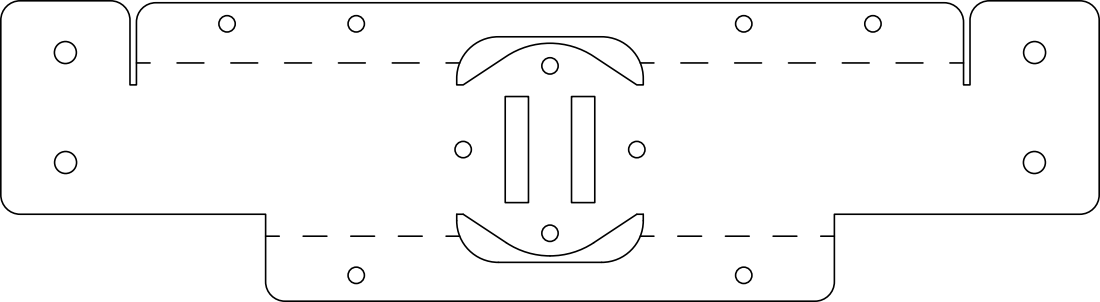
[picture p223: page 1]
