tanaes/whopping_Voron_mods/extrusion_backers/DXFs/Gantry_backers_parametric Drawing X_backer_chain.pdf

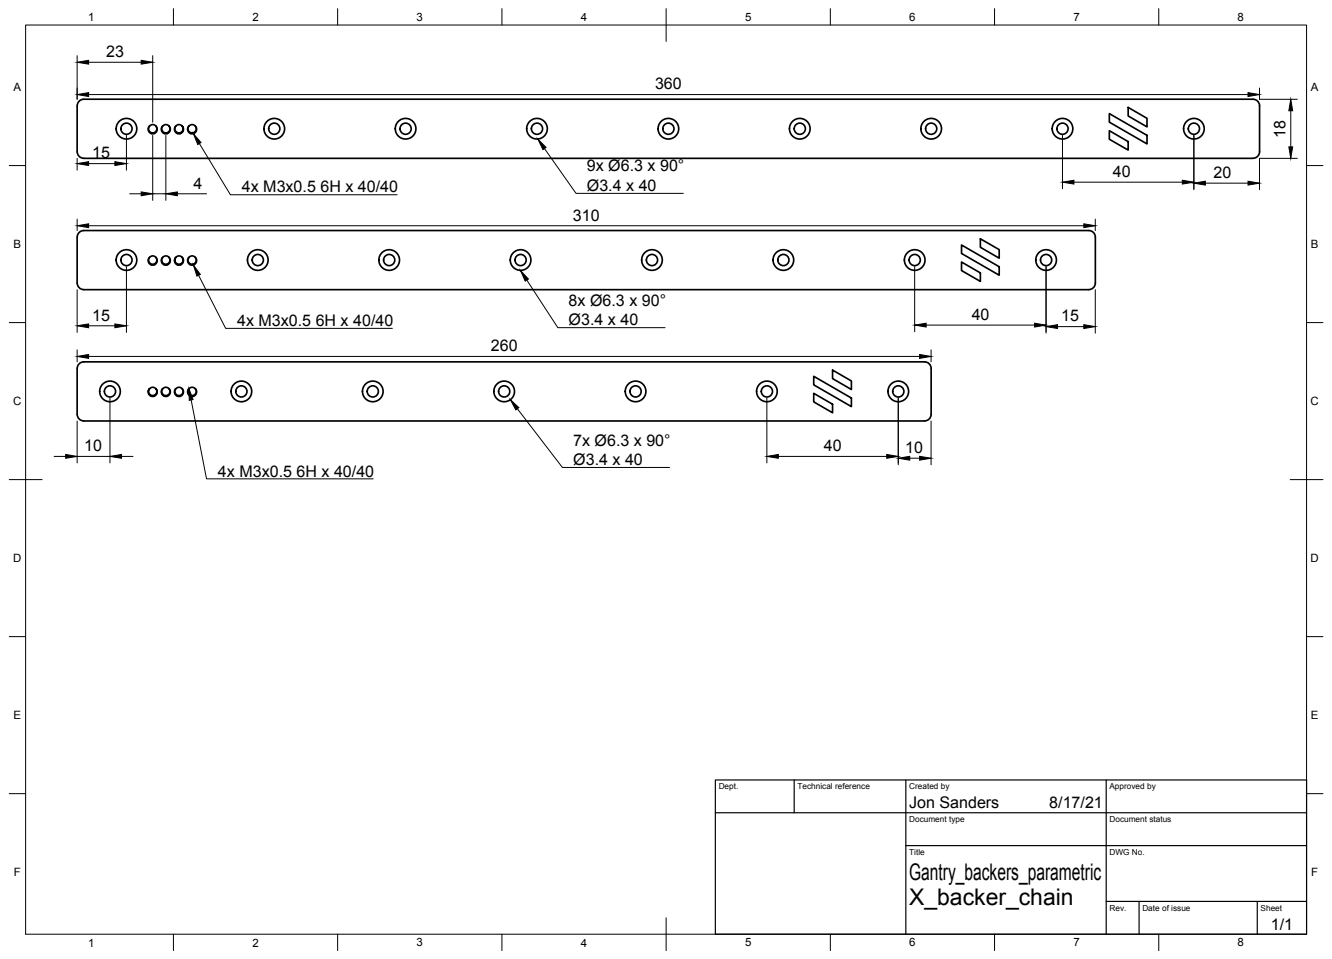
[picture p224: page 1]
Title; DWG No.; Rev.; Date of issue; Sheet

Dept. | Technical reference | Created by Jon Sanders 8/17/21 | Approved by

Document type | Document status
