tanaes/whopping_Voron_mods/pcb_klicky/Images/magnet Drawing v3.pdf

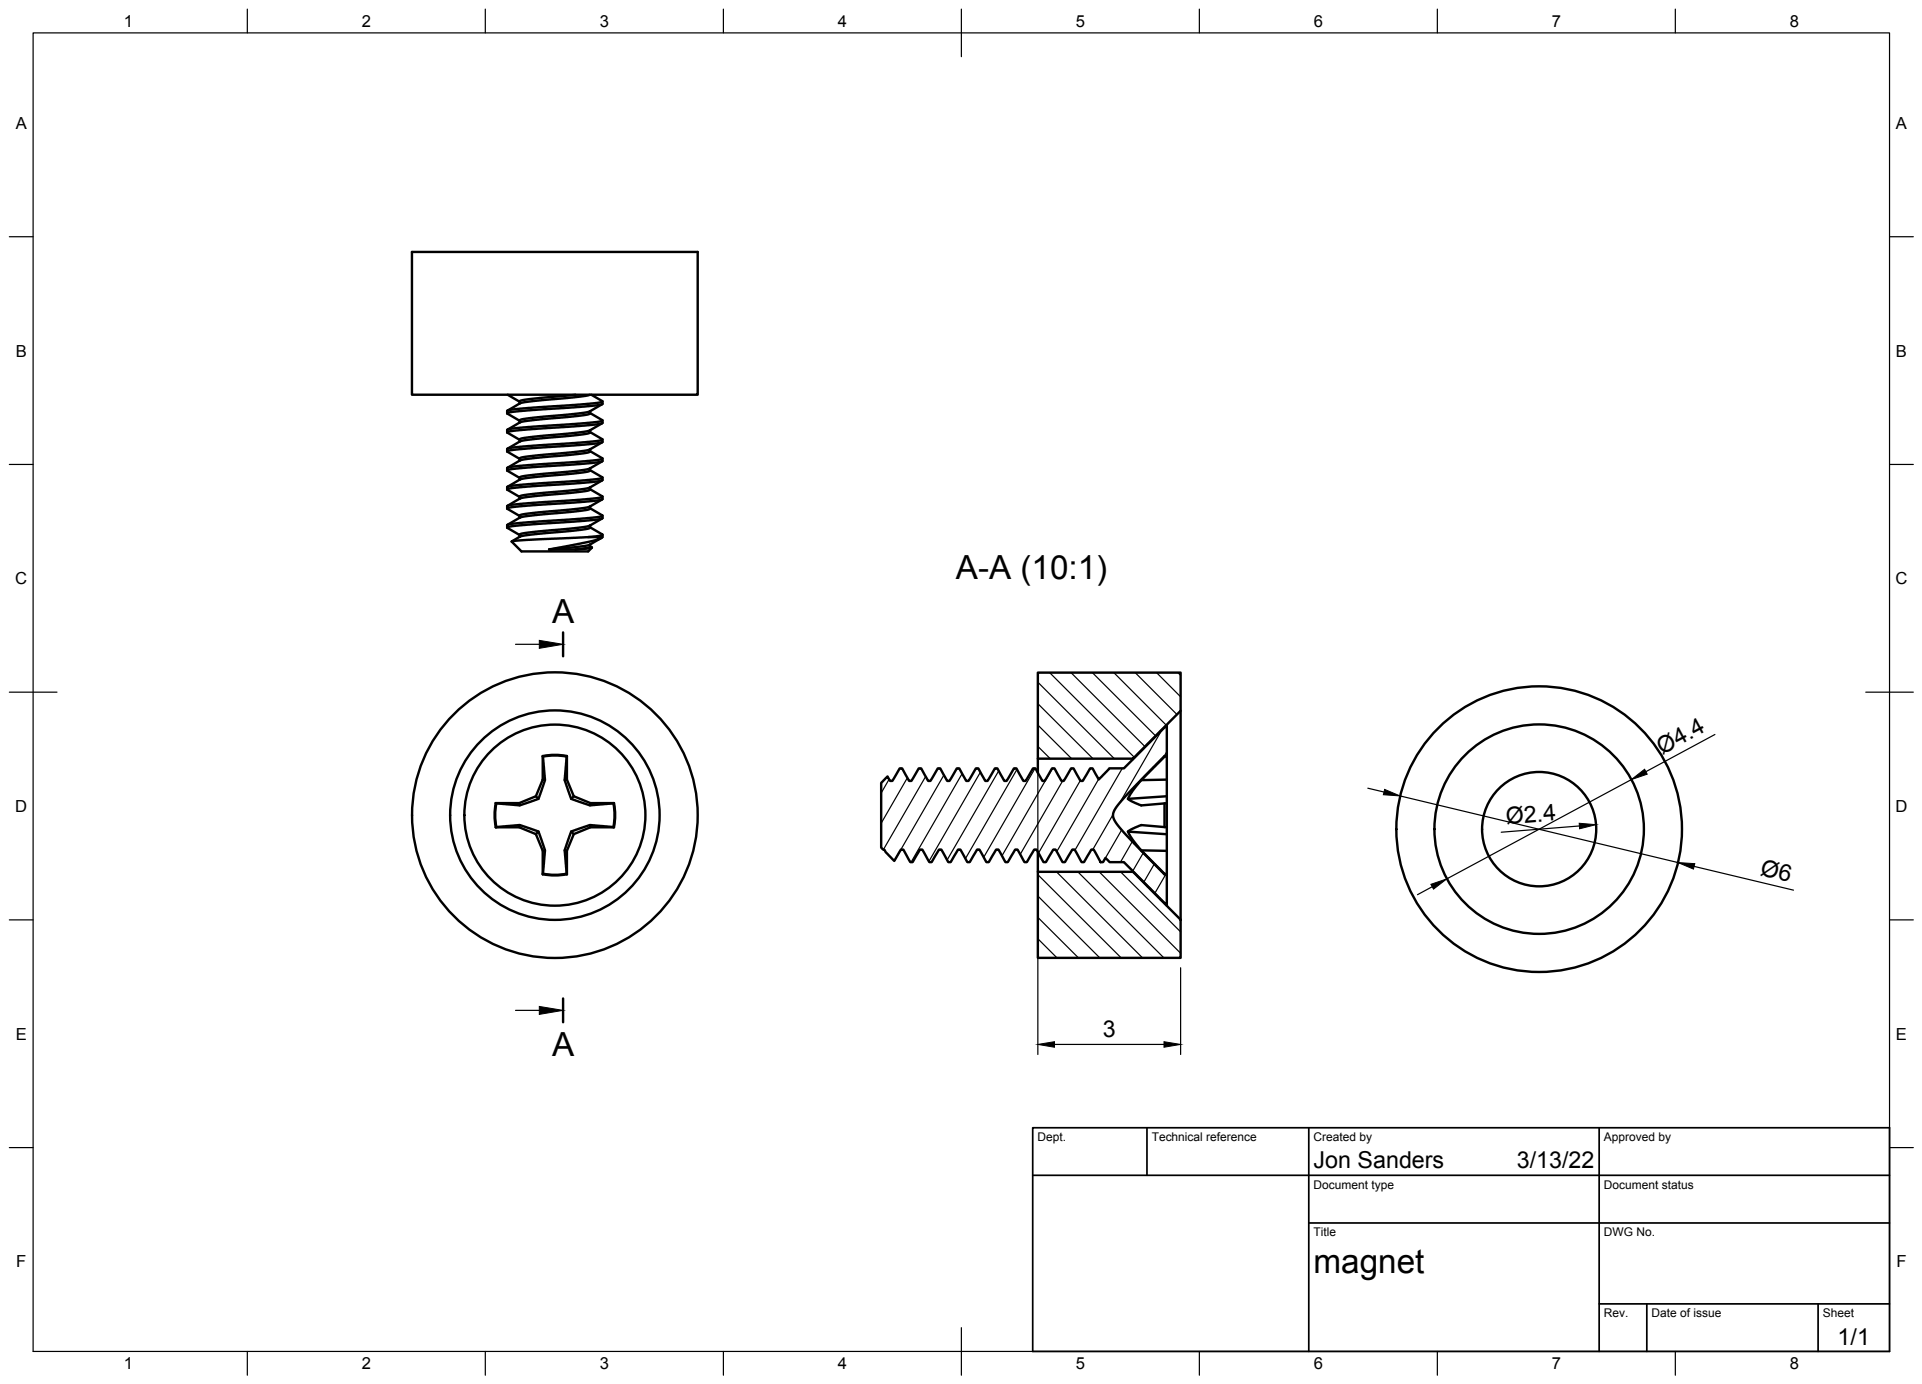
[picture p225: page 1]
Title; DWG No.; Rev.; Date of issue; Sheet

Dept. | Technical reference | Created by Jon Sanders 3/13/22 | Approved by

Document type | Document status
