tanaes/whopping_Voron_mods/(commit log)

2021-06-06 added Z belt cover mod
    [Z_belt_cable_route.f3d, Z_belt_cover_cable-route_L.stl, Z_belt_cover_cable-route_R.stl]
2021-06-11 added side skirt STL, CAD coming right up
    [side_skirt-plug_panel-350.stl]
2021-06-11 added CAD
    [Side Skirt A - plug panel 350.f3z]
2021-06-13 updated docs
    [frame_exp_quant_v3_2021-06-13_05-41-53.csv]
2021-06-14 reorganized and added data
    [expansion_quant_whoppingpochard#2514_2021-06-13_20-04-43.csv, expansion_test_print-Voron_ABS.3mf, frame_exp_quant_v3_2021-06-12_12-54-36-mvieleers_V2.1253.csv, frame_exp_quant_v3_2021-06-13_05-41-53.csv, frame_temp_v_pos_2021-06-05_13-24-32.csv, test_sample v1.stl]
2021-06-26 added klipper update instructions
2021-07-03 added extrusion backer project
    [X_backer_chain-200.dxf, X_backer_chain-250.dxf, X_backer_chain-300.dxf, X_backer_chain-350.dxf, Y_backer-200.dxf, Y_backer-250.dxf, Y_backer-300.dxf, Y_backer-350.dxf]
2021-07-25 updated to include panzer chain holes
    [X_backer_chain-250.dxf, X_backer_chain-300.dxf, X_backer_chain-350.dxf, Y_backer-250.dxf, Y_backer-300.dxf, Y_backer_chain-250.dxf, Y_backer_chain-300.dxf, Y_backer_chain-350.dxf]
2021-08-02 added Yeri's v1 DXFs
    [v1_Y_backer-250.dxf, v1_Y_backer-300.dxf]
2021-08-04 added STLs
    [LFRB_mount-250.stl, LFRB_mount-300.stl, LFRB_mount-350.stl, RFLB_mount-250.stl, RFLB_mount-300.stl, RFLB_mount-350.stl]
2021-08-04 removed interference
    [LFRB_mount-350.stl, RFLB_mount-350.stl]
2021-08-05 added modified chain bridge STLs
    [XY_cable_chain_bridge-3hole-3mm_backer.stl, XY_cable_chain_bridge-3hole-6.5mm_backer.stl, XY_cable_chain_bridge-Igus-3mm_backer.stl, XY_cable_chain_bridge-Igus-6.5mm_backer.stl]
2021-09-21 added clip shims
    [corner_clip-5.5mm.stl, corner_clip_shim-2mm.stl, midspan_clip-5.5mm.stl, midspan_clip_shim-2mm.stl]
2021-11-21 Added kinematic beta instructions
2022-01-07 updated frame expansion docs
2022-01-22 added drill guide
    [drill_guide.stl]
2022-01-27 added drilling instructions
2022-01-27 added info about longer z endstop
2022-02-02 updated sexbolt housing
    [sexybolt_owo.stl]
2022-02-04 added production files
    [A-front_right_top.dxf, B-front_right_bottom.dxf, C-front_left_top.dxf, D-front_left_bottom.dxf, E-back_top.dxf, G-spring.dxf]
2022-02-06 Added new drill guide STL
    This drill guide works with beds that have plain counterbored holes. Matches the Voron Design bed drawings.
    [drill_guide_standard.stl]
2022-02-06 Renamed drill_guide to drill_guide_slots
    Renamed the original drill guide to reflect that it is designed for beds with slots to the edge of the bed instead of plain holes.
    [drill_guide_slots.stl]
2022-02-06 Delete drill_guide.stl
    drill_guide was renamed to drill_guide_slots
    [drill_guide.stl]
2022-02-07 Update README.md
    1. Added note about the 4 TNuts you need to retrain at the top of the instructions as I missed that the first time.
    2. Updated the section about the mounts to mention the extra holes are threaded (they are on my retail kit from PrintyPlease) so no need to manually tap them.
    3. Added a link to the Wago STL in the Mods section as it wasn’t mentioned elsewhere including location based on Discord comments from Whopping.
2022-02-09 added trident assembly instructions
2022-02-11 added note about nonstandard bed spacing
2022-02-15 added link to endstop riser and note about heater clearance.
2022-02-16 added note about bed mount screw length
2022-02-18 added kinamatic cad
2022-02-18 added RBLL4SB
    [bom.csv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]
2022-02-28 updated STLs and readme
    [sandwich_spacers-back_center.stl, sandwich_spacers-front_left.stl, sandwich_spacers-front_right.stl, sexybolt_owo.stl]
2022-03-10 added centering washer STL
    [centering_washer.stl]
2022-03-14 added GE5C stls
    [GE5C_Z_carrier-hall_effect.stl, GE5C_Z_carrier.stl]
2022-03-17 added micron printed part
    [shortie_sexbolt_body.stl]
2022-03-22 updated GE5C stuff
    [GE5C_Z_carrier-hall_effect.stl, GE5C_Z_carrier.stl]
2022-03-22 oriented STLs omfg
    [GE5C_Z_carrier-hall_effect.stl, GE5C_Z_carrier.stl]
2022-03-25 Fix BOM
    Pretty sure those are M**5**×25, not M3×25, right?
2022-04-04 added F DXF
    [F-back_bottom.dxf]
2022-04-28 updated files
    [J-spring.dxf, Trident_kinematic-left.step, Trident_kinematic_left-base.dxf, Trident_kinematic_left-top.dxf, trident_A-left_bearing_plate.dxf, trident_B-right_bearing_plate.dxf, trident_C-left_top.dxf, trident_D-right_top.dxf]
2022-05-19 added build plate drawings
    [Universal Build Plate 250.step, Universal Build Plate 300.step, Universal Build Plate 350.step]
2022-05-21 updated for better heatset clearances
    [AB_mount-heatset.stl, probe-heatset.stl, probe-screw.stl]
2022-06-16 updated drill guide link
2022-07-12 added new dock for pcb klicky
    [dock-front_insert.stl]
2022-07-31 updated pcb klicky cad
2022-08-04 added LED holder STLs
    [[c]_stealthburner_LED_diffuser-beta3.stl, [o]_stealthburner_LED_carrier-beta2.stl]
2022-08-04 added preliminary CAD
2022-10-07 updated RB led STLs and README
    [[o]_stealthburner_LED_carrier-beta2.stl, led_carrier_rev2.stl]
2022-10-07 updated CAD
2022-10-20 added example code
    [stealthburner_led_effects_barf.cfg]
2022-11-02 slight geometry update to PCB klicky
    [AB_mount-heatset.stl, probe-heatset.stl]
2022-11-02 added probe part for larger switches
    [probe-heatset-XL.stl]
2022-12-11 updated with KiCad files
    [BOM-PCB_Klicky_KiCAD.csv, BOM-Untitled.csv, Klicky_PCB_-_SMD_BOM.csv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]
2022-12-11 cleaning up files
    [PCB_Klicky_Probe-B_Cu.gbl, PCB_Klicky_Probe-B_Mask.gbs, PCB_Klicky_Probe-B_Paste.gbp, PCB_Klicky_Probe-B_Silkscreen.gbo, PCB_Klicky_Probe-F_Cu.gtl, PCB_Klicky_Probe-F_Mask.gts, PCB_Klicky_Probe-F_Paste.gtp, PCB_Klicky_Probe-F_Silkscreen.gto]
2023-05-02 added badges
    [BOM-dfh_badge-front.csv, BOM-dfh_badge.csv, BOM-voron_badge.csv, RP2040_minimal-BOM.xlsx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]
2023-05-09 updated backers readme and dxfs
    [X_backer_chain-200.dxf, X_backer_chain-250.dxf, X_backer_chain-300.dxf, X_backer_chain-350.dxf, Y_backer-200.dxf, Y_backer-250.dxf, Y_backer-300.dxf, Y_backer-350.dxf]
2023-08-04 added door
    [Handle-Hinge_Bottom.stl, Handle-Hinge_Top.stl, Handle.stl, Hinge-L-sleeve-2X.stl, Hinge-L-solid-2X.stl, Latch.stl, Panel_Clip.stl, fasteners.csv]
2023-08-17 z joints beta release
    [compact_lower.stl, compact_lower_mirrored.stl, compact_upper.stl, lever.stl]
2023-09-26 removed troublesome folder
    [RP2040_minimal-BOM.xlsx, RP2040_minimal.kicad_pcb, RP2040_minimal.kicad_sch, RP2040_minimal.sch]
2023-10-13 added roll-in clearance on latch
    [Latch.stl]
2023-10-16 added umbilical passthrough
    [Front_Plate.stl, Hex Accent.stl, M12.5_cable_gland_housing.stl, M16_cable_gland_housing.stl, PTFE_fit_test.stl, UmbilicalBlankingBackPlate-L-3mm.stl, UmbilicalBlankingBackPlate-L-4mm.stl, UmbilicalBlankingBackPlate-L-6mm.stl]
2023-10-20 added pg7 gland housing
    [PG7_cable_gland_housing.stl]
