tanaes/whopping_Voron_mods/clickyclacky_door/Images/front_view.jpeg

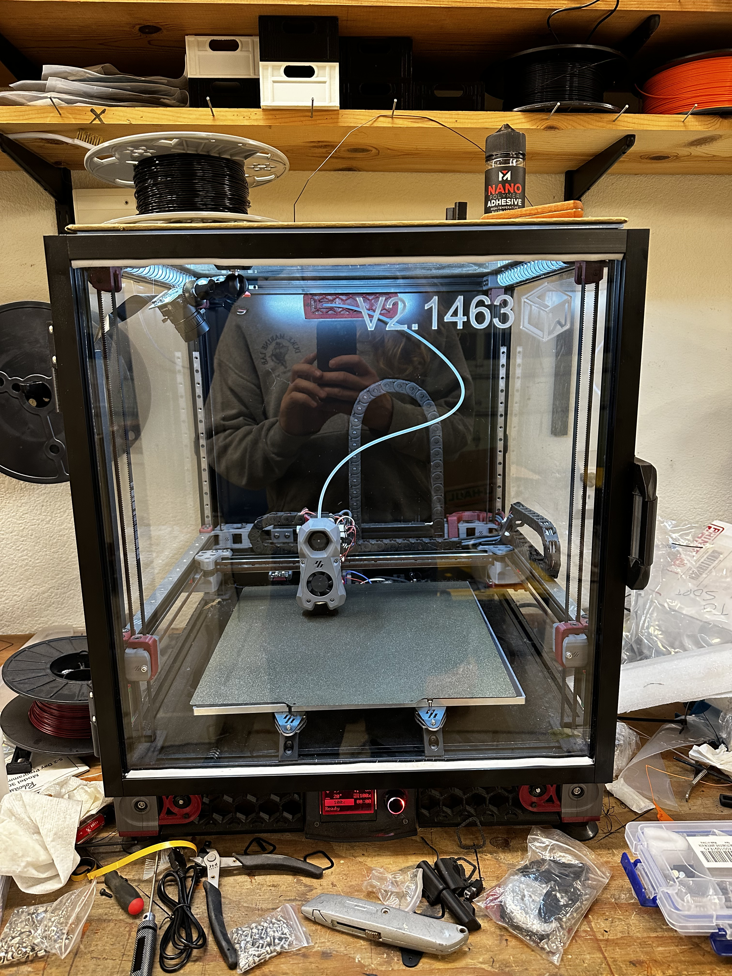
[picture p11: clickyclacky_door/Images/front_view.jpeg]
clickyclacky_door/Images/front_view.jpeg
